jabezmcc/Prooferator/photos/Lightbulb.jpg

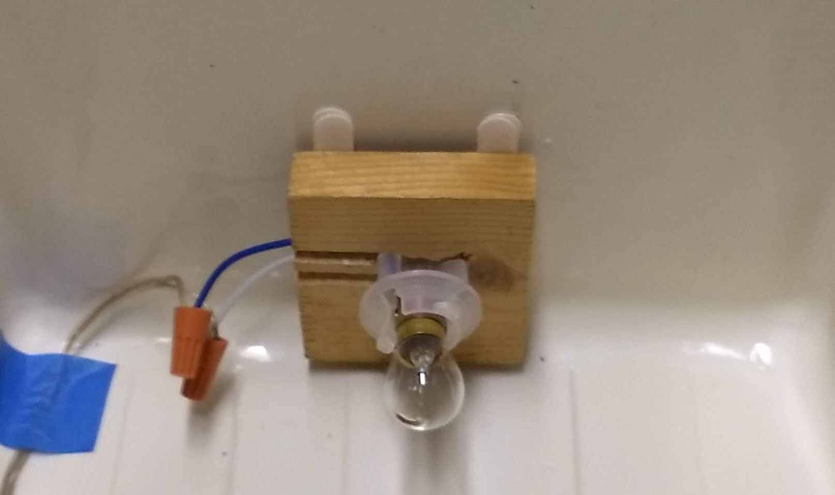
photos/Lightbulb.jpg
