jabezmcc/Prooferator/photos/Wall_wart.jpg

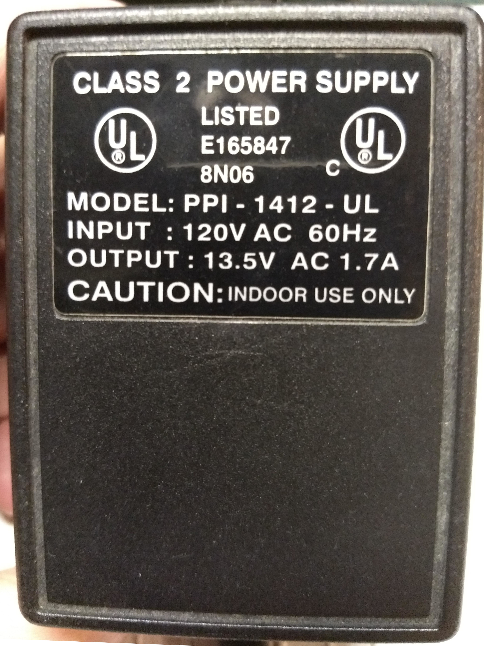
photos/Wall_wart.jpg
