jabezmcc/Prooferator/prooferator.py

# Prooferator - Arduino-controlled "proofing" box for bread dough
# (c) 2022, 2024 - Jabez McClelland jabezmcc@gmail.com
# 
# Revision history
#
# 6/22/2024 - 0.2.2: Added welcome window
#
# 6/18/2024 - 0.2.1: Fixed frozen stop button and added refresh temp button
#
# 6/9/2024 - 0.2.0:  Added threading and "updating arduino" message
#
# 3/12/2022 - 0.1.2: Trapped error when Arduino is unplugged.  Fixed initial readout window size. 
#                    Tweaked timing, changed data save query behavior.
#
# 1/22/20222 - 0.1.1: trapped possible bad inputs.  Added temp units to temp. display and y-axis
#
# 1/15/2022 - 0.1.0: First version
#
import sys
import os
import xlsxwriter
import datetime as dt
import time
import numpy as np
import serial
import pathlib
import re
import platform
import subprocess
import threading

from PyQt5.QtCore import QObject,  pyqtSignal
from PyQt5.QtWidgets import QApplication, QDesktopWidget, QFileDialog, QMessageBox
from PyQt5.uic import loadUiType

from matplotlib.backends.backend_qt5agg import FigureCanvasQTAgg as FigureCanvas
import matplotlib.pyplot as plt

Ui_MainWindow, QMainWindow = loadUiType('prooferator.ui') 
Ui_WelcomeWindow, QWelcomeWindow = loadUiType('welcomewindow.ui')
Ui_AboutWindow, QAboutWindow = loadUiType('aboutProoferator.ui')
Ui_UpdatingArduino, QUpdatingArduino = loadUiType('updating_arduino.ui')
vers = '0.2.1'

class Welcome(QWelcomeWindow, Ui_WelcomeWindow):
    def __init__(self):
        super(Welcome,self).__init__()
        self.setupUi(self)
        self.currentTemp = get_temp()
        self.setPoint = float(get_arduino_setpoint())
        self.gotNumber = self.currentTemp.replace('.','').isdigit()
        self.updateText()
        self.wradioButtonF.toggled.connect(lambda:self.unitchanged(self.wradioButtonF))        
        
    def updateText(self):
        # Do temperature label
        if self.gotNumber:
            temp = float(self.currentTemp)
            if self.wradioButtonF.isChecked():
                tempstring = '{:3.1f}'.format(temp*9./5. + 32)+'\xB0F'
            else:
                tempstring = '{:3.1f}'.format(temp)+'\xB0C'
            self.foundArduinoLabel.setText('Found Arduino...')            
        else:
            if self.wradioButtonF.isChecked():
                tempstring = self.currentTemp+'\xB0F'
            else:
                tempstring = self.currentTemp+'\xB0C'             
            self.foundArduinoLabel.setText('Arduino not found!')
        self.currentTempLabel.setText('Current temp: '+tempstring) 
        # Do setpoint label
        if self.wradioButtonF.isChecked():
            spstring = '{:3.1f}'.format(self.setPoint*9./5. + 32)+'\xB0F' 
        else:
            spstring = '{:3.1f}'.format(self.setPoint)+'\xB0C'
        self.currentSetpointLabel.setText('Current setpoint: '+spstring)

    def unitchanged(self,b):
        self.updateText()



class About(QAboutWindow, Ui_AboutWindow):
    def __init__(self):
        super(About,self).__init__()
        self.setupUi(self)
        self.versionLabel.setText("Version "+vers)
        self.licenseButt.clicked.connect(self.show_license)
        self.OKButt.clicked.connect(self.closeout)
        self.show()
        
    def show_license(self):
        p = platform.system()
        try:
            if p == 'Linux':
                subprocess.run(['xdg-open', 'LICENSE.txt'],check=True)
            elif p=='Windows':
                os.system('start LICENSE.txt')
            else:
                os.system('open LICENSE.txt')
        except:
             QMessageBox.warning(self,'Error','Unable to open license document')
                
    def closeout(self):
        self.close()

class UpdatingArduino(QUpdatingArduino, Ui_UpdatingArduino):
    def __init__(self):
        super(UpdatingArduino,self).__init__()
        self.setupUi(self)
        self.show()
        
class Helper(QObject):
    finished = pyqtSignal()

class Main(QMainWindow, Ui_MainWindow):
    plotexists = False
    takedata = True
    datasaved = False
    def __init__(self):
        super(Main,self).__init__()
        self.setupUi(self)
        self.actionExitButton.triggered.connect(self.exit)
        self.actionAbout.triggered.connect(self.openabout)
        self.startButton.clicked.connect(self.start_data)
        self.stopButton.clicked.connect(self.stop_data)
        self.updateButton.clicked.connect(self.update_setpoint)
        self.FradioButton.setText('\xB0F')
        self.FradioButton.toggled.connect(lambda:self.btnchanged(self.FradioButton))
        self.CradioButton.setText('\xB0C')
        cwd = str(pathlib.Path(__file__).parent.resolve())
        self.data_dest = cwd +'/proofingbox.xlsx'
        self.dataSaveLabel.setText('Data will be saved in '+self.data_dest)
        self.changeDataButton.clicked.connect(self.change_data_dest)
        self.refreshTemp.clicked.connect(self.single_reading)
        self.timeintervalBox.setText('0.1')
        self.setpointC = float(get_arduino_setpoint())
        self.setpoint = self.setpointC   
        if self.FradioButton.isChecked():
            self.currentTempLabel.setText('--.-\xB0F')
            self.setpointF = self.setpointC*9./5. + 32.
            self.setpointBox.setText('{:3.1f}'.format(self.setpointF))
            self.setpoint = self.setpointF
        else:
            self.currentTempLabel.setText('--.-\xB0C')
            self.setpointBox.setText('{:4.2f}'.format(self.setpointC))
        self.canvas = FigureCanvas(plt.Figure(figsize=(15, 6)))
        self.mainplot_layout.addWidget(self.canvas)
        self.ax = self.canvas.figure.subplots()
        self.ax.set_xlabel("Time")
        if self.FradioButton.isChecked():
            self.ax.set_ylabel("Temperature, \xB0F")
        else:
            self.ax.set_ylabel("Temperature, \xB0C")       
        self.ax.set_title("Proofing Box Temperature Log")
        self.ax.set_position([.15,.15,.75,.75])
        self.ax.tick_params(axis='both',direction='in')
        self.ax.set_ylim(self.setpoint*0.75,self.setpoint*1.25)
        self.ax.set_xlim(dt.datetime.now(),dt.datetime.now()+dt.timedelta(hours=2))
        self.rec_label.setText('')

    def btnchanged(self,b):
        if self.CradioButton.isChecked():
            self.setpointBox.setText('{:3.1f}'.format(self.setpointC))
        else:
            self.setpointBox.setText('{:3.1f}'.format(self.setpointF))
                
    def openabout(self):
        self.aboutwin = About()

    def single_reading(self):
        #print('in single reading')
        try:
            ser = serial.Serial('/dev/ttyACM0',9600, timeout=1)
            dummy = False
        except:
            QMessageBox.warning(self,'Prooferator','No Arduino detected, simulating data')
            dummy = True        
        if dummy:
            current_tempC = float(get_temp_dummy(self.setpointC))
        else:
            current_tempC = float(get_temp())
        if current_tempC==999.99:
            return
        current_temp = current_tempC
        unittext = '\xB0C'
        if self.FradioButton.isChecked():
            current_temp = current_tempC*9./5. + 32.
            unittext = '\xB0F'
        self.currentTempLabel.setText("{:3.1f}".format(current_temp)+unittext)
        #print('Temp is',current_temp)

    def start_data(self):
        self.takedata = True
        self.rec_label.setText('RECORDING')  
        try:
            ser = serial.Serial('/dev/ttyACM0',9600, timeout=1)
            dummy = False
        except:
            QMessageBox.warning(self,'Prooferator','No Arduino detected, simulating data')
            dummy = True
        self.wb = xlsxwriter.Workbook(self.data_dest)
        wbtimefmt = self.wb.add_format({'num_format': 'mmm d yyyy hh:mm:ss'})
        ws = self.wb.add_worksheet()
        ws.set_column(0,0,20)
        ws.set_column(1,1,15)
        ws.write(0,0,'Time')
        ws.write(0,1,'Temperature')
        times = []
        temps = []
        count = 0
        self.ax.cla()
        self.ax.set_xlabel("Time")
        if self.FradioButton.isChecked():
            self.ax.set_ylabel("Temperature, \xB0F")
        else:
            self.ax.set_ylabel("Temperature, \xB0C")  
        self.ax.set_title("Proofing Box Temperature Log")
        deltat = 0.1
        while self.takedata:
            try:
                interval = 60.*float(self.timeintervalBox.text())
            except:
                QMessageBox.warning(self,'Prooferator error','Invalid entry for time interval')
                break 
            count += 1
            elapsed_time = 0.0
            while elapsed_time < interval:
                time.sleep(deltat)
                QApplication.processEvents()
                if not self.takedata:
                    break
                elapsed_time += deltat
            if not self.takedata:
                break
            if dummy:
                current_tempC = float(get_temp_dummy(self.setpointC))
            else:
                current_tempC = float(get_temp())
            if current_tempC==999.99:
                break
            current_temp = current_tempC
            if self.FradioButton.isChecked():
                current_temp = current_tempC*9./5. + 32. 
            times.append(dt.datetime.now())            
            temps.append(current_temp)
            unittext = '\xB0C'
            if self.FradioButton.isChecked():
                 unittext = '\xB0F'
            self.currentTempLabel.setText("{:3.1f}".format(current_temp)+unittext)
            ws.write(count,0,times[-1],wbtimefmt)
            ws.write(count,1,temps[-1])
            print('plotting point',count)
            print('Current temp = ',current_temp)            
            self.plot_data(data=[times,temps])


    def plot_data(self,data=[[0],[0]]):
        if self.plotexists:
            self.lin.remove()
        self.lin, = self.ax.plot(data[0],data[1],color='blue')
        self.canvas.draw()
        self.canvas.flush_events()
        self.plotexists = True       
    
    def stop_data(self):
        self.takedata = False
        self.rec_label.setText('')
        qbox = QMessageBox.question(self,'Prooferator','Do you want to save data?',QMessageBox.Yes,QMessageBox.No)
        if self.plotexists:
            if qbox == QMessageBox.Yes:
                self.wb.close()
                self.datasaved = True
                QMessageBox.information(self,'Prooferator','Acquisition finished.\nData saved in'+self.data_dest)
        else:
            QMessageBox.information(self,'Prooferator','Please record some data first.')    

    def update_setpoint(self):
        try:
            self.setpoint = float(self.setpointBox.text())
        except:
            QMessageBox.warning(self,'Prooferator error','Invalid entry for setpoint')
            return
        self.setpointC = self.setpoint
        if self.FradioButton.isChecked():
            self.setpointC = (self.setpoint - 32.)*5./9.
        self.window = UpdatingArduino()
        
        qtRectangle = self.window.frameGeometry()
        centerPoint = QDesktopWidget().availableGeometry().center()
        qtRectangle.moveCenter(centerPoint)
        self.window.move(qtRectangle.topLeft())
        self.window.show()
        self.helper = Helper()
        self.helper.finished.connect(self.window.close)
        self.container = {'sp':self.setpointC}
        threading.Thread(target=update_arduino, args=(self.helper,self.container)).start()
        self.helper.finished.connect(self.reportoutcome)
    
    def reportoutcome(self):
        if self.container['error']:
            QMessageBox.warning(self,'Prooferator','Unable to program Arduino.\nCheck connections.')
        else:
            QMessageBox.information(self,'Prooferator','Arduino successfully updated.')
            
    def change_data_dest(self):
        fileName, _ = QFileDialog.getSaveFileName(self,"Select data destination file","./","Excel files (*.xlsx)")
        if fileName:
            strfN = str(fileName)
            if strfN[-5:] != '.xlsx':
                strfN = strfN + '.xlsx'
            self.data_dest = strfN
            self.dataSaveLabel.setText('Data will be saved in ' + strfN) 

    def exit(self):
        if not self.datasaved:
            qbox = QMessageBox.question(self,'Prooferator','Do you want to save data?',QMessageBox.Yes,QMessageBox.No)
            if qbox==QMessageBox.Yes:
                self.takedata=False
                self.rec_label.setText('')
                try: 
                    self.wb.close()
                    self.datasaved = True
                except:
                    pass
                sys.exit()
            else:
                self.takedata=False
                self.rec_label.setText('')
                sys.exit()
        else:
            sys.exit()

    def closeEvent(self,event):
        if not self.datasaved:
            qbox = QMessageBox.question(self,'Prooferator','Do you want to save data?',QMessageBox.Yes,QMessageBox.No)
            if qbox==QMessageBox.Yes:
                self.takedata=False
                self.rec_label.setText('')
                try:
                    self.wb.close()
                    self.datasaved = True
                except:
                    pass
                event.accept()
            else:
                self.takedata=False
                self.rec_label.setText('')
                event.accept()
        else:
            event.accept()

def get_arduino_setpoint():
    # returns last programmed arduino setpoint in C as text
    filename = './arduino_folder/proofingbox/proofingbox.ino'
    fin = open(filename,'r')
    lines = fin.readlines()
    fin.close()
    for line in lines:
        s = re.search(r'setPoint = (\d\d.\d\d)',line)
        if s:
            return s.group(1)
            
def get_temp():
    # returns current temp in C as text
    try:
        ser = serial.Serial('/dev/ttyACM0',9600, timeout=1)
    except:
        return '--.-'
    time.sleep(2)
    try:
        rawdata = ser.readline()
        temperature = rawdata.decode('UTF-8').strip('\n')
    except:
        print('Error reading temperature')
        temperature = 20.0 # Kludge in case of error 
    return temperature

def get_temp_dummy(setpoint):
    temperature = setpoint + 5.*(np.random.rand()-0.5)
    return "{:4.2f}".format(temperature)

def update_arduino(helper,container):
    setpointtext = "{:4.2f}".format(container['sp'])
    print('UpdatingArduino with setpoint = ',setpointtext)
    filename = './arduino_folder/proofingbox/proofingbox.ino'
    os.system('cp '+filename+' '+filename+'.bak')
    fin = open(filename,'r')
    lines = fin.readlines()
    fin.close()
    newlines = []
    p = re.compile(r'setPoint = \d\d\.\d\d')
    for line in lines:
        newlines.append(p.sub('setPoint = '+setpointtext,line))
    fout = open(filename,'w')
    fout.writelines(newlines)
    fout.close()
    u = os.system('arduino --upload '+filename)
    if u:
        container['error']=True
        os.system('cp '+filename+'.bak '+filename)
    else: 
        container['error']=False
    helper.finished.emit()

if __name__=="__main__":
    app = QApplication(sys.argv)
    welcome = Welcome()
    welcome.exec()
    main = Main()
    qtRectangle = main.frameGeometry()
    centerPoint = QDesktopWidget().availableGeometry().center()
    qtRectangle.moveCenter(centerPoint)
    main.move(qtRectangle.topLeft())
    main.show()
    sys.exit(app.exec())
