jabezmcc/Prooferator/bread_img_rc.py

# -*- coding: utf-8 -*-

# Resource object code
#
# Created by: The Resource Compiler for PyQt5 (Qt v5.15.2)
#
# WARNING! All changes made in this file will be lost!

from PyQt5 import QtCore

qt_resource_data = b"\
\x00\x01\x33\x66\
\x89\
\x50\x4e\x47\x0d\x0a\x1a\x0a\x00\x00\x00\x0d\x49\x48\x44\x52\x00\
\x00\x00\xc8\x00\x00\x00\x8c\x08\x06\x00\x00\x00\x39\x91\xe6\xe4\
\x00\x00\x2a\x42\x7a\x54\x58\x74\x52\x61\x77\x20\x70\x72\x6f\x66\
\x69\x6c\x65\x20\x74\x79\x70\x65\x20\x65\x78\x69\x66\x00\x00\x78\
\xda\xa5\x9c\x69\x92\x1d\x39\xce\x65\xff\x73\x15\xb5\x04\xce\x04\
\x97\xc3\xd1\xac\x77\xd0\xcb\xef\x73\x19\x2f\x94\x0a\x95\xea\x1b\
\xac\xa5\xcc\x54\xe4\x1b\xdc\x49\x10\xb8\x03\x09\x97\x3b\xff\xf7\
\xff\x5c\xf7\xaf\x7f\xfd\x2b\x78\x1f\xa3\xcb\xa5\x59\xed\xb5\x7a\
\x7e\xe5\x9e\x7b\x1c\xfc\x60\xfe\xeb\xd7\x7d\xff\x0d\x3e\xbf\xff\
\xbe\x5f\xeb\xfb\xbd\xf0\xf3\x75\x67\xeb\xf3\x46\xe4\xa5\xc4\x9f\
\xe9\xf3\x85\xf8\xeb\x62\xc1\xeb\xe7\xf6\xf3\x42\xc1\x7f\x5e\xef\
\x9f\x0b\xed\xef\x1b\x7c\x5f\x28\xfc\xba\xe3\xd7\x1f\x83\x9f\xca\
\x3f\xff\xbf\xc7\xe7\xf5\xf9\xf3\x75\x77\x3e\x77\x8e\xf6\xc7\x85\
\x3e\xaf\xa7\xf0\xb9\xf3\xe7\x8e\xe7\x73\xa1\x14\xbf\x5e\x0f\xf9\
\x73\xa1\x6b\xbf\x46\x14\xdf\x85\xe2\x6f\x17\xd2\x07\xd3\xe7\xf5\
\x3f\x46\x5a\xbb\xb5\x1f\x31\xf2\xeb\xeb\xc7\x58\xcc\x7e\x7f\x83\
\x29\xa4\x4f\x4c\xbe\xee\x69\xff\xfc\x9b\x5b\xbd\xfc\x6e\x75\x55\
\x4d\x8e\x19\xd6\xee\x58\xb3\x52\x89\x6c\x4a\xf5\xeb\x82\x9f\x0b\
\x7f\x5f\xf0\xcf\xff\xcf\x8d\xb5\xdd\x45\xc3\x8c\xf1\x24\x0d\xf8\
\xa4\x94\x18\xd1\x9b\x6f\xd2\xbf\x31\x0d\xfe\x0c\xfc\x37\xa4\x1a\
\xf5\x93\xff\xfa\xf9\xfd\x97\xf1\x45\x56\xa8\x0f\x8b\xbf\x07\xf9\
\x9e\xaf\x60\xb8\xbe\x7f\xbe\xe1\xeb\xd7\x94\x62\x64\xaa\x7f\x09\
\x7e\x6c\x3f\x5f\x9f\xf7\x3b\x46\x4a\x04\xe5\xc8\x27\xfa\x6f\x6c\
\x89\xb5\x4a\xdd\xff\xbe\x2a\xfe\x7c\x32\x2c\xff\x7c\x3d\x7e\x2d\
\x85\x77\xc1\x7f\xbd\xf1\x9d\x70\xe9\x33\xa2\x10\xfe\x78\xfd\x73\
\xa1\x10\x7f\xbe\x9e\x3f\x9f\x77\x3e\xf4\xf0\xfb\x88\x5e\x76\xbc\
\xa1\xf7\xe8\xc7\x6f\x41\xfe\x1e\x51\xec\x3f\x42\x51\x7e\x5d\x28\
\xfd\xfc\x42\xf9\x67\x0a\x3f\x5e\xaf\x9f\x2f\xf8\xf2\xf3\x42\xf5\
\x7c\x5f\xa8\xfe\x7c\xa3\x7d\x7f\xa1\xf5\xf8\xb7\x60\xfb\xfe\xf3\
\xf5\x60\xdf\xc1\x1e\x7f\x5c\xe8\x73\x87\xee\x7b\x7c\x5f\xfe\x5e\
\x84\x9a\xba\xde\xe8\xe1\xef\xaf\xbb\x1e\xff\xfe\x86\xd7\xbc\x7e\
\xae\xa6\xf2\x8a\x91\x0d\xff\xa3\x02\xc8\x80\x4f\x8c\x7e\xbe\x91\
\xca\x17\x30\x84\x36\xfe\x3e\xb5\x40\xd6\xb6\x7f\xaf\x3d\x56\x6d\
\xe4\xbf\x15\x25\x77\xfe\xf9\xfa\xf7\xaf\xf4\xf7\xd7\x9d\xcf\xbc\
\xf1\x5b\x8c\xec\xd7\xea\xfc\xfc\x42\x98\xdf\x99\xff\x9f\x2e\x64\
\xff\xe1\xce\xfd\x3f\xbc\x3e\xfe\xd3\x85\xd6\xdf\xa7\x46\x12\x65\
\xc5\x25\x7e\x8f\xf4\xb3\x9a\x29\x7d\xbd\xfe\x9d\xd9\xf3\x03\xce\
\x2e\xe5\xcf\x17\x3e\xc1\x9c\xf6\x8d\xda\x1f\x8c\x4e\xe3\xbd\x93\
\x7d\x8e\x22\x83\xf9\x59\xc5\xfa\xbd\x9a\x1f\xe4\x70\xbf\xa0\xc3\
\x27\xd3\x32\xb1\xf8\x23\x15\xca\x76\x24\xc1\xcc\xbf\x43\xcc\x7f\
\xf8\x9c\x8b\x9b\x17\xcb\xfb\xc0\xd7\x94\xfe\x9b\xff\x5f\xe3\x6b\
\xf2\xdf\x23\x1a\x1f\x0c\x77\xdf\x2f\xc4\xf4\x73\xc8\xbf\x7e\xd5\
\x9f\x5f\xf8\x7e\xff\xd8\xaf\x3f\xbf\x62\x54\x2c\x84\xdf\x5f\xf8\
\xf5\xeb\x3b\x41\xad\x46\xc0\x38\xa4\x58\x2b\xff\xa6\x94\xf9\xdd\
\x6a\xae\xfc\x59\x63\x32\x8d\x54\xbf\xdd\xf7\x0f\x7f\xfe\xfe\xc2\
\xe7\x7f\x07\xf9\xdf\x31\x3e\x7a\x6e\x12\x6a\xaa\x33\x32\x35\x5e\
\xa8\xbb\x96\x16\xf5\x46\xca\x40\xb9\xee\xb5\xeb\xe6\x63\x35\xde\
\x14\x78\xc5\xfc\xa7\xa2\x3e\x23\xcd\xbf\xca\x26\x7e\xbf\xe6\xbe\
\xf9\xeb\x03\x5e\xff\xd4\x55\xf9\x87\xbe\x89\x4b\xfe\x54\xae\xff\
\xfd\xf3\xe5\x93\x4b\x7a\xd7\xfd\xfe\x85\xb6\x3e\x5f\xf8\x2e\x99\
\xf0\x97\xc0\xff\x56\x4e\xfd\xfb\x06\xed\x8f\x0b\xf5\xcf\x85\x82\
\xff\x79\xe7\xfc\xa1\xeb\xb7\x2c\xbf\x5d\x68\x7e\x2e\x14\xf6\xf7\
\xd4\x3e\xf3\x9f\xcb\xff\x58\xfc\x58\xff\x58\xc1\xf9\xf3\xff\x6d\
\x7f\x15\x4a\x7d\x53\xfb\xed\x8e\xbf\xa6\x52\x7e\xfe\xff\x68\x5f\
\xd9\xf4\x9d\x43\x76\x42\xfb\x91\x73\xe7\x73\xa1\xdf\x40\xed\xa7\
\xa4\xf9\x23\xa7\xc2\xfa\x63\x84\xbf\x95\x8f\xfb\xae\x9f\xaf\x20\
\x3d\x0a\xfe\x81\x98\xbf\x05\xfc\x87\x42\xfb\xf5\xd3\x47\xb9\xb9\
\x5f\x81\x4b\x7f\x57\x6e\x20\x71\xf9\x2c\xfd\x4f\xfd\x54\x7f\xfd\
\xf9\x5e\x77\x7f\xbe\x11\xca\x1f\x5f\x48\xbf\x11\xe7\x6f\x23\xca\
\xdf\x91\x8c\x5f\xaf\xff\xba\xd0\xf9\x05\x61\x9f\x5f\xbf\xe9\xa1\
\x7b\xb7\xdd\x37\xe7\x20\x64\xae\x08\x9b\xfa\x99\xd4\xf7\x14\xc3\
\x0b\x36\x1f\x64\x61\x73\x7a\x5f\xab\xfc\xd6\x2a\x15\x7e\x6e\xef\
\x37\x14\xc7\xcf\xc3\x2f\x84\xc3\x46\x98\x4d\x7e\x2f\x98\x3e\xc2\
\x4f\x37\xe4\xb0\xc3\x08\xd7\x85\xf3\x7e\x58\x81\x42\x8c\x54\x5a\
\x6c\xfc\x19\xe3\x8a\xe9\xbd\x66\xa9\x41\x7c\xeb\x81\x9a\xea\x3e\
\x87\x1b\x1b\xa0\xb6\xa9\xfb\x98\xd6\x13\x59\x39\xc5\x7b\xdd\x67\
\x2c\xe1\xdd\xb7\xbf\xfb\x2d\x68\x78\xfb\x1d\xf8\x68\x0c\x5c\x2c\
\xbc\x25\xfe\x6f\x7e\xbb\xff\xc9\x87\xfe\xab\xdf\xf7\xae\x57\x3c\
\x4e\xc1\x9c\xe9\x05\x8c\xff\x3e\x0a\x60\x18\x5a\x39\xfd\x97\x8f\
\xb1\x22\xe1\xdb\x01\x94\x17\xe0\xef\xdf\x7f\xd0\xd1\xb7\x22\x12\
\x4d\x2a\xcc\xc6\x04\x07\x8a\xee\x5d\x62\x96\xf0\x4f\x6e\xa5\xb7\
\xd0\x89\xcf\x15\xff\x5d\xf7\xa1\xed\xaf\xef\xeb\x42\x99\x7b\x17\
\x06\x13\x12\x4b\xe0\x41\xd5\x12\x50\xb8\x2d\xc6\x16\x02\x81\x34\
\x16\x68\x04\x6f\x11\xd4\x9b\xac\x40\x28\x25\x6e\x06\x19\x33\x28\
\xc9\xda\x40\x2a\xdc\xda\xf1\x9d\x16\xde\x67\x63\x89\x5f\xaf\x63\
\x6c\x58\x89\x82\x2e\x69\xac\x0d\xb4\xc3\x62\xe5\x5c\xc8\x9f\x96\
\x8d\x1c\x1a\x25\x95\x5c\x4a\x01\x56\x8b\x95\x5e\x06\x28\x9b\x1d\
\x08\x5c\x41\x65\x39\xa4\xd1\x52\xcb\xad\xb4\xda\x5a\xb3\xd6\xdb\
\xb0\x64\xd9\x8a\x55\x43\xc9\x5a\x37\x94\x54\x4f\x18\xa8\xd2\x81\
\xee\x6e\xbd\xf7\x31\xb8\xe7\xe0\xca\xa3\xba\xc1\xe7\x07\xaf\xcc\
\x38\xd3\xcc\xb3\xcc\x3a\xdb\xb4\xd9\xe7\x58\xa4\xcf\xca\xab\xac\
\xba\xda\xb2\xd5\xd7\xd8\x90\xdc\x46\xad\x03\xe8\x6d\xdb\xee\x7b\
\x9c\x70\x48\xa5\x93\x4f\x71\xa7\x9e\x76\xec\xf4\x33\x2e\xb9\x76\
\xd3\xcd\xb7\x40\x1d\xed\xda\xed\x77\xfc\x5a\xb5\xcf\xaa\xfe\xdb\
\xef\xff\xc5\xaa\x85\xcf\xaa\xc5\xb7\x52\xfa\x5c\xfb\xb5\x6a\xbc\
\xda\xbe\x44\x57\x74\x2f\x5f\xb8\x88\xd6\x8c\x15\x8b\x39\xb0\xe2\
\x4d\x2b\x40\x42\x47\xad\x99\xb7\x90\x73\xd4\xca\x69\xcd\x90\x96\
\x54\x45\x89\x0c\xb2\x68\x6d\x76\xf0\x23\xd4\x98\x51\x23\x27\xc4\
\x72\xc3\xaf\xb5\xfb\x67\xe5\xfe\x57\xeb\x06\xf7\xff\x97\xeb\x16\
\xff\xa7\x2b\xe7\xb4\x74\xff\x9f\x2b\xf7\xd6\xcd\x9d\xf2\xdb\xba\
\xfd\x65\xd5\x9e\x87\x5d\xfe\xab\x1a\x55\x85\x8a\xa9\x4f\x54\xdf\
\xcd\x6b\x13\xcb\x8b\xee\x69\x3b\x3a\x46\x62\x69\xc7\x71\xcf\x8c\
\xa3\x9d\x3d\xe6\x61\x02\x43\xd1\x2e\xe3\x16\x04\xc0\x89\xbd\x73\
\xd5\xd5\x47\xbf\xd5\x56\xc9\x79\xe9\xab\xc3\x84\x5b\x69\xdf\x3e\
\x6a\xdd\xc1\x75\xde\xb1\x92\x7b\x3d\x96\xce\xe4\xc7\x06\xe9\xa4\
\x0c\x30\x84\xdb\x4b\x9b\x77\xd7\x3e\xed\xb4\xb4\x36\x71\x96\x59\
\x46\xbd\xb2\x9a\x2c\x67\x08\x27\xf5\xb0\x59\x0f\x5e\x81\xb2\x73\
\x9f\xf9\x0e\xd6\xbf\x2c\xaf\xd1\xf8\x0a\xe6\x52\x9b\x79\xb4\x3e\
\x80\xc2\x24\x63\x14\x18\xd0\x73\x36\x37\xc7\x36\x19\x68\xb8\xa9\
\xcd\x1a\xfb\x9d\x39\x10\xbd\xed\x52\xc3\x5d\xac\x22\xbf\x7e\xda\
\xdc\x30\x40\xb6\x5b\x47\xc8\x0d\xd3\x01\x1c\x30\x9a\xb4\x51\x61\
\x61\x6e\xf0\xb9\xef\xd4\x6f\x49\xf9\xae\x0a\xae\xa3\xc9\x33\x73\
\xe5\xaa\xbd\x93\xd9\xb5\xe9\x66\xe1\xf4\x05\x95\xb3\xda\x67\x9e\
\xcd\x5d\xb6\x62\x9b\x58\x28\x2e\x4b\x79\x73\xef\x3d\x70\x46\xe1\
\x30\xa8\xbb\x1e\xb8\x9c\xb3\x1a\x30\x11\xe6\xb2\xe6\x76\xeb\x9a\
\x17\x49\xdb\x62\x9a\x3b\x67\x96\x10\x71\x0f\x88\xf1\x13\x63\x3a\
\xa4\xdf\xd0\x4b\x76\x89\x6c\xec\x02\xf4\x13\xc5\x49\xb7\x87\xc5\
\x7f\xc9\x72\x2e\x68\xee\xb4\xb1\x89\xe1\xe8\x60\x3d\x2b\xcf\xfd\
\x0f\x83\x1f\x15\x58\x2b\xab\x13\x1c\x15\xcf\xf2\x84\x3a\xcd\x39\
\xfc\xb9\xc6\x6d\xf7\x42\xed\xb2\x0a\x66\xd3\xb3\x02\xf5\x76\x73\
\xcc\xb1\x14\x96\xbc\x93\xfd\x87\x2a\x30\x42\x7d\x7c\xd0\x8e\x45\
\xe9\xbb\xb5\x4b\x95\x81\x81\x64\xc4\xb1\x78\x06\xaa\x72\x2c\x88\
\x90\xb4\x65\x22\x84\x27\x0d\xea\x26\x94\xe6\x66\xe9\xe1\x32\xfe\
\xbe\x28\xb6\x33\x4b\x09\xb9\xb6\x90\x57\xa6\xe8\x46\x68\xac\x91\
\x2d\x1b\x33\x91\x25\x7c\xed\x34\x56\x55\x6c\xc9\xb2\x8f\x91\x54\
\x1c\x9b\xfb\x87\x75\x5d\x22\x5b\x92\x1f\xe7\x44\xa6\x4b\x9d\x93\
\x40\xe8\xd0\xac\xa2\xa9\x3d\xa7\xcd\xe2\x0d\x72\xe2\x26\xb2\xa4\
\xf9\xc9\xaa\xc5\x6a\x52\xe5\x73\x05\xf2\x6e\xcb\x02\xf4\x63\x1a\
\x51\xee\xbd\x80\x23\x7b\x5f\x3f\xf8\x58\x66\x95\x16\x17\x60\x0c\
\x89\x28\x03\x08\x75\x16\x2e\x3d\x7a\x9a\xb0\x74\x05\x07\xea\xe2\
\xbe\x15\xba\xf5\xbc\x85\xbf\x1f\x14\x98\xb3\xa1\xca\x0b\xc4\x81\
\x58\x1a\x70\x44\x70\x92\x46\x30\x67\x98\x9d\xd4\xa9\x73\xb6\xd5\
\x5b\x51\x72\x01\x14\x77\x52\x4a\xa9\x5e\xb8\xdb\x36\x50\x11\x08\
\x78\xea\xbd\x3a\xf8\x66\x51\xa0\x73\x31\x12\xc2\x57\xf3\x51\x58\
\x6b\x3f\x6b\x53\x69\x71\x82\xc0\x69\x2f\xa3\xe0\x8f\x9f\x75\xc3\
\x17\x6d\x12\xb6\xee\x77\x9c\x17\x63\x42\xfd\x45\x2d\xbc\xb3\x3e\
\xb8\x57\x64\x59\xc3\x80\xdc\x28\x90\x66\x3d\xb4\x74\xd7\x19\x65\
\xf2\x23\x59\xdb\x2c\x32\x10\x06\x14\x48\xa4\x99\xb2\xf9\x65\xf3\
\x6d\xbb\x34\xe5\xf3\x0c\x83\x60\xef\xc1\x8b\xd8\x84\x10\x37\xd9\
\x33\x7b\xc8\x2c\xb8\x9d\x6a\x85\x6b\x92\x71\xbb\xc6\x30\x63\xbb\
\x0a\x44\xbd\x14\x50\x09\xfb\xdc\x4d\x55\x8d\xbd\x12\x84\xd1\x18\
\x17\x6a\xc9\x31\xd0\x18\xc7\xb8\x7d\x7b\x80\x8d\x80\x96\x39\x53\
\x65\xb0\x91\x92\xa8\x11\xe7\xe1\xa9\xfe\x8c\xdb\x48\x94\xdd\x3e\
\xd3\x04\x36\x35\xc7\x5b\xa9\xb5\xa2\x7c\x00\x9f\xf3\x72\x65\x1c\
\xd6\x15\x33\x00\x02\x50\xb1\x24\x20\x80\x51\x92\xcd\xc5\xb2\xac\
\xc6\x5d\xfc\x64\xd1\xb3\xaa\xe1\x4e\x54\x98\xf0\xa0\x27\x46\x7f\
\x28\x29\x80\x8a\x48\xb4\x35\x3b\x0e\xb2\x31\xf3\x91\x44\xf7\xc3\
\xba\xf8\x66\x75\x8a\xe3\x9c\xc2\x82\x03\xd1\x61\x58\xce\xb3\x91\
\x34\x10\xcb\x66\xa4\x99\x19\x22\x84\xef\x3c\x38\x21\xe0\x24\x2b\
\x61\x8b\xab\xd4\x34\x3c\xb0\x67\xcf\x2a\x01\x6a\xba\x83\x3f\xe0\
\x37\xa9\xd0\x0e\x65\xc2\x1c\x16\xe2\xab\x04\x83\x7e\xb0\x6c\xcd\
\xf2\x57\xcd\xb3\x44\xed\x00\x22\x23\x67\x03\x21\x43\x3f\xf8\xaf\
\xdc\x3a\xf8\xc1\x50\x13\xb8\x5e\x9a\x40\x00\x04\xbd\x19\x0d\x4e\
\xa6\x28\xbf\x60\x33\x23\x51\xed\x52\x99\xa4\x98\x2d\xd0\x70\xd6\
\x43\x02\x5e\xb0\xf1\x78\x67\x01\x9c\x4a\x47\x4b\x33\x7b\xb9\xc4\
\x0b\xe8\x68\x01\xd0\x3d\x5a\xaa\x69\xbb\xf0\xa5\x0a\x5e\x82\x27\
\xdc\x09\xea\xc0\xbf\x0d\xd8\x6c\xf6\xa5\x50\x97\xa6\x78\x2c\xc0\
\x1f\xa4\xa2\xb2\xb0\x46\x57\x59\x52\xb3\x94\xe9\x1c\x07\xec\x6b\
\x10\x95\x36\xb6\x80\x50\xe0\x35\x83\x17\x49\xd5\x90\x2b\xe6\xd0\
\x48\x5d\xea\xc0\xbc\x10\x23\x08\x8f\x54\xec\xd4\x7c\x99\xc2\x2d\
\x90\x41\x30\xcf\x4a\xb3\x6c\xe3\x6a\x13\x00\x59\x4a\x3a\xcb\x5c\
\x8c\x4d\x85\x70\x89\x20\x64\x27\x70\xc8\xdf\xd9\x47\x6b\x24\x57\
\x6f\x2e\x91\xf0\xbe\x8e\x91\x59\x1f\xdc\xc9\xa9\xc0\xe9\x84\x18\
\x4e\x27\x9c\x40\x29\x33\x67\x59\x09\x4d\xd8\x90\x03\xae\xc8\x60\
\x22\xfd\x12\x08\x11\x30\x94\xc7\x09\xe9\x98\xab\xa4\xa1\x8a\x64\
\x03\x3b\x46\x20\x80\x24\x8a\xf6\x40\x79\x63\x1f\x90\x10\xe4\x67\
\x75\x48\x3c\x52\xc9\xeb\x3e\x96\x35\x66\x48\x3c\x2f\x60\x36\x00\
\x42\xdc\xb4\x5f\x2e\x04\x50\x99\x38\xd2\xc8\x04\xeb\x93\x60\x6e\
\x70\x47\xd8\x4a\x40\x28\xe3\x3e\x32\xf1\xee\xc8\x01\xd2\x06\x2d\
\x81\xf5\xd5\xf2\xc2\x2c\xc4\x19\x2e\x6c\x88\xf6\xb9\xdd\x96\x82\
\x40\x68\xa2\x22\xe2\xf6\xb6\x64\x0b\xa9\x73\x16\x20\x11\xfc\x49\
\x4a\x16\x20\x68\x57\xc1\xdc\x23\x02\x05\x6d\x5d\xe6\x65\x94\x02\
\xdf\xe9\x07\xb9\x93\x83\x23\x62\xad\xa2\x1d\xc8\x5c\x30\x86\x29\
\x6c\x3c\x05\xd4\x57\xa4\x13\xea\xa4\xaa\x48\x80\x86\x96\x68\x9e\
\x3b\xb3\x0e\x11\x2c\x61\x86\x47\xda\xfb\x20\xa4\x02\xf5\x49\x26\
\x38\x94\x4e\xcb\x45\x1b\xad\xc0\x93\x3e\x7d\x0a\x65\x3e\x7b\x24\
\xf1\x48\x2a\xf4\x8e\x70\x0c\xe4\x03\x4e\xb9\x59\x00\x1d\xfd\x58\
\x4c\x4a\xd2\xd9\x82\xed\x05\x2d\xf6\xba\x1d\xec\x23\x8a\xca\x8b\
\x24\x9d\x0c\x64\x5a\x42\x9f\x84\x48\x00\x49\x7e\x83\x03\x52\x25\
\x82\x4d\x9c\xc1\x7b\xdc\x53\xfb\x09\x9d\x34\xc0\xdd\x0b\xf6\x0f\
\x8c\x05\x9d\xba\x50\x36\x35\xb5\x98\x6a\x87\x86\x61\x73\x7e\x5d\
\xcc\xd1\x25\x88\xd0\x06\x42\x89\x25\xeb\x70\xef\xc2\xfe\xac\x8d\
\xac\x27\x2d\x99\xe4\x45\xab\x05\x10\xd9\x54\x55\xa0\xad\xa3\x3e\
\xcb\x5a\xda\xbd\xac\x5f\x8b\x5f\x23\x50\x5c\x27\x45\xa6\x99\xe1\
\x54\x40\x93\x83\x8e\x09\xd0\x26\x63\xb0\x72\x56\x67\x25\x58\x12\
\xe8\x2b\xc5\xa3\x83\x0b\xb0\xd8\x69\x67\x53\xb9\x45\x5c\x2a\x7a\
\xce\x13\x9b\x8b\xeb\x3b\xf0\x35\xf7\xf3\xd3\x0a\xcc\x1e\x01\xb1\
\xe8\x51\x71\xc8\x19\x2a\x0c\x64\x97\x70\x21\x5d\xc7\xa6\xac\xa9\
\xc7\x3a\x71\xd9\x20\x4b\x29\x88\xd3\x95\x0e\x81\x01\xa5\x81\x6b\
\x32\x32\xf3\x51\x12\x64\xd9\x01\xee\xa1\xdb\xd2\x1b\x20\x36\x3b\
\x71\xb9\xba\x4b\xa3\xfc\xaf\x36\x01\x01\x1e\x32\xd7\x89\x3e\xa8\
\x62\x82\x59\x23\x15\x86\x92\x8f\xc0\xf4\xae\x47\x82\x89\x79\xe2\
\xe6\x3d\x70\x4b\x99\x93\xb2\xc0\xa6\xc7\x5b\x52\x71\x91\x84\x0d\
\x4a\x9c\x4c\x32\xdf\x04\x8c\x90\x5a\xe4\x6e\x2c\x98\x54\x2c\xe9\
\x5e\x6b\x80\x00\x7e\x83\x70\xcc\xa8\x90\xfb\x56\xb4\xd8\xfb\x12\
\xd5\x12\x01\x29\x28\x1a\x96\xdf\x57\x23\x43\x23\xe5\x2b\x46\x3d\
\xd3\x79\xe2\xcb\xbb\x64\x8f\x80\x4a\x42\x06\xa6\x42\x82\x78\xb9\
\x27\xe6\x95\x00\x1c\x66\x2f\x5e\x45\x8c\x03\xc8\x5c\x1b\x0d\xc4\
\x22\xe7\xcd\x70\x50\x1e\x7e\x6f\x62\xe1\x12\x39\x8b\xac\xe6\xd3\
\x24\x69\x59\xa4\x12\xa2\x17\xbe\xe0\x4e\xe5\x6c\x55\x49\x43\xed\
\x42\x5a\x31\x3c\x55\x4d\xfa\xc4\x49\x44\x81\xa3\x46\x0d\x53\xef\
\xd0\x2c\xd0\xe0\xa0\xd5\x50\xa7\xf6\x0d\x50\x3b\xa8\x06\x3c\xfa\
\xa4\x28\x77\x85\xa7\xa1\x7a\xbe\x4b\xba\x49\xf0\x92\x6a\xb2\x37\
\xed\x20\xa2\xb8\x02\x58\x9a\x13\x91\x3b\xb6\xc8\xe9\x34\xdc\xcc\
\xc5\x5f\x3e\x99\x3c\x49\x0f\x90\x8d\x44\x15\x41\x0d\x7c\x02\xa6\
\x15\x1b\xd9\x39\xa0\x3e\xf1\x65\xfe\xa0\x06\x2a\x80\x68\xac\x41\
\x29\x92\x16\xa7\xb6\x32\x89\x09\x4c\xbb\x28\x65\x0a\x78\x2d\xf2\
\x3e\x5e\x16\x0d\x95\x70\xfd\x2d\x60\x49\x9e\xf3\x9e\x45\x48\xc7\
\xf6\x99\xf2\x13\x0b\x03\xa5\x17\x85\x7b\xb6\xa9\xac\xa1\xb8\xaa\
\xca\x5b\x70\x3f\xb4\x28\xa5\x90\xa1\x56\x12\x8c\x85\xab\xbb\x4c\
\xa4\xb1\x11\xb9\x0e\xe8\xdf\xbd\x1b\x9c\xc3\xd7\x93\xf2\x06\x40\
\x59\xb5\x82\x69\x5d\x74\xb8\x16\xde\x26\xc9\x2f\x38\x84\xee\xd0\
\xcf\x91\x3c\xa0\x8a\x40\x30\x89\x33\x4b\x52\xb7\x4c\x10\x5b\xd5\
\x93\xe7\x8b\xbe\x25\x05\x0b\x46\x28\x68\x5a\xd0\x42\x30\x4a\x62\
\xd7\x0a\x02\xf3\xa6\x43\xe4\x95\xa0\x4d\x0a\xf0\x5c\x46\x8d\xcf\
\x47\x49\x5a\x96\x7e\x18\x9f\x25\x6f\x90\x97\xd3\x1f\x24\x1c\x24\
\x6c\x72\x32\xa8\x40\x6d\x53\x83\xfc\x13\x09\xc1\xbc\x1a\x23\x4a\
\xe0\x37\x53\x47\x3c\x54\x04\x7c\xa1\x9a\x4c\xe2\xda\x9e\x66\x14\
\x06\x80\xfe\x64\x06\x18\x45\x19\x6b\x39\xa5\x72\x23\xde\x12\x5e\
\xc7\x9f\x1d\x30\x94\xf5\xac\xe6\x1a\xae\x80\x2c\x6a\x28\x12\xe0\
\xeb\x46\x08\x7f\x4d\x56\x0d\x95\x3f\x16\xb3\xab\x65\x44\x78\x8e\
\x32\x9c\xa7\x8a\x59\x7d\x03\x0b\xc1\x91\x13\xfd\x6e\x7c\x47\x54\
\x72\x59\x7e\x16\xac\x62\x3c\x70\x62\xab\x6a\x58\xd4\xd7\x80\xa2\
\x37\xde\x91\xe0\xe5\xb2\x50\x32\x93\xa5\x42\x63\x92\xb6\x44\x32\
\x20\x10\x62\x86\xfa\xc8\x79\xae\xbf\x72\x05\x25\xe3\x70\x58\x32\
\xf9\xca\x55\xee\x46\x1a\xc1\x57\xc0\x01\xf8\x83\xce\x6c\x72\x65\
\x12\xce\xc3\x16\x18\xe5\x59\x46\x7f\xcd\xe0\xcd\x25\x5a\xdb\x2c\
\x22\x3e\xac\xcb\x63\xed\x5a\x1c\x72\x88\x21\x99\x1c\x4c\xc2\xac\
\x19\xb3\x80\x77\xf0\x19\x64\x6c\xe2\x1b\x4b\x05\x73\x61\x12\x7e\
\xc5\xb7\x05\xa4\x1d\x2d\xb1\x39\x89\x9a\x28\x78\xec\xb7\xf5\xe2\
\x5d\xa4\xd6\x91\x84\x67\x6b\xc7\x03\xb5\x32\x01\x62\x34\x16\xd3\
\x97\xa3\x21\xbd\x90\x5e\xa0\x22\xcc\x40\xb9\xa0\x5f\x23\x6b\x84\
\xfc\x97\x83\x04\xa4\x37\x21\xdf\xbc\x74\xaa\x43\xf3\x8d\xdd\x35\
\x40\x72\x04\x08\x46\x52\x1c\xbe\x1e\xf8\xf4\x00\x42\xc4\x06\x92\
\xe9\x26\xa6\xdd\x1d\x31\x4f\x22\x80\x84\x20\xe4\x13\x09\x0d\x61\
\x8b\x30\xf1\xc4\x08\x66\xe7\x1f\x5f\x20\x19\xaa\xb7\x03\x6a\x80\
\x67\xe5\xfe\x1b\x55\x8f\x7c\x11\xcb\x49\x40\xc0\x71\x88\x55\x66\
\x86\x24\xb2\x7e\x41\xcb\xd0\x24\xdc\x8e\x94\xd8\x26\x46\x93\x51\
\x50\x38\x64\x4f\x89\x59\xec\x46\xa0\x3d\x28\x82\xf9\x21\x26\x70\
\x24\xa8\x56\x2c\x4a\x3d\x9d\x4c\xa9\x9d\xb9\xda\x16\x3c\xe1\xfe\
\xc3\x66\x9d\x2a\xd4\x36\x8e\x0b\x0d\x3c\x55\x06\x64\xe0\x4a\x27\
\x5b\x0d\x41\x27\x07\xcf\x08\x26\x69\x87\xc3\x03\x61\x59\xbd\x25\
\x3b\x88\xfb\x23\x43\x81\x80\x06\xac\x32\xe7\x26\x5f\x50\xed\x44\
\x73\xa5\x1b\xaa\x05\x2e\x9c\xe4\x8e\x0c\x3b\x57\x93\xa9\x62\xee\
\x0d\x9a\xc2\xad\x62\x62\xba\xe8\x57\xea\x14\x29\x2b\x30\x3a\x90\
\x2f\xf5\x73\xba\xce\x89\x6f\xc5\xc6\x74\xc7\x4a\xc5\x8d\xd3\x49\
\xda\xab\x41\x3d\x81\xfa\xb9\xbf\xf9\xdd\xd1\xd0\x5f\x05\xf8\x66\
\x56\x1d\x85\x83\xea\x91\x12\xd7\xda\xaf\x40\x99\x91\xd5\x0c\x98\
\xfa\x1a\xb0\x38\xc0\x86\x06\x6c\xf8\x4e\x2f\x73\x4c\x0a\x80\x73\
\x5d\x3e\xcd\xe3\xb6\xc8\x18\x34\x37\x63\x40\x32\x2f\xdf\x64\x4e\
\x2f\x8a\x8f\xef\x10\x99\xd4\x0a\xee\x04\xc8\x62\x90\x71\x39\xdc\
\x3e\xd2\x00\x95\x0a\x73\x13\x24\xc0\x7d\x43\xf9\x94\xc7\x18\x2a\
\x5d\x70\x87\x2f\xca\x78\x41\x11\x90\x19\xc5\x01\x3d\x61\xbf\xc9\
\x14\x8d\xab\x9e\x7c\x56\x04\xf0\xdd\x94\x83\x26\xfa\xf0\xbf\x18\
\x04\x1b\x73\x41\x77\x43\x56\x50\x2b\x2c\x15\x9e\x01\xbf\x45\x45\
\x80\x46\xe8\x4c\x0c\xce\xee\x93\x32\x66\x0a\x70\x0f\x49\x19\x04\
\x0b\x0b\xa6\x45\x50\x93\x01\xb7\x37\x0c\x34\xb0\x3a\xf2\x85\x5f\
\x54\x1a\x48\x84\x53\x44\x06\x09\x22\xbb\x50\x3e\x0a\x7d\x73\x4d\
\xc2\x5c\x40\x58\x00\x06\x68\xf0\x4f\x00\x10\x78\x87\x72\x04\x44\
\xb1\xf3\x28\x30\x3e\x4a\x2d\x9e\x4d\x3d\x62\x32\xc1\x0c\x44\x38\
\x9f\xe3\x0f\xaa\x8d\x94\x64\x32\x5e\xac\x8c\x82\x19\x88\x2e\xf2\
\x34\x0f\xa9\x49\xdc\xa1\xbd\x56\x06\xb0\x48\xaa\xa6\xa1\xd8\x36\
\x75\x0a\x62\x70\xfb\x90\x66\x2c\x35\xa0\x0c\x91\x3d\x58\x33\x02\
\xd9\x2f\x30\x79\x6a\x52\x22\xe6\x61\xda\x78\x90\xd8\x5a\xb2\x61\
\x8e\x15\xa6\xb0\x76\xcf\x39\x42\xd7\x5b\xf4\x8f\x0a\xe6\xd5\x35\
\x58\xfb\x8c\xf8\xe0\x85\x1b\x76\xd6\xed\x71\xb0\x32\x44\x31\x50\
\xa6\x0d\x11\x03\x13\xe0\x51\x22\xce\x36\x3a\xa4\x17\x66\x70\x4c\
\x31\xb8\xa4\xe2\xc1\xf7\x11\x43\x6c\x01\xec\xe2\x33\xc2\x0f\xce\
\x61\x11\x97\xb4\xac\x8e\xca\x91\xea\x23\x87\xa3\xcd\x06\x48\xc2\
\xda\x68\x18\xb4\x9d\x1c\x8c\xea\x45\x2c\xa6\x3d\xaf\x2f\x2f\xe1\
\x61\xab\x01\xc5\x36\x79\xee\x23\x13\xe4\xb3\x04\xbc\x10\x0b\x10\
\x94\x52\xde\xb8\xec\xf5\xb6\xcb\x93\x8c\xe8\x0e\x91\x60\x8f\x46\
\x81\x22\xf4\x1a\x38\x81\x64\x64\x82\x03\x41\x46\x1e\x19\x62\x89\
\xc1\x21\x32\x70\x7d\x65\x29\xbc\x06\x9e\x1a\x05\x01\x24\xea\x2b\
\x31\x6a\xf9\x37\xb5\xd4\x1d\x06\x6a\xa3\x78\x9a\x5a\x0e\xe0\x34\
\x01\xeb\x01\x5a\x2a\xe2\x86\xda\x91\x74\xa4\x04\x74\xba\xdc\x06\
\x59\x8d\x88\x03\x42\x61\x12\x00\x00\x8b\x80\x9b\x63\x80\x08\x2d\
\xdf\xdc\x00\x87\x58\x28\x44\x8f\x40\xac\x0f\x19\x9b\x75\xce\xb9\
\xda\x45\xc6\xa5\xe3\xbf\x4b\x9b\xe8\x23\xec\x33\x64\xa8\x2d\x4f\
\xc2\xce\x35\x8c\x4f\xa2\x14\x45\x3b\x80\x96\x39\xd9\x10\x54\xf4\
\x30\xd6\x79\x2b\x2e\xc0\x2e\x37\x40\x0d\xa6\x79\xf0\x69\xe1\x1d\
\xb4\x79\xe5\xba\x49\x38\x91\x73\x20\x07\x44\x0a\x09\x03\x18\xe4\
\x84\x74\x7f\x6a\xae\x2b\x3b\x03\xdc\x82\xf3\x62\xe8\x40\x7d\xe6\
\xe6\x41\x44\xed\x53\xe5\x9a\x01\xcf\x0e\xc9\x73\x9d\xac\xcd\x38\
\xf8\x8a\x5c\x97\x87\x40\xd7\x2d\x71\x60\x78\xe5\xe7\xce\x91\xdd\
\xd1\x06\x17\x13\x93\x08\x43\x41\x61\x6c\xd1\x4f\x1b\xde\xc2\x03\
\xc6\x8c\xb9\x67\xee\xa8\x5e\x2e\x80\xee\x5f\xd8\x03\x0a\x00\x34\
\xe6\x7d\xee\x22\xe2\x0c\xc1\x91\x9a\x88\x36\xcc\x01\xe1\x79\x1b\
\x45\x8d\x74\xcc\x72\x06\x00\x6e\xc0\xcb\xf9\x5d\xc8\x67\x8c\x36\
\xf4\x46\x79\x1c\xae\xc5\x82\x26\xd8\x94\xf0\x2c\x50\x89\x5c\x61\
\xdd\x5d\x5f\x6b\xa9\x74\x54\x72\x03\x0f\xbd\x05\x1a\xe0\x18\xa5\
\x0d\x8b\xe2\x6d\x53\xc6\xea\x43\xe2\x9d\x41\x40\x55\x14\x1f\x6a\
\x07\xbe\xc4\x9a\xca\xe3\x55\x4a\x13\xac\x45\xd6\x00\x2d\x30\xf5\
\x1c\x81\x1a\xc1\xa5\xb2\xd2\x73\x7a\xf4\xf5\x7d\x0d\x12\x10\x76\
\x06\x68\x59\x63\x5c\x69\x98\xc5\xb4\xc3\x88\x62\xa3\xac\x3a\xc5\
\x6b\xe4\x36\x8a\x61\xad\xe0\xb0\xc1\x08\x58\x1c\xee\xa8\x7c\x8a\
\xd8\xb1\x08\x7b\x63\xfc\x4e\x81\x94\x64\xcf\x11\xa4\x80\x42\x8f\
\x10\x2b\x58\x2c\x49\xfb\xb5\x4b\xc1\x72\xe0\x78\x48\x7e\x54\x6b\
\x96\xaa\x7d\xb9\x85\x34\x64\xb9\x31\x51\x97\xd9\x4c\x68\xd9\x44\
\xdb\x65\x3c\x70\x8d\x4d\x7b\x0d\x8d\x7c\x5f\x4b\x7b\x34\x41\xa7\
\x86\x90\xc6\x3b\xbb\xb3\xb7\x83\x42\x66\x8b\xe4\xa1\x92\x48\x20\
\x13\xc9\x6d\xb0\x11\xab\xb7\xa0\x5a\xf9\xba\x0b\x06\x1c\xc4\x31\
\x3f\x68\xe7\x6b\xad\x78\x0a\x50\x51\x65\x3c\x01\x93\x29\xe7\xc2\
\x88\xd1\xd9\xc0\x21\x81\x4b\xb0\xe9\xc2\xa4\x22\xef\x61\x27\x90\
\x95\x84\x67\xa0\x1e\xe2\x0d\x1a\x8e\xb8\x3e\x2e\x2e\x50\xb3\x78\
\x82\xa4\x23\x63\x70\x65\xf2\xd0\x19\xce\x5a\xcd\x69\x5f\xcf\x87\
\x53\xb5\xf9\xe7\xb9\x2b\x3c\x48\x59\xb1\x84\x13\x6b\x79\x10\x38\
\xf0\x44\x64\xd9\x28\x33\xa6\x30\x0a\x8e\x22\x68\x37\x83\xd2\xc7\
\x62\x78\xfc\x17\x04\x46\xa0\xb1\x10\x09\x62\x2c\x09\x4c\x04\xfd\
\x63\xe5\x62\x09\xd8\x25\xd6\xb0\x8a\x96\x76\x92\xb6\x7d\xe0\x39\
\x23\xd2\x40\xfa\x56\x65\xec\xb3\x54\x66\x95\x41\x7e\x8d\x27\x33\
\x3a\xa3\x1c\x70\x0e\xda\xd7\x62\xaa\x39\xe8\x18\x9c\x30\xe0\xa9\
\x35\x3b\xb0\x14\x92\x80\x58\xf1\x9f\x60\x04\x26\x21\x52\x52\x1b\
\x24\x44\x70\x75\xf2\x5e\x24\x97\xf2\x01\xd8\x40\xa6\xc8\x1c\xd5\
\x2d\x52\x75\x60\x3a\xa0\x11\x68\xb8\x2c\x00\x0a\xc9\x94\x6c\x9b\
\x47\x63\x2c\x95\x1e\x09\x4d\xfe\xe7\x59\x3c\x52\x9d\xa8\xea\x30\
\xaf\x21\x56\x0a\x52\xd8\x59\xe3\x1e\x1b\xc9\x31\xd7\xec\x0c\xa3\
\x95\xb7\x3b\x54\xa5\x47\xce\x01\xc0\x8a\x6a\x4e\x10\xaa\x33\x70\
\x0d\x01\x7d\x2e\x2b\xc0\x58\x81\x7b\xc8\x8d\xb2\xc0\x05\x3a\x82\
\xc0\x4a\xeb\x20\x22\x00\x0a\x1b\x67\xc7\xe7\x09\x10\x69\x90\x18\
\x09\xee\x8e\x97\xb0\x7a\x62\x21\xed\xbd\xcb\xa8\xe3\x51\x92\xb6\
\x29\x48\x6d\x0f\x60\x40\xe6\x1d\x3c\x42\xcb\x83\x81\x1a\xa8\x44\
\xfc\xf6\x54\x03\x94\xba\xe5\xb1\xb5\xd9\x83\x69\x91\x34\xbe\x52\
\xe1\x60\x33\x30\x83\x35\x41\x6e\xe1\x4b\xaf\x92\x62\x3c\xd7\xd2\
\x61\x11\x9d\x4e\x62\x82\xa8\xbb\x0a\xe1\x43\x14\x21\x43\x73\x5e\
\x3d\x20\xda\x1d\x43\x61\x09\x28\x31\x4e\xf8\x23\xca\x83\xcb\x1f\
\xf8\xb6\x93\x76\x5b\xd1\x0e\xa4\x2f\x04\xb8\x9c\xd7\xd9\x27\x31\
\xb9\x67\xf4\x51\x2e\x7a\x1b\xf5\x13\x4b\x20\x07\x19\xf3\xb9\x20\
\xad\xe1\x96\x50\x94\x1b\x6e\x9e\x04\xe7\xb0\xa2\xad\x93\xdf\x3d\
\x2f\x01\x4b\x03\xdf\xf2\x72\x1d\xde\x38\xed\x28\xbe\x0c\x1b\xbf\
\x5c\xb4\x0f\xbe\x45\x3f\x08\x3d\x92\xe1\x50\xad\xda\x22\x88\x58\
\x51\x38\xb5\x0b\x2a\x8d\xf1\x29\xfb\x6a\xae\x17\x40\xce\xd1\xbc\
\x43\x51\x10\x83\x6b\x1b\x9c\xdb\xe4\x9a\xa9\x7a\xb4\xbb\xa9\xa4\
\xc3\xcb\x6c\xf2\x15\x57\xd0\x04\x48\x05\x99\x82\xca\x69\xc0\x02\
\xfa\x16\x21\xf8\x40\x17\xfa\x03\xa3\x1d\x33\xd9\x3a\x10\x0a\x1d\
\xd3\xa4\xad\xa7\x25\xc6\xc3\x66\x48\x89\x19\xd8\x86\x0c\xbc\x72\
\x6f\x4a\xf6\x4e\x72\xd5\x93\xb4\xdb\x65\x48\x0d\x90\x0a\xae\xb9\
\xa2\xda\xe6\x1e\x0d\x61\x20\xc9\x53\x0c\xa3\x12\xe5\x6a\x5a\x07\
\x01\xad\xad\x27\xb1\x05\x5a\x84\x05\xe4\xcb\xc4\x9d\x70\xd4\x9c\
\x18\xfb\x91\x34\xd4\x4e\x1d\x8a\x0e\x73\x81\xcd\x02\xee\x9f\xa8\
\x6c\x5d\x7b\x54\xd4\x36\x08\xbf\x64\xad\x61\x13\x96\x2f\x20\x42\
\x59\x6a\x6d\x70\x61\x94\xb4\x45\x3a\xaf\x2e\x44\x5d\x51\x92\x15\
\x55\x02\x0b\x13\x4c\x47\xc0\x01\xe5\xbe\x74\xf4\x30\xa3\x94\x28\
\x6b\x85\xe6\x18\xf2\x40\x47\xe7\x19\x49\xc7\x33\x8a\x86\xce\x0a\
\x36\x33\xaf\xc8\xc5\xb2\xb1\x37\x79\xaa\xdb\x0d\x82\xc1\x35\x3a\
\xf2\x1a\x94\xc6\x19\x07\xea\x7a\xf4\x09\x80\x66\x66\x66\x0d\x8b\
\x87\x3d\x6e\x29\x64\x13\x09\xa1\xde\x25\xb7\xb7\x21\xa5\x4e\x50\
\xe8\x48\xe1\x95\x3d\xa2\x13\xad\x77\x8b\x63\xbd\x25\xd8\xa9\x6f\
\xfc\x03\x95\x0b\x16\x90\x20\x73\x82\x5e\x60\xd2\x4e\x92\x11\x99\
\x75\xd6\xb1\x5e\xd1\x06\xee\xdb\xa4\x86\x9f\xa5\xb9\x93\x8e\xe1\
\x80\xe6\xb6\xcc\x2d\xb9\xf0\x28\x49\x56\x70\x07\xd5\x10\xc8\x91\
\xb2\x80\xbc\xd7\x46\x63\x09\x0a\x79\xbf\x81\x76\x95\xb2\x8f\x2d\
\x93\xd2\x0c\x3c\x4f\xfc\x84\x20\xfa\x60\x37\x50\x5c\xc9\xa1\x5f\
\x40\x38\xa2\x91\x16\x24\x98\x3c\x26\x2f\x72\xab\x22\x0b\x07\x9c\
\xb6\xa4\xcc\xd2\x19\x06\x57\xc7\x71\xf2\x25\xe8\xbd\x6a\xdb\x8e\
\x45\x82\xc1\x28\xce\xeb\x91\x89\x0e\x2a\x3f\xd9\x6b\x07\x05\x3a\
\xb0\x5e\x01\xb7\x1b\xb5\x57\x89\xc6\xb8\x0a\x90\x04\x3b\x2b\x71\
\xb5\xc1\xdb\xa8\xbd\x4e\x06\xd5\x02\xfd\x55\xdf\xe1\x14\x98\xf6\
\x02\x6d\xdb\x31\x91\x12\x02\xe8\x59\x16\xcc\x5f\xde\x41\x06\x6c\
\x2f\x57\xbd\x29\x3f\x54\xfd\x12\xec\x46\x09\x6f\xc8\x81\xe2\x26\
\x37\xd1\xa3\x14\x4d\x0f\xe9\x1d\x70\x81\x41\x3e\xbb\xac\x9e\x24\
\x2a\x88\xb4\x7d\xe0\x87\x1a\x85\xbf\xe1\x5d\xa3\x74\xd4\x60\xc9\
\xe4\xc8\x9b\x97\x7f\xd2\x52\xe8\x83\x56\x49\x00\x96\x51\x72\xf4\
\x53\xd7\x15\x9d\xcd\x48\x4c\xd6\x17\x74\x90\x31\x52\x1b\xd7\xd6\
\x49\xd5\x22\xfd\x32\x2e\x63\x6b\x9b\x11\x97\x97\x6e\x17\x6c\x76\
\xca\xe2\x92\x21\xf2\x2e\xb0\xfd\xdb\x1e\x3b\x73\x57\xbc\xc8\x22\
\x23\x08\x28\xe8\x94\xb4\x11\x67\xc2\xb9\xa5\xe3\xc8\x89\x2e\x22\
\xbd\xe1\x49\xea\x84\x6f\x11\x47\x24\x06\x1a\x1d\x29\x81\xc4\x01\
\xaf\x40\x77\x93\xc3\x64\x35\x5d\xac\x1b\x2d\x8c\xde\xa4\x14\xa6\
\x88\x33\x15\x75\xf1\x42\xca\x14\x36\x77\xc3\xd6\x42\xf5\x01\x7f\
\x01\x30\xf2\x8f\xb8\x11\xfc\x00\x83\x3b\x70\xae\x83\x45\x96\x34\
\x8e\xeb\x50\x52\x93\x38\x4c\x61\x3d\xca\x5c\x96\x5d\x06\xcb\x83\
\x9a\xb0\x34\x5f\xb8\xda\x81\xca\x85\x89\x96\xa0\x33\x50\x96\x60\
\x66\x24\x27\xe4\x4d\x62\x52\x94\x45\xd9\xd3\x10\x11\x57\xce\x78\
\xea\x5c\x18\xa6\x03\xe9\xfb\xdb\x67\x7e\x60\x4d\x75\xa0\x71\xb5\
\x89\x8e\xf2\xc2\x73\x01\xb9\xa8\x55\xa9\xee\xf4\xf0\x89\x42\xa7\
\x4e\x10\xfa\x5e\x87\x99\x47\x87\x01\x8c\xa8\x78\xeb\xf9\x9c\xb7\
\x87\x15\x86\x5a\x74\xd1\xf7\x43\xe9\x43\xe6\xe0\x61\x0b\xae\xb2\
\x1f\x1d\x08\xeb\xb0\x5b\x9b\x06\x10\x85\x42\xa7\x6d\xd2\xad\x84\
\x04\xec\xb8\x1a\x2f\x37\xb9\x20\xcc\x3c\xe0\xa1\xf3\x28\xf4\x30\
\x11\xf7\x00\x86\x16\x9a\xfc\x99\xb0\x49\xf0\x1b\x55\xd0\x79\x83\
\x7a\x1e\xed\x1c\xe0\xc9\x2a\xc1\x1e\x31\x10\xd3\x71\x34\x55\x5c\
\x10\x84\x4e\x2c\x05\x3b\x94\x65\xbb\x75\x7e\x9d\xb8\x19\xa4\x3f\
\xc9\x60\x9d\x2d\x12\x10\xb0\x7b\xab\x79\x18\x4a\xc5\xc1\x74\xbc\
\x37\x25\xa2\x43\x3a\xac\xbc\xf4\x94\x32\xb1\x23\xf3\xc9\x76\x9f\
\x9b\xce\x78\x53\x92\x4f\xd2\x18\x30\x5f\xc0\x0f\x96\x18\x2d\x8a\
\x2b\xc7\x00\x16\x6d\x51\xc3\x92\x71\x79\xe4\xa7\xbb\x08\xad\x66\
\xa4\xfc\xd1\x4a\x52\x28\x84\x8b\xaa\x06\x7b\xf1\xa1\xe0\x60\xf1\
\xd8\x6b\xac\xe1\x73\x5e\x11\x3c\x8a\x08\x20\x3f\xc4\x0c\xcb\x23\
\xa9\x75\x6e\x3a\xc8\x02\xb7\x83\xaa\x9e\x84\x3f\xa4\xeb\x56\x57\
\x6e\xd0\x69\x16\x35\x89\x46\x85\x37\xbb\x9c\xf6\xcb\xdf\xc6\x8c\
\xce\xc4\x93\x46\xed\xb5\xec\x48\x4d\x00\x3c\x44\x0a\x95\xd7\xf1\
\xb4\x92\x95\x4b\x87\x74\x7b\x10\x49\x28\xe2\x68\xdb\x6e\xd9\x85\
\x3f\x75\xbc\xa3\xc5\xf3\xda\x6d\x8e\xc4\xa2\xa3\x7e\x9f\xb5\x51\
\xbf\x81\x91\xf1\xd0\x23\x8a\x99\x71\xba\x10\x0b\xaa\x47\x9d\x55\
\xca\x74\x26\x0b\x95\x52\xc4\xea\xcc\x3c\xef\xc8\x99\x9c\xc3\xdd\
\xe6\x17\x0e\x92\x51\x27\xec\x80\x1b\xeb\x42\xba\x68\x47\x7c\x22\
\x09\xac\x25\x37\x65\xcb\xdf\x61\x0d\xb0\x9d\xb8\x46\xd6\x06\x29\
\x90\x44\x60\xf3\xac\x24\x83\x8e\x13\x7a\xd6\x31\x0e\x09\x73\x20\
\x48\x64\x3b\x6a\x0b\x95\x87\x73\x22\x6c\xda\x9a\x04\xfc\x37\x79\
\xda\xa1\x98\xa9\x74\xbb\x91\xb8\xe2\xa8\x28\xee\xdc\x70\x0e\x40\
\x4c\xed\xda\x11\xc3\x3c\x8a\xad\xa8\x50\x25\x2f\x71\x1f\x86\xb2\
\x9d\x28\x32\x48\x07\x44\x40\x1e\xa3\x54\x74\x7e\x21\x4b\x80\x35\
\x00\x5e\x42\x96\x3e\xc6\xaf\xc9\x57\x0f\xa4\xbc\x28\x8a\xd0\x83\
\x36\xc1\xea\xc6\x14\x40\x30\x7e\x02\x96\x18\xdd\x28\xf1\xa5\xce\
\xf4\xe3\x10\xf5\xda\xdd\x9b\xe0\x64\x15\xc6\xa2\x02\x59\xd3\xaa\
\x3e\x0a\x49\x79\x24\xe6\x98\x3a\xa1\x42\xcf\x15\x78\x00\x0e\x91\
\xc3\x64\x8a\xa3\x17\x94\x20\x10\x55\x90\x21\xf9\x05\x5b\x62\x06\
\xa5\x71\xb3\x0e\x03\xa8\x36\x06\x89\x2d\x00\x25\x71\x66\x84\x76\
\x75\x71\x00\xb4\xe5\xcb\xf2\xd0\x0b\x75\x67\xda\xd5\xad\x22\x00\
\x44\x75\x1f\x97\x42\x77\x4b\x1b\x78\x7e\x45\x11\x5f\xdd\x14\x69\
\xde\x5a\x41\x1d\x7d\xf3\xd6\xdc\x06\x0a\x5f\x21\x31\xc8\xbc\x77\
\x84\x9d\x47\xd2\x39\x14\x01\xf0\x79\x17\x6a\x71\x32\xd9\xdb\x9d\
\x32\xb1\x13\x4d\xd6\x2a\x50\x58\xdc\x15\x9d\xa2\x43\x03\xc3\xe4\
\x60\x2a\x40\x5f\x66\xb5\xd4\xfe\x00\x6c\x24\x8c\x05\xe1\x41\x45\
\x73\xfb\x82\xf4\x29\xcc\x8f\x0c\x3b\xc5\xb5\x0b\xab\xe2\xc8\xdb\
\xa8\x2b\xca\x01\x27\x2a\x9b\xd2\x00\x55\xd4\xd9\x01\xa7\x5e\x51\
\xe2\x09\x3a\x0f\xd6\xb6\xc6\xf3\x14\x3b\x5a\x64\x3d\xb7\xb4\x93\
\x21\xd7\x2d\x81\x90\x47\x87\xff\x13\x84\xa7\x54\x8c\xfb\x1f\x6d\
\xbf\x13\xa7\xba\x40\x02\xaf\x3a\x3e\xb1\xcb\x83\xc1\x9b\x7b\x51\
\x41\xe4\xe7\x17\xa4\xc3\x54\x4b\xa7\x8a\x58\xad\xee\x82\xac\x1d\
\xd0\x16\x44\xf9\x26\x03\xbb\xa4\x02\xe4\xd7\x6a\xbc\x18\x70\xc4\
\xdf\x21\x8f\x34\x51\x98\x5b\x06\x9a\xe1\x60\x45\x17\xb2\x0c\x50\
\xd1\xf1\xf3\x82\xc2\x9f\xa9\x19\x72\x0c\xac\x34\x36\xb6\xa9\x57\
\x44\x87\xbe\x90\xbf\x36\x6c\xa4\x00\x75\x22\x29\xbe\x5c\x28\xa0\
\xf3\x76\x3c\x4a\xc8\x45\xa7\x4c\x28\xe0\x56\x82\x4c\x68\x53\x8f\
\x16\x9f\xcf\x8d\x1b\x8d\xa3\xb5\xc6\xd1\x11\xdd\x8b\xc8\xd3\xbe\
\xab\x76\x66\x67\x84\xa0\xb7\xce\xbf\x64\xf2\x12\xc6\x33\xab\xb1\
\xa6\x6f\x42\xce\x28\x98\x1c\x73\xd7\x85\xa0\x13\xed\xd5\x08\xfa\
\x8f\xfa\x3d\x29\x33\x3c\x14\x52\x4f\x46\x39\x21\x32\x28\xbe\xe5\
\x97\xe8\x60\xab\xcd\x52\xb6\x52\xfc\x84\x79\xca\x42\x75\xca\x6e\
\x7b\x67\x11\x30\x13\x58\x9c\xb7\x41\x74\xa9\x91\x32\x3d\xe4\x84\
\x4d\x97\x9c\x66\x49\xc6\x2a\xda\x3b\xbf\x5d\xcd\x20\xe8\x4d\x70\
\x70\x19\x4a\x94\x7f\xd0\xec\x8d\xe2\xc6\x4b\xb8\x83\x76\x85\x8e\
\xc5\x4f\x69\x6a\x37\x10\x83\xea\x1b\x54\x0c\x59\x98\xf8\x5d\x31\
\x12\xff\x0a\x2a\xf9\x02\xc9\xc2\x1a\xe1\x07\xd4\x7c\x74\xa0\x57\
\xfc\xa6\x38\x55\x8d\x4c\x68\x9a\x71\x8f\xa8\x21\x80\x56\xc5\xd4\
\xbf\xb0\x21\x05\x56\x0c\xc5\x00\x92\x5e\xf2\x59\x2d\x1c\x3a\x72\
\xa1\x9a\xf2\x60\x16\x55\x7e\xa4\x21\x14\x37\xd8\x54\x23\x45\x4b\
\xaa\x10\x76\x0a\x0e\x4f\x25\x7b\x0d\x54\xb5\xfa\x1a\x92\x90\xdb\
\xb8\xe5\x80\x0c\xc1\x7d\xe5\x1d\x24\x37\x8e\x90\x02\xf0\x36\x81\
\xaf\xba\xad\xd1\x4f\x6a\xa4\x49\x0e\xa3\x04\xee\x62\xde\xc9\x3e\
\x3c\xc3\x91\x0e\x23\xe9\x1a\xa3\x1e\x41\xf1\xc9\x45\x9b\xb7\x73\
\x69\xa7\x77\xa2\x04\x00\x2f\x1d\xba\x6b\x7f\x0d\xef\x70\x27\xa0\
\x85\x7a\xd0\x4e\x04\xa9\x22\x31\x48\xa1\x62\x1c\x2b\x36\x04\x9b\
\xc1\x08\x19\x33\x81\x40\xe9\x8f\xbe\x64\xf9\x8d\xa1\x6d\x95\xe1\
\xd0\xd9\x17\x26\x84\x61\x52\x71\x95\x85\xd3\xe9\x8b\x7b\x1b\x00\
\x22\x14\x9f\xc3\xe1\xf3\x89\xfb\xd5\xd0\xc0\x95\xac\x5d\x89\xf2\
\x0e\xd8\x14\x0f\x29\x73\x1d\xac\xc5\x48\xba\xcb\x67\x82\x62\x94\
\x01\x75\xcd\xb0\x7d\x70\x11\x80\x03\xc3\x58\x3c\x6f\xdc\x7d\x56\
\x14\x83\x98\x65\x97\x7d\xf1\x00\xd0\x02\x12\x2c\xa9\xbd\xe2\x90\
\x05\x7c\x88\xeb\x6c\xd2\x01\xbb\x41\x98\xa7\x4e\x23\x71\x07\x21\
\x3b\x1d\x30\xeb\x7c\x4b\xe7\x9c\x79\x13\xd2\xac\xce\x59\xb9\x5c\
\xe8\x3b\x28\x18\xac\x03\x2b\xe8\x51\xb2\x3a\x40\x7d\xde\xc0\x22\
\x5e\xea\x62\xa7\xf1\x12\xe4\x39\x77\x3b\xee\x35\xe3\x5c\x46\x8c\
\xe5\x5d\x6d\x2d\x75\xd3\xbe\xb3\xfc\xd7\x17\x86\x10\x0e\x6f\x59\
\x29\x49\xa4\x0e\x84\x61\xb7\x6e\x8a\x53\xee\x52\x36\x1b\xaf\xa4\
\x8d\xe7\xbd\x9d\xc1\x01\x41\x6a\x66\xf5\x0a\xd9\x53\x26\x51\xcf\
\x71\x50\xf1\x94\xaa\x8c\x1b\xc4\x4c\x22\x13\x6f\xbe\x72\xaf\x8e\
\xff\x37\x6a\x12\x75\xe9\x51\x64\xa8\x4e\x05\x96\x8a\x46\x68\x45\
\x6c\xe1\x56\xd6\x6a\x8b\x98\xb2\x47\xf1\xa0\x88\x6b\x51\xdf\x19\
\x10\x86\x25\x44\x6c\x2f\x1c\xfa\x9c\x3a\xb0\xad\x89\xca\x83\x77\
\x03\xe2\x83\x95\x06\x84\xb5\x71\x96\x9d\xb6\xd4\x2b\xf7\xc8\x12\
\x39\x90\x17\x03\x3a\xca\xea\x41\xa4\xc0\x14\xd4\x5c\x91\x02\x97\
\x65\xab\xa7\x1e\x54\x49\x53\xeb\xea\xeb\x69\x1d\x0d\xb8\x4b\x78\
\x13\x9c\x95\x6b\xa8\x28\x28\x9d\x12\xa2\x0e\x10\x5c\x2a\xe8\xfc\
\xf6\xe0\xd0\xdc\x51\xdb\x78\x68\x5b\xaa\x0b\x14\x45\x66\xa9\x53\
\x23\x56\xed\x27\x56\x35\x83\xf4\x2a\x21\x7f\xb2\x36\x34\x75\x14\
\xb8\x4a\x50\x83\x5b\xe8\xda\x13\x10\xb8\x10\x98\x8d\x96\x4d\x6a\
\x41\xd3\x39\x04\x82\x17\x6b\xbe\x74\xdc\x83\x41\x7c\x22\x87\x40\
\x9a\xb2\x68\xe1\xec\xc8\xaf\xec\xf8\xc0\x28\x6a\x5e\xd8\x05\xdf\
\x88\x0c\x7f\x26\x30\x07\x19\xdd\xc2\xea\xb2\x20\x4b\x6a\x35\xab\
\xf3\xe0\x1d\xad\x1c\x1f\x9e\x6a\x6a\x45\x67\x32\x63\x68\x2f\xf2\
\x5c\x57\xbf\x9a\xb9\xa3\xce\xe1\x94\x7a\xc8\x72\x22\xcc\x0d\x71\
\x91\x35\x04\x2a\x5b\x0d\x21\x7c\x52\x07\x9a\xea\x4a\xd4\xc9\xa7\
\x24\xf2\x08\xdc\x42\xe7\x3b\x59\x87\x24\xdd\xa9\x3d\xc5\x74\xea\
\x04\x29\x7b\xed\xdf\x25\xfc\x04\x21\x21\xa8\x38\x45\x02\x72\xba\
\x0e\x10\x46\xc7\x07\x55\xc1\xf4\x65\xf0\x5e\xce\xfd\xb6\xbb\x17\
\xa8\xfe\x7a\x50\xf4\xf8\x62\xd1\xb6\x1a\x96\x07\xcd\x6a\xc1\xaf\
\x8c\xc3\x22\xe7\x65\x97\x29\xde\xad\x43\x46\x0c\x3e\x28\x80\xab\
\x02\x45\xd3\x3b\x51\x9c\x5b\xc7\x23\x64\xb5\xf4\x1a\xa6\x2a\x4c\
\xa7\x6a\x47\xa4\x60\xc3\x51\x9b\x9d\xac\x91\x2b\xd5\xce\x28\x0a\
\x0b\x87\x02\x7c\x40\x0a\x4d\x7d\x67\xe0\x4b\x92\x07\x35\x56\xa3\
\xa8\x39\x12\x13\xda\x8a\x1a\x9b\xd4\x35\xe3\x18\xcf\x7e\x02\x5d\
\xed\xfa\x60\x6e\x12\xdd\x92\xe8\x63\x49\xde\x15\xa2\x4d\xa6\x00\
\xc0\x81\x6b\x80\xe7\x92\x47\xea\x93\x30\x92\x84\x58\x26\xb4\x31\
\x51\x83\x23\x9c\x81\x1e\xc8\x04\xea\x15\x43\x1b\x25\x6b\xa1\x9f\
\x86\x4d\xbc\x0d\x1a\xa4\xa2\x08\x7c\x16\xc6\x66\xc0\xe1\xab\xb9\
\x8e\xc2\xdc\x3a\x88\x19\xf2\xe1\x70\xe9\x39\xf8\x14\xc7\x87\x70\
\x62\x60\x22\x61\xd3\xa6\x41\xd5\x99\x5c\xc6\x30\x49\x1b\x52\x64\
\x57\x7b\x78\x4c\x2f\x51\x7c\x38\xc6\x74\x64\xbb\x31\x48\x5c\x0b\
\x40\x8d\xa4\xec\xc2\x30\xfb\xea\xa8\xb7\xae\xcd\x78\x1f\x50\xd2\
\x59\x0f\x06\x06\xdc\xcb\x3b\x34\x24\x81\x08\x66\xd7\x86\xb1\xad\
\xa0\xce\xa5\xda\x20\x8d\xec\xb5\xd3\x5a\x5f\x0b\x12\x19\x06\x90\
\x2e\xf2\xd9\x1d\x56\x9d\x14\x3b\x18\xc5\xc6\xbd\xf5\x28\xcb\xdc\
\x97\xf4\xe4\xa2\xa1\xe9\x5c\xb6\x4e\x35\x70\xc0\xe4\x6a\xae\x18\
\x7a\x58\xa8\x6d\xe0\x8c\x74\x2a\xc0\x5d\xa5\x00\xa8\x49\x73\x67\
\x88\x1c\xd3\x55\xfb\x01\xd9\xd1\x59\x4b\x60\xb5\xe8\xfc\xa3\x4e\
\xb4\xac\x49\x54\xea\xa4\x8c\x77\x8f\x1e\xe8\x43\x5e\xa3\x10\x80\
\x77\x16\x1b\xcf\x00\xc9\xaa\xb5\x6c\xba\xf1\xf8\x15\x2f\xbc\x8f\
\xa2\x2a\xe1\x03\x3c\x01\x58\xda\x94\xa3\xe6\x61\x78\x00\xf7\x42\
\x2e\x41\x0f\xae\x32\xc7\xb0\x45\xf0\x10\x69\xd3\x53\x04\xaa\x52\
\x1d\x38\xcb\x41\x52\x35\x4b\xe4\xee\x9f\x39\xaa\x03\xaf\x93\x99\
\x65\x36\x03\xcf\x8e\xf6\x00\xa6\x04\x8b\x3a\xd7\xd1\x15\xaf\xe5\
\xcf\xab\xcb\x01\xa8\xa0\xde\xa8\xbe\x01\xd0\xbb\xae\xe3\xbc\xdb\
\x85\x42\x70\xba\x9a\x2f\xd6\x5c\xa4\x38\xb9\xa4\xc7\xf9\x2c\xab\
\xef\x93\xec\x07\x84\xfd\x6b\x68\xc3\x9f\x33\x63\x38\x5f\x78\x70\
\x23\x25\x22\x85\xaa\x66\xaf\x20\xf8\xbc\xc0\x12\x94\x3d\x59\x77\
\x23\xf7\xf5\x18\x15\x2b\xaf\x73\xe7\x45\x75\xe2\x20\x0e\xe2\x44\
\x9b\x8a\xbd\x8c\xa3\xc3\xd0\x94\x80\xfe\xa5\xcd\x72\x60\x13\x45\
\x23\x9d\x0d\xdc\x14\xd2\x6a\xc1\x97\x70\x49\xba\x6a\xb8\x67\x0e\
\x80\xe4\x96\xda\x45\x64\x70\x77\xd4\x35\xb9\x89\x1a\xbb\xd2\x34\
\xdc\x57\xf6\x15\x1b\x23\xc3\x30\x80\x7f\x77\x8b\x14\x5a\xd4\x5e\
\x9e\xfa\x24\xb5\x99\x81\x73\x85\x00\x0e\x55\x0c\x6c\x29\x7f\x21\
\xb1\xa9\x4d\x40\xaf\x07\x4e\xbd\x4a\x13\x5b\x80\x6d\x28\x53\xf9\
\x89\xfe\x43\x88\x39\x04\x5b\xec\x88\x39\xc0\x93\xe2\x40\x6a\xe0\
\xfa\x33\x77\xce\x64\x07\x9f\x66\x3a\x6f\xcf\xcd\x52\x90\x1c\xef\
\x48\x2f\x64\xb7\x41\xb9\x55\xdd\x72\x7a\x6a\xf2\x22\xf1\xa7\x67\
\x6a\x5c\x93\xa1\xb1\x8a\x75\x1b\x8b\xdc\xf0\xd7\x98\x68\x1d\xda\
\x60\x98\x74\xf4\x5a\xa6\x8e\xa3\x3d\x29\x8e\x1a\xd2\xd6\x54\x2f\
\xda\xd7\x88\x51\x3b\xc2\x53\x9b\xa8\xd0\xbf\xfa\xb3\x89\x9d\x0e\
\xfb\x80\x89\x81\x1b\x01\x0a\x9b\x7a\x53\xa9\x4d\x4a\x1f\xf4\x93\
\x3e\x41\x84\xe1\x2b\x10\x35\x7a\xd2\x04\x24\x9a\x65\x63\xc9\x99\
\x05\x2e\xa9\xa9\x59\x46\xe7\xfd\xb8\x5b\x09\x02\xe9\x4d\xca\x0c\
\x86\x04\x26\x15\x88\xcd\xb2\x57\x0d\x35\xcf\xaf\x6e\x94\x04\xb4\
\xa8\x83\x43\x27\xec\xd0\x33\xe4\x37\x01\xd0\x26\xed\xad\xde\x1a\
\x02\x96\xc9\x32\xfc\x9f\x20\x16\x6a\x51\x23\x23\xc6\xe2\x56\x1d\
\x3b\xbc\x32\x84\x88\xe4\x7a\xd5\xde\x71\x54\x14\x2f\x75\x13\x8e\
\x9a\x29\xf8\x94\x83\x47\xcf\x3b\x3e\xac\x8d\xbe\xe0\x49\x8d\x8a\
\xe6\xec\xb8\xa2\x4e\xf9\x0d\x35\x87\x21\x99\x32\xa0\xb2\x97\xba\
\x52\xe1\x6a\x4c\x66\x95\x62\x42\xc8\x61\xd3\xb5\xbb\x56\x97\x46\
\x7d\x24\x22\xb0\x8b\x5e\xbb\x9a\xea\xfe\x20\x21\x83\xfc\x97\x37\
\x66\x2a\x23\xfb\x9a\xa7\xd4\x6e\xcb\x04\x58\xc7\xfc\x8e\xf1\x20\
\x4e\x1d\x08\x4f\x9d\xa0\x27\x6a\x54\x0f\xd8\x0c\xa6\x16\x55\xac\
\x64\xe1\x44\xc5\x61\xd0\xf1\xcc\xf0\x47\xd3\xf9\x89\x64\x0d\x82\
\x49\xd2\x0a\xed\x4d\x44\xe0\x99\x2d\x2a\x55\xd7\xb2\xba\x79\xaa\
\x71\x0d\xfe\x01\xd0\x9c\x8c\x14\x29\xd3\x5a\x54\x73\x3f\xee\x14\
\x01\x44\x92\x7b\xb5\x75\x72\x5d\xb5\xed\x18\x81\x07\xb1\xb7\x80\
\x85\x42\xc6\xe7\x02\x55\x37\xa1\xc2\x4f\x46\x78\x00\xd5\xd4\xb8\
\x43\x8d\x13\x94\x0e\xee\x6e\x34\x21\xd6\x6b\xa1\x28\xa1\xbe\x84\
\x40\xd7\xae\xab\x1e\xe0\xcb\xda\xe8\x47\xae\x48\x87\xe0\x42\x75\
\x34\x98\xca\xe4\x5b\x4b\x92\xbb\x50\xaa\xa5\x39\x74\x6c\xd1\x36\
\xe0\x1a\xa8\x7d\x3d\xd1\x17\x2a\xd8\xf1\xde\xa4\x30\x12\xbe\x67\
\xe9\x21\x98\xae\x53\x11\xd2\x6f\xe0\x45\x36\x2e\x5d\x26\x5c\xdc\
\xd8\x41\xdb\x0d\x37\x74\x47\x75\x48\x1c\x0c\x6d\x8b\x69\xdb\x0c\
\x21\x04\xaa\x8c\x4c\xfd\x02\xf9\x4b\x5b\x78\x70\x75\x53\xd3\x10\
\x26\xf7\x9d\x03\xe3\x2a\xb0\x16\xed\x90\xe4\xe8\x84\xa3\x66\x2a\
\x5b\x2e\x5e\x90\x52\x8a\x04\x60\x86\x1c\x7d\x00\xa1\x59\x16\xd6\
\xa2\x5f\x70\x92\x58\x50\x30\x88\x3d\xa9\x63\xa1\x98\x67\x31\x02\
\xf5\x9c\x41\x18\x52\x79\xbd\xac\xa3\xb0\x1d\xdc\x31\x78\x11\xd3\
\xa1\x7f\xa9\xe8\x03\xfb\x2f\x79\xa6\xb2\xb5\xa7\x1a\xa3\xce\x19\
\xb9\xd7\xd1\x2e\x58\xd5\x59\x7c\xdb\x57\xeb\xce\xcd\xef\x21\x0b\
\x4c\x2d\x44\xd5\x65\x84\x1a\xb0\xaa\x63\xec\x77\xa0\x1f\x65\xf9\
\x50\xcb\x80\xe9\xc2\xcc\x60\xeb\x96\x2c\x5a\x1d\x51\x3b\xbd\x93\
\x0b\xc9\xec\x98\x1e\x2a\xc8\x3a\x32\x14\x3a\x09\x73\xdd\x1c\x88\
\xa2\xb9\xe2\x21\xda\x87\x05\x6b\xaa\xe2\xeb\x8b\x56\x96\x2c\x98\
\xa2\x71\x78\x41\xfd\x4e\x2d\x1f\x3d\xfa\xa1\x23\x11\x8a\x4b\x12\
\xd6\x93\x30\x2c\x3e\xc9\xdb\x9d\xb6\xe1\xbe\x8e\xe1\xd0\x96\x3a\
\x51\x18\x58\x3e\xb2\x33\xa9\xc5\x93\xb5\xa2\x12\x76\x99\x15\x1b\
\xbb\xb5\xa1\xa2\x5d\xbf\x99\x76\xae\x8a\x10\x82\x7a\x0c\x9d\x61\
\xaa\xab\x9e\x8c\x58\x8c\x08\x7f\x71\x04\x3a\x44\x5c\x9b\x6f\x10\
\xb4\x0e\x8e\x3a\xb2\x06\x31\xa0\x5d\xa5\xa2\x9e\x66\xb2\x19\x69\
\x18\xf0\xac\xda\xbf\x7a\x6d\xff\xbd\x95\x77\x76\xeb\x96\x44\x09\
\x5e\x14\x3a\x42\xbb\x6a\xbc\x6d\x92\xc1\x7d\xa8\x3c\xd4\xee\x8f\
\x11\xb0\x23\xdb\x7e\x60\x85\x1c\x75\x8e\xa2\x63\xdd\x6b\x1d\xc8\
\x33\x35\xdc\xc1\x13\x73\x68\x6f\x84\x89\x67\xb5\xb5\x9d\x25\xf9\
\x0b\x0b\x74\xb8\xbd\x73\x09\x2a\x4b\x07\x0b\x89\x17\xbd\x9e\xd0\
\x00\x0a\x62\x53\x3b\x00\x75\xa0\xcc\x5a\xe3\xab\x23\xb2\x22\xc4\
\x9d\xce\x95\xa9\x7e\x9d\xf5\x54\x38\xe0\xa8\x03\x34\x30\x13\x19\
\xb7\xfd\x76\x5d\xa6\x0e\xca\x61\x07\xb5\x59\x9a\x3a\x47\x90\xb9\
\x90\x9b\xe7\x82\xc0\x02\x1a\x44\xcd\x61\xc7\x5d\x26\x5d\xd5\x82\
\xa6\x83\x07\x16\x2a\x4e\xfe\x24\x50\x2f\xcc\xa6\x6e\x05\x56\x6d\
\xe8\x84\x10\x42\xba\x2f\x36\xda\xb2\xf4\x45\x0f\xdd\x10\x07\xb5\
\x92\x2e\x35\xe8\x92\x5c\x00\x1c\x99\x56\xd4\x2a\x45\xee\x4e\x59\
\xe1\x9a\xb5\x26\x98\x8b\xa3\xa3\x84\x6a\x8c\x44\x17\x3e\xda\x0d\
\x26\x4b\x47\x40\x99\x40\x2a\xb0\xd3\x2c\xe8\x42\x2f\x73\x5c\xd5\
\x0f\xb5\xb5\x7d\x9c\xf4\x30\x6f\x38\xc0\xc9\xd6\xdc\x89\xf2\x09\
\x71\x1e\x64\x03\x98\xd5\x10\x99\x51\x88\x20\xb5\x76\x88\x58\x78\
\xed\x90\x87\x8a\x47\x11\x53\x6b\x53\x3b\x24\xd2\xe9\x02\xb4\xab\
\x87\xa3\xf9\x7f\xf2\x50\xcf\xf5\xa6\xd7\xef\xbc\xb4\xd7\x08\x87\
\xa0\x25\xf5\x17\x1e\x2c\x52\xf5\x3d\xc5\x01\x12\x1e\x99\x3c\xdc\
\x0e\x92\xc5\xad\xde\x30\x5e\x10\xd5\x45\xf7\xdc\x25\x3e\x12\xa5\
\x54\xa1\x04\x41\x18\x68\xae\xbc\xda\x15\x31\x61\x69\x83\xda\xeb\
\xb5\xad\xde\x42\xd0\x73\x00\x78\xd2\xac\xdc\xe8\x0b\x2f\xd2\xec\
\xbe\x3d\x93\xa1\xc7\x9c\x56\x55\xc3\xf7\xd1\xb3\x23\x46\x15\x8f\
\xd7\x67\xb7\xe0\x5b\xd3\xbe\xaf\x57\xf7\xa3\x28\x1b\xb1\x31\x65\
\x26\xb4\xeb\x9e\x74\x08\x2f\xca\x7e\x8f\xd0\x20\x61\x83\xda\x3f\
\x82\xa9\x59\x2a\x74\xa8\x32\x54\x89\x3b\xd8\x18\xa8\x5e\xda\x83\
\x92\xe8\x50\x1b\xd5\xc1\x8b\x80\xe0\x08\x8f\xac\x26\xab\x35\x75\
\x32\xe5\x00\xd8\xb7\x59\x03\x76\x52\xee\x19\xcd\x0c\x4e\xa1\x87\
\x78\x65\xc7\x8b\x4b\xc5\x8e\xf4\xab\xbf\x33\x61\x68\x2f\x83\xe5\
\x32\x3c\x10\x1a\xf2\xe8\x19\x48\xef\x97\xba\xbe\xf2\x6d\xae\x62\
\xd2\x0a\xd2\x9b\xb5\xf0\x54\xcd\xd5\xf3\x3c\x90\xbd\x34\x14\xda\
\x83\xd2\x21\xe4\x6f\xf3\x48\xe9\x0e\xcf\x75\x1d\x9f\xaa\x61\x0b\
\x16\xd2\x03\x23\x59\xcf\x8b\x32\x40\x54\xed\x22\x7f\x2a\xb2\xb0\
\x37\xf5\x82\xcf\x77\x6e\xbf\x74\x56\x6f\x7a\x78\x4d\xb2\x46\x0f\
\xbb\xbd\x36\x6b\xae\x9f\x25\x83\x11\xef\xf2\xcc\xf2\x26\xda\x50\
\x1a\xcc\x56\x6d\x43\x46\x59\xa4\xec\xd5\x4c\x12\x7a\x95\xd9\xda\
\x52\x2b\x19\x0c\xbe\x2d\x6b\x93\x5f\x65\x7f\xeb\xd4\xb3\x19\xa7\
\x6f\xbd\xb5\x25\x26\x51\x2e\x43\x1d\x51\xa5\xed\xe1\xb6\xac\xb4\
\xe9\x61\x1c\x26\xc0\x92\xa8\x99\x0f\xd1\x25\x42\xd2\x43\x66\x1d\
\x80\xef\xb8\x8b\xa6\x06\x7d\x3d\x3b\x87\x70\x65\x05\xa0\x37\xb2\
\xfc\xa8\x47\xc3\xa6\x76\x72\xa1\xa3\xae\x27\x48\xc0\x00\x2e\xf2\
\x96\xcc\x07\x94\x8d\x2e\x23\x0f\xa4\x2e\x73\x96\x9f\xf7\x8f\x5a\
\x2c\xa2\xf6\xb7\xc9\x25\x3d\x62\x80\xf1\xd9\x15\x2d\x43\x34\xf1\
\x28\x01\x2f\x72\x27\x66\x94\x74\x1c\x84\xd9\xe2\x8a\x7a\xb2\x74\
\x90\x56\xb9\xbf\x87\x7b\x75\x7a\xc9\xea\xe7\x30\xbc\x1e\xd1\xd3\
\xac\xbd\xe4\x96\xec\x9e\x3a\xb8\x70\xb4\xdd\x42\x71\x7e\x51\x99\
\x2c\x2c\x2e\x43\x87\xa5\xc1\xc7\xcb\x2a\xbd\xe7\x73\xf3\x10\xfc\
\xab\x83\x30\x0e\xa5\x3b\x5a\xab\xe0\x1b\x89\x8c\xb4\x95\x0c\x77\
\x05\xb3\x70\x2b\xda\x4b\x75\x35\xab\x2a\xf5\x74\x9c\xdd\x01\x10\
\x50\x38\xf7\x90\xc4\x49\xad\xf0\x4b\x80\x8c\x38\x15\xf2\x02\x05\
\xb8\xa6\xa2\x67\xff\x76\xd7\x33\x01\x51\x87\x35\xe0\xbc\xba\x11\
\x11\x11\x7a\xa2\x4f\x0e\x35\x14\xd6\x5b\x67\x83\x68\x4b\x66\x3b\
\xb4\x4f\xf1\xf2\x8b\x9b\xdf\x85\x16\xd4\x16\xf2\x0a\x09\x54\x0b\
\x42\x4f\x3d\xfb\xc1\x1f\x3a\x7f\x9c\xe0\x2a\xd5\x8f\x9a\x51\xdf\
\x1b\xe1\x81\x5a\x0b\xa9\x01\x0d\x78\x80\xf4\xc2\x7a\x47\x9d\x2d\
\x18\xf2\xa4\xbe\x09\x6c\xc7\x7d\x0f\x67\xbd\xbe\xff\x85\x64\x9f\
\x05\x9c\xd1\xf5\x19\xab\x53\x9a\x13\x52\x60\x52\xbb\x13\x45\x7d\
\xf8\x11\x2e\x7b\x3d\xf2\x65\x68\xf3\x69\xd4\xab\x56\x76\xd6\x89\
\x81\x4e\x94\x2e\x9a\x10\xff\xee\x75\x32\xe9\x89\xea\x6b\xbf\xc5\
\x8b\x20\x8d\xd4\xa2\x39\x96\xb6\xa0\x48\x5d\xf9\x3f\xed\xb1\x15\
\x11\x8b\x7a\x82\x99\xa4\xda\x20\x64\xfe\xa4\x30\xcf\xeb\x9e\x42\
\xcc\x3f\x36\xc4\x35\x62\x64\xf1\x08\x4e\x1b\x0e\x68\xbf\xe6\xc1\
\x89\x2b\xfb\x27\xf7\x98\x41\x37\x92\x6e\x93\x8c\x51\xa7\x76\x08\
\x8a\x9e\x8b\x9e\x11\xcb\x09\x88\x6a\xe4\xe1\xc1\xef\x41\xfc\xda\
\xaf\x02\x57\x02\x8a\x4d\xbb\x1d\xb8\xc0\x8d\xaa\xd4\x56\xb7\x85\
\xaa\x3d\x31\x4f\x9a\xe8\xc1\x07\x1d\x9d\x82\x5c\xcb\x03\x0e\x55\
\x1b\x76\xd7\x48\xc8\x6b\xda\xae\x09\xfa\xab\x67\xa2\xd4\x02\xe9\
\xe4\x90\x5f\x41\x8f\x54\xe0\x6a\xd4\x49\xe5\xab\x9e\x2a\x53\x03\
\x89\x66\xcf\xdc\x81\xda\x48\xf4\x41\xbe\xa6\x47\x95\x41\x2c\x68\
\xf0\xab\x09\x5d\xca\x5a\xd2\x9f\x99\x1f\x75\x69\xdc\x91\x1e\xfb\
\x93\xba\x64\x27\xd7\x51\x8b\x40\x08\x54\x0a\x80\xe2\x63\xd7\x59\
\x90\x8e\x52\x58\x0c\x7c\xb7\xe1\x0b\xf4\x8c\x25\x02\x43\x9d\x51\
\x17\xcc\x87\xb2\x32\x17\xea\xc6\x70\xb7\xfe\x4a\x08\x32\x42\xed\
\xf3\x4d\xdd\x34\x3a\xe1\xd1\xf3\x7e\x62\x4c\x7c\xf5\x86\x4b\xa1\
\x7a\x6e\xc0\x2a\xe8\xd9\x52\xb5\x11\x60\x4c\x56\xd7\x03\x44\xa4\
\xf4\x75\x10\xd5\x7a\xd6\x00\x20\x03\xa7\x28\xa6\x80\x4c\xb6\xa2\
\xb0\x85\xf1\xfe\x16\x25\x20\x2a\xab\x35\xb2\x23\x66\xb3\xce\x6b\
\x96\xe9\x24\x62\xe7\x31\x98\x35\x82\xe2\x00\xbf\x4e\x9d\xae\xea\
\x72\xc4\x38\x92\xd9\x27\xe7\xa8\x47\xe9\x74\x59\x0f\x72\xef\xf7\
\x54\x6c\x90\x93\x5a\xed\xd9\x54\x9d\x28\xa9\x1b\xf1\xa8\xff\xeb\
\xf2\x59\x54\x94\x31\x4f\xc7\xea\x96\x17\x3b\x45\xe9\xa0\xe5\x5f\
\x12\x68\x4f\x97\xb2\xb6\xac\xda\x52\x23\x48\x95\x5d\xd1\xa3\x20\
\x50\x32\xd9\x80\x79\xe7\x45\x9c\x9f\x8e\xf4\x12\x37\x0e\x10\xe4\
\x52\xbb\xcf\x11\x68\x83\x7e\xd2\x4d\x7a\xc2\x06\xb9\x0c\x6f\x41\
\x85\x9b\x32\xce\x12\xbe\xd4\x23\x04\x24\x91\xac\x76\xa2\xa5\x7d\
\x51\x04\x19\xc5\x20\x34\x51\xc7\xf8\xba\x3a\x57\x41\x68\x93\x93\
\x29\xa9\xd1\x77\x8e\xb2\x99\xd4\x6a\xda\xb3\x5c\x23\x66\x9d\x0a\
\x45\x89\x75\xa4\xe6\xdd\xa8\x11\x44\x46\xd3\xdf\xd9\x14\xbd\x4a\
\x0d\xd5\xab\xe3\x0c\xe2\xcb\x80\xb5\x3d\x53\xb5\xeb\x81\x14\x5a\
\xd0\xbb\x9e\x46\x20\x5d\x42\xd2\x13\x49\x0c\x05\xd5\xa7\xbf\x14\
\x40\xcf\xfa\x6a\xea\x68\x1a\x3c\x7f\x45\xad\xc0\x1c\x82\x27\xf4\
\x11\xd2\x1c\x51\xfa\x1e\x4f\x41\x3b\x24\x12\x1c\xc9\x40\x65\x60\
\xc5\x4c\x8e\x68\x6c\x46\xef\x75\xd8\x45\x4c\xf1\x46\x6a\x03\x38\
\x1b\x3d\x6e\x5d\x4a\x6c\xaa\xab\x79\xe2\x45\xbc\xfe\x2e\x2f\x53\
\xb3\xb7\x9a\x14\xb3\xda\xdc\x8b\x8e\xf8\x86\x00\x40\x07\x6a\x47\
\x47\x3b\x60\xb6\x0e\xaf\x06\xa0\x99\x45\xc7\xa8\x33\x6c\xd1\xd2\
\x36\x04\xfe\xeb\x49\xbf\xad\x66\x8a\x2a\xf3\xa7\x8e\x16\x80\xd4\
\xb0\x36\xe4\x1b\xea\x44\x2d\x07\x28\x5a\x3c\xea\x6b\xdd\xf0\xef\
\x81\x0a\xfd\x35\x08\x98\xa4\xfc\x1a\xd6\xfd\x7b\x0e\x0c\xe9\x9c\
\x97\x0b\x6a\x2d\x3b\x57\x7b\x0b\x55\x0f\xed\x25\x11\x53\xd7\x73\
\x5b\x28\x1b\x0f\xc6\x4e\x75\xb6\x36\x3d\x97\x41\xc0\xd4\xa7\x08\
\x54\xe8\xc9\xaa\xa8\x67\xb7\x8a\x1e\x0d\xeb\x20\xc2\x7a\x7f\x95\
\x0a\x76\x9f\xa9\x17\x96\xb9\x32\x38\xf5\x0d\xaa\x7f\x5a\xd0\x63\
\xd7\xc7\xc1\x82\x4d\xcf\xca\x40\x0c\x4b\xfa\xdb\xb4\xdb\x8c\x34\
\xb9\xd4\x28\x96\x60\xe2\x50\x93\xb9\xad\x73\x21\x95\x96\xb4\x8c\
\x76\x3e\xc8\x5a\x19\x68\xf2\x36\xd8\xd0\xf9\x5d\x45\xab\xb5\x49\
\x1c\xc9\x06\x00\xa8\xeb\xe4\x0d\x94\xdc\xea\xf5\xd7\x99\x5e\x28\
\xba\xbb\x53\xc3\x8c\xda\x11\x70\xe7\x40\x97\x9e\x41\x00\x1e\x66\
\xd0\xc9\xaa\x7a\x57\xd5\x23\xc8\x95\xe1\x72\x96\x97\xd2\x3b\x7a\
\x50\x16\xb4\x52\x93\xdd\x56\xa2\x93\xb4\xda\xd7\x27\xb3\xd1\x85\
\xea\x04\x86\x60\x96\x9e\xc7\x27\x95\x0e\x73\x54\x7a\xe9\x48\x59\
\x84\xa4\x9d\x5b\x26\xab\xbf\x66\x08\x68\x4d\x47\x3d\x56\xa4\x30\
\xb8\xa1\xeb\x55\x35\xd7\x8e\xe0\xaa\x9e\x94\x5b\x0d\x20\x62\xea\
\x3a\xa0\x94\xcf\x56\x7f\x4c\xd7\x2e\xd0\x35\x1d\x19\x93\x34\x22\
\xc8\xdf\x46\xc3\x25\x33\x25\x3f\x90\xa7\x15\x0a\xd2\xe9\x3a\x9a\
\x02\xa1\x6a\x7a\xc0\x34\xe0\x13\x92\x06\x83\x39\xc1\xe9\x9c\xa1\
\x93\xa2\xee\x9f\xcf\x51\xcf\x89\xfe\x9e\x00\x1d\x69\xaf\xef\x28\
\x34\x4f\x95\x7e\x6d\x08\x4f\xa7\xc7\xa4\x9f\xe0\xfd\x9a\x0e\xb2\
\xa4\xbc\xfe\xaf\x28\xb7\xaf\x5e\xb7\xa4\x2d\x94\xdb\x18\xd3\xfb\
\xbe\x69\xdb\x14\x20\x43\x1a\xaa\xf9\x5d\x5d\xa9\xd8\xb6\x5d\xdd\
\x55\x57\xa0\x1a\xf5\x19\xb1\xd7\xba\x14\x3d\x21\xbc\xde\xe8\xd1\
\x01\x59\xcf\xa9\xa8\xf9\x4e\x07\x96\x2d\x00\xc2\xa0\x27\x9f\xfd\
\x3a\x06\xd2\x5f\x36\x35\xd5\xcc\xab\x11\x61\xc6\x65\xcb\x25\x4a\
\xd4\x6d\xa1\x7e\x33\x5d\xb4\xf2\xc1\x71\x50\xf7\x7a\xb4\x12\x27\
\x5e\x90\x05\x38\xb9\x96\x95\x73\x04\x2e\xa8\x6d\x38\x4a\x8f\x69\
\x1b\x76\x02\xb5\xd2\x77\x54\xaa\x1e\x26\x7f\x3d\xc5\x03\xf8\xa6\
\x6a\xc1\x8b\xee\xfe\x1f\xe8\xa4\x74\xeb\xa4\xff\x05\x0c\x00\x00\
\x0a\x1e\x69\x43\x43\x50\x49\x43\x43\x20\x70\x72\x6f\x66\x69\x6c\
\x65\x00\x00\x78\x9c\xb5\x56\x79\x3c\x94\x6b\x1b\x7e\xde\xf7\x9d\
\x7d\xb1\xcd\x90\xdd\xd8\xb7\x46\x96\x30\xc8\xbe\x93\xc8\x4e\x9b\
\x31\x33\x18\xcb\x60\xcc\xa0\xd2\x26\xa9\x70\x22\x49\xb6\x12\x39\
\x15\x3a\x74\x5a\x90\xd3\x22\x2d\xda\x8e\xd2\xa6\xa2\xce\xc8\x11\
\xaa\xd3\xd1\x22\x95\xca\xf7\x0e\x7f\xe8\xfb\x7d\xe7\xcf\xf3\x5d\
\xbf\xdf\xf3\xbc\xd7\x7b\xfd\xee\xfb\x7e\xee\xe7\x7e\xff\x78\x2f\
\x00\xc8\x63\x00\x05\x8c\xae\x14\x81\x48\x18\xec\xed\xc6\x88\x8c\
\x8a\x66\xe0\x1f\x03\x04\xa8\x01\x45\xa0\x07\xb4\xd8\x9c\x8c\x34\
\xf0\xbf\x80\xe6\xe9\xc7\x87\x73\x6f\xf7\x98\xd2\xdd\xf8\x93\xe3\
\xb3\xd6\x77\x61\x2d\xd9\x6e\x5f\xfe\xbc\xb1\xd5\x8e\xfa\x0f\xb9\
\x3f\x42\x8e\xcb\xcb\xe0\xa0\xe5\x3c\x50\xbe\x36\x16\x3d\x1c\xe5\
\x5d\x28\xa7\xc7\x86\x06\xbb\xa3\xfc\x3e\x00\x04\x0a\x37\x85\xcb\
\x05\x80\x28\x41\xf5\x1d\xf1\xb3\x31\xa4\x04\x69\x4c\xfc\x0f\x31\
\xc9\xe2\x14\x3e\xaa\xe7\x48\xf5\x14\x1e\x3b\x03\xe5\x25\x28\xd7\
\x8b\x4d\x4a\x13\xa1\xfc\x94\x54\x17\xce\xe5\x5e\x9b\xe5\x3f\xe4\
\x8a\x78\x1c\xb4\x1e\x69\x10\xd5\x29\x99\x62\x1e\x7a\x16\x49\x3a\
\x97\xed\x59\x22\x69\x2e\x59\x7a\x7f\x3a\x27\x4d\x28\xe5\x79\x28\
\xb7\xe5\x24\xb0\xd1\x18\xf2\x59\x94\x2f\x9c\xeb\x7f\x16\x5a\x19\
\xd2\x01\xfa\x7a\xba\xdb\x58\xd8\xd9\xd8\x30\x2d\x99\x16\x8c\xd8\
\x64\x36\x27\x89\x91\xc1\x61\x27\x4b\xab\xfe\xdb\x90\x7e\xab\x39\
\xa6\x77\x10\x00\x59\xb4\xb7\xb6\xdb\x1c\xb1\x30\x73\x4e\xc3\x48\
\x37\x2c\x20\x01\x59\x40\x07\x2a\x40\x13\xe8\x02\x23\xc0\x04\x96\
\xc0\x16\x38\x00\x17\xe0\x09\xfc\x40\x20\x08\x05\x51\x60\x35\xe0\
\x80\x04\x90\x02\x84\x20\x0b\xe4\x80\x2d\x20\x1f\x14\x82\x12\xb0\
\x17\x54\x81\x5a\xd0\x00\x1a\x41\x0b\x38\x01\xda\xc1\x59\x70\x11\
\x5c\x05\x37\xc1\x1d\xf0\x00\x0c\x00\x09\x18\x01\xaf\xc0\x04\xf8\
\x08\xa6\x21\x08\xc2\x43\x54\x88\x06\xa9\x40\x5a\x90\x3e\x64\x0a\
\x59\x42\x2c\xc8\x09\xf2\x84\x96\x42\xc1\x50\x14\x14\x03\xc5\x43\
\x02\x48\x0c\xe5\x40\x5b\xa1\x42\xa8\x14\xaa\x82\xea\xa0\x46\xe8\
\x57\xe8\x0c\x74\x11\xba\x0e\xf5\x41\x8f\xa1\x21\x68\x1c\x7a\x07\
\x7d\x81\x11\x98\x02\xd3\x61\x0d\xd8\x00\x5e\x04\xb3\x60\x57\xd8\
\x1f\x0e\x85\x57\xc1\xf1\x70\x3a\xbc\x0e\xce\x83\x77\xc1\x15\x70\
\x3d\x7c\x0c\x6e\x83\x2f\xc2\x37\xe1\x07\xb0\x04\x7e\x05\x4f\x22\
\x00\x21\x23\x4a\x88\x36\xc2\x44\x58\x88\x3b\x12\x88\x44\x23\x71\
\x88\x10\xd9\x88\x14\x20\xe5\x48\x3d\xd2\x82\x74\x22\x3d\xc8\x3d\
\x44\x82\xbc\x46\x3e\x63\x70\x18\x1a\x86\x81\x61\x62\x1c\x30\x3e\
\x98\x30\x0c\x07\x93\x8e\xd9\x88\x29\xc2\x54\x61\x8e\x62\xda\x30\
\x97\x31\xf7\x30\x43\x98\x09\xcc\x77\x2c\x15\xab\x8e\x35\xc5\xda\
\x63\x7d\xb1\x91\xd8\x78\x6c\x16\x36\x1f\x5b\x8e\x3d\x8c\x3d\x8d\
\xbd\x82\x7d\x80\x1d\xc1\x7e\xc4\xe1\x70\x4a\x38\x43\x9c\x2d\xce\
\x07\x17\x85\x4b\xc4\xad\xc7\x15\xe1\xf6\xe3\x5a\x71\x5d\xb8\x3e\
\xdc\x30\x6e\x12\x8f\xc7\xab\xe0\x4d\xf1\x8e\xf8\x40\x3c\x1b\x2f\
\xc2\xe7\xe3\x2b\xf1\xc7\xf0\x17\xf0\x77\xf1\x23\xf8\x4f\x04\x32\
\x41\x8b\x60\x49\xf0\x22\x44\x13\x04\x84\x5c\x42\x39\xa1\x89\x70\
\x9e\x70\x97\x30\x4a\x98\x26\xca\x11\xf5\x89\xf6\xc4\x40\x22\x97\
\xb8\x96\x58\x4c\x6c\x20\x76\x12\x6f\x13\x47\x88\xd3\x24\x79\x92\
\x21\xc9\x91\x14\x4a\x4a\x24\x6d\x21\x55\x90\x5a\x48\x57\x48\x83\
\xa4\xf7\x64\x32\x59\x87\x6c\x47\x5e\x4e\xe6\x93\x37\x93\x2b\xc8\
\xc7\xc9\xd7\xc8\x43\xe4\xcf\x14\x05\x8a\x09\xc5\x9d\xb2\x92\x22\
\xa6\xec\xa2\x1c\xa1\x74\x51\x1e\x53\xde\x53\xa9\x54\x03\xaa\x0b\
\x35\x9a\x2a\xa2\xee\xa2\x36\x52\x2f\x51\x9f\x51\x3f\xc9\xd0\x64\
\xcc\x64\x7c\x65\xb8\x32\x9b\x64\xaa\x65\xda\x64\xee\xca\xbc\x91\
\x25\xca\xea\xcb\xba\xca\xae\x96\x5d\x27\x5b\x2e\x7b\x52\xf6\xb6\
\xec\x6b\x39\xa2\x9c\x81\x9c\xbb\x1c\x5b\x6e\xa3\x5c\xb5\xdc\x19\
\xb9\x7e\xb9\x49\x79\x9a\xbc\x85\x7c\xa0\x7c\x8a\x7c\x91\x7c\x93\
\xfc\x75\xf9\x31\x05\xbc\x82\x81\x82\xa7\x02\x57\x21\x4f\xe1\x90\
\xc2\x25\x85\x61\x1a\x42\xd3\xa5\xb9\xd3\x38\xb4\xad\xb4\x06\xda\
\x15\xda\x08\x1d\x47\x37\xa4\xfb\xd2\x13\xe9\x85\xf4\x5f\xe8\xbd\
\xf4\x09\x45\x05\xc5\xc5\x8a\xe1\x8a\xd9\x8a\xd5\x8a\xe7\x14\x25\
\x4a\x88\x92\x81\x92\xaf\x52\xb2\x52\xb1\xd2\x09\xa5\x87\x4a\x5f\
\x16\x68\x2c\x70\x5d\xc0\x5b\xb0\x73\x41\xcb\x82\xbb\x0b\xa6\x94\
\xd5\x94\x5d\x94\x79\xca\x05\xca\xad\xca\x0f\x94\xbf\xa8\x30\x54\
\x3c\x55\x92\x54\x76\xab\xb4\xab\x3c\x55\xc5\xa8\x9a\xa8\x2e\x57\
\xcd\x52\x3d\xa0\x7a\x45\xf5\xb5\x1a\x5d\xcd\x41\x8d\xa3\x56\xa0\
\x76\x42\xed\x89\x3a\xac\x6e\xa2\x1e\xac\xbe\x5e\xfd\x90\xfa\x2d\
\xf5\x49\x0d\x4d\x0d\x6f\x8d\x34\x8d\x4a\x8d\x4b\x1a\xaf\x35\x95\
\x34\x5d\x34\x13\x35\xcb\x34\xcf\x6b\x8e\x6b\xd1\xb4\x9c\xb4\xf8\
\x5a\x65\x5a\x17\xb4\x5e\x32\x14\x19\xae\x8c\x64\x46\x05\xe3\x32\
\x63\x42\x5b\x5d\xdb\x47\x5b\xac\x5d\xa7\xdd\xab\x3d\xad\x63\xa8\
\x13\xa6\x93\xab\xd3\xaa\xf3\x54\x97\xa4\xcb\xd2\x8d\xd3\x2d\xd3\
\xed\xd6\x9d\xd0\xd3\xd2\x0b\xd0\xcb\xd1\x6b\xd6\x7b\xa2\x4f\xd4\
\x67\xe9\x27\xe8\xef\xd3\xef\xd1\x9f\x32\x30\x34\x88\x30\xd8\x6e\
\xd0\x6e\x30\x66\xa8\x6c\xe8\x6b\xb8\xce\xb0\xd9\x70\xd0\x88\x6a\
\xe4\x6c\x94\x6e\x54\x6f\x74\xdf\x18\x67\xcc\x32\x4e\x32\xde\x6f\
\x7c\xc7\x04\x36\xb1\x36\x49\x30\xa9\x36\xb9\x6d\x0a\x9b\xda\x98\
\xf2\x4d\xf7\x9b\xf6\x2d\xc4\x2e\xb4\x5b\x28\x58\x58\xbf\xb0\x9f\
\x49\x61\xba\x32\x33\x99\xcd\xcc\x21\x33\x25\xb3\xa5\x66\xb9\x66\
\xed\x66\x6f\x16\xe9\x2d\x8a\x5e\xb4\x7b\x51\xcf\xa2\xef\xe6\xd6\
\xe6\xc9\xe6\x0d\xe6\x03\x16\x0a\x16\x7e\x16\xb9\x16\x9d\x16\xef\
\x2c\x4d\x2c\x39\x96\xd5\x96\xf7\xad\xa8\x56\x5e\x56\x9b\xac\x3a\
\xac\xde\x2e\x36\x5d\xcc\x5b\x7c\x60\xf1\x23\x6b\x9a\x75\x80\xf5\
\x76\xeb\x6e\xeb\x6f\x36\xb6\x36\x42\x9b\x16\x9b\x71\x5b\x3d\xdb\
\x18\xdb\x1a\xdb\x7e\x16\x9d\x15\xc4\x2a\x62\x5d\xb3\xc3\xda\xb9\
\xd9\x6d\xb2\x3b\x6b\xf7\xd9\xde\xc6\x5e\x64\x7f\xc2\xfe\x6f\x07\
\xa6\x43\x92\x43\x93\xc3\xd8\x12\xc3\x25\xbc\x25\x0d\x4b\x86\x1d\
\x75\x1c\xd9\x8e\x75\x8e\x12\x27\x86\x53\x8c\xd3\x41\x27\x89\xb3\
\xb6\x33\xdb\xb9\xde\xf9\xb9\x8b\xae\x0b\xd7\xe5\xb0\xcb\xa8\xab\
\xb1\x6b\xa2\xeb\x31\xd7\x37\x6e\xe6\x6e\x42\xb7\xd3\x6e\x53\xee\
\xf6\xee\x1b\xdc\xbb\x3c\x10\x0f\x6f\x8f\x02\x8f\x5e\x4f\x05\xcf\
\x30\xcf\x2a\xcf\x67\x5e\x3a\x5e\xf1\x5e\xcd\x5e\x13\xde\xd6\xde\
\xeb\xbd\xbb\x7c\xb0\x3e\xfe\x3e\xbb\x7d\xfa\x7d\x35\x7c\x39\xbe\
\x8d\xbe\x13\x7e\xb6\x7e\x1b\xfc\x2e\xfb\x53\xfc\x43\xfc\xab\xfc\
\x9f\x2f\x35\x59\x2a\x5c\xda\x19\x00\x07\xf8\x05\xec\x09\x18\x5c\
\xa6\xbf\x4c\xb0\xac\x3d\x10\x04\xfa\x06\xee\x09\x7c\x1a\x64\x18\
\x94\x1e\xf4\xdb\x72\xdc\xf2\xa0\xe5\xd5\xcb\x5f\x04\x5b\x04\xe7\
\x04\xf7\x84\xd0\x42\xd6\x84\x34\x85\x7c\x0c\x75\x0b\x2d\x0e\x1d\
\x08\x33\x0a\x13\x87\x75\x87\xcb\x86\xaf\x0c\x6f\x0c\x9f\x8a\xf0\
\x88\x28\x8d\x90\x44\x2e\x8a\xdc\x10\x79\x33\x4a\x35\x8a\x1f\xd5\
\x11\x8d\x8f\x0e\x8f\x3e\x1c\x3d\xb9\xc2\x73\xc5\xde\x15\x23\x2b\
\xad\x57\xe6\xaf\x7c\xb8\xca\x70\x55\xf6\xaa\xeb\xab\x55\x57\x27\
\xaf\x3e\xb7\x46\x76\x0d\x7b\xcd\xc9\x18\x6c\x4c\x44\x4c\x53\xcc\
\x57\x76\x20\xbb\x9e\x3d\x19\xeb\x1b\x5b\x13\x3b\xc1\x71\xe7\xec\
\xe3\xbc\xe2\xba\x70\xcb\xb8\xe3\x3c\x47\x5e\x29\x6f\x34\xce\x31\
\xae\x34\x6e\x2c\xde\x31\x7e\x4f\xfc\x78\x82\x73\x42\x79\xc2\x6b\
\xbe\x3b\xbf\x8a\xff\x36\xd1\x27\xb1\x36\x71\x2a\x29\x30\xe9\x48\
\xd2\x4c\x72\x44\x72\x6b\x0a\x21\x25\x26\xe5\x8c\x40\x41\x90\x24\
\xb8\x9c\xaa\x99\x9a\x9d\xda\x97\x66\x9a\x96\x9f\x26\x49\xb7\x4f\
\xdf\x9b\x3e\x21\xf4\x17\x1e\xce\x80\x32\x56\x65\x74\x88\xe8\xe8\
\x0f\xe6\x96\xd8\x48\xbc\x4d\x3c\x94\xe9\x94\x59\x9d\xf9\x29\x2b\
\x3c\xeb\x64\xb6\x7c\xb6\x20\xfb\xd6\x5a\x93\xb5\x3b\xd7\x8e\xae\
\xf3\x5a\xf7\xf3\x7a\xcc\x7a\xce\xfa\xee\x1c\xed\x9c\x2d\x39\x43\
\x1b\x5c\x37\xd4\x6d\x84\x36\xc6\x6e\xec\xde\xa4\xbb\x29\x6f\xd3\
\xc8\x66\xef\xcd\x47\xb7\x90\xb6\x24\x6d\xf9\x3d\xd7\x3c\xb7\x34\
\xf7\xc3\xd6\x88\xad\x9d\x79\x1a\x79\x9b\xf3\x86\xb7\x79\x6f\x6b\
\xce\x97\xc9\x17\xe6\xf7\x6f\x77\xd8\x5e\xbb\x03\xb3\x83\xbf\xa3\
\x77\xa7\xd5\xce\xca\x9d\xdf\x0b\xb8\x05\x37\x0a\xcd\x0b\xcb\x0b\
\xbf\x16\x71\x8a\x6e\xfc\x64\xf1\x53\xc5\x4f\x33\xbb\xe2\x76\xf5\
\x16\xdb\x14\x1f\x28\xc1\x95\x08\x4a\x1e\xee\x76\xde\x7d\xb4\x54\
\xbe\x74\x5d\xe9\xf0\x9e\x80\x3d\x6d\x65\x8c\xb2\x82\xb2\x0f\x7b\
\xd7\xec\xbd\x5e\xbe\xb8\xbc\x76\x1f\x69\x9f\x78\x9f\xa4\x62\x69\
\x45\x47\xa5\x5e\x65\x49\xe5\xd7\xaa\x84\xaa\x07\xd5\x6e\xd5\xad\
\x35\xea\x35\x3b\x6b\xa6\xf6\x73\xf7\xdf\x3d\xe0\x72\xa0\xa5\x56\
\xa3\xb6\xb0\xf6\xcb\x41\xfe\xc1\x47\x75\xde\x75\x6d\xf5\x06\xf5\
\xe5\x87\x70\x87\x32\x0f\xbd\x68\x08\x6f\xe8\xf9\x99\xf5\x73\xe3\
\x61\xd5\xc3\x85\x87\xbf\x1d\x11\x1c\x91\x1c\x0d\x3e\x7a\xb9\xd1\
\xb6\xb1\xb1\x49\xbd\xa9\xb8\x19\x6e\x16\x37\x8f\x1f\x5b\x79\xec\
\xce\x2f\x1e\xbf\x74\xb4\x30\x5b\xea\x5a\x95\x5a\x0b\x8f\x83\xe3\
\xe2\xe3\x2f\x7f\x8d\xf9\xf5\xe1\x09\xff\x13\xdd\x27\x59\x27\x5b\
\x4e\xe9\x9f\xaa\x39\x4d\x3b\x5d\xd0\x06\xb5\xad\x6d\x9b\x68\x4f\
\x68\x97\x74\x44\x75\xf4\x9d\xf1\x3b\xd3\xdd\xe9\xd0\x79\xfa\x37\
\xb3\xdf\x8e\x9c\xd5\x3e\x5b\x7d\x4e\xf1\x5c\xf1\x79\xd2\xf9\xbc\
\xf3\x33\x17\xd6\x5d\x98\xec\x4a\xeb\x7a\x7d\x31\xfe\xe2\x70\xf7\
\x9a\xee\x81\x4b\x91\x97\xee\x5f\x5e\x7e\xb9\xf7\x8a\xff\x95\x6b\
\x57\xbd\xae\x5e\xea\x71\xed\xb9\x70\xcd\xf1\xda\xd9\xeb\xf6\xd7\
\xcf\xdc\x60\xdd\x68\xbf\x69\x73\xb3\xed\x96\xf5\xad\xd3\xbf\x5b\
\xff\x7e\xba\xd7\xa6\xb7\xed\xb6\xed\xed\x8e\x3b\x76\x77\x3a\xfb\
\x96\xf4\x9d\xbf\xeb\x7c\xf7\xe2\x3d\x8f\x7b\x57\xef\xfb\xde\xbf\
\xf9\x60\xd9\x83\xbe\x87\x61\x0f\x1f\xf5\xaf\xec\x97\x3c\xe2\x3e\
\x1a\x7b\x9c\xfc\xf8\xed\x93\xcc\x27\xd3\x03\x9b\x07\xb1\x83\x05\
\x4f\xe5\x9e\x96\x3f\x53\x7f\x56\xff\x87\xf1\x1f\xad\x12\x1b\xc9\
\xb9\x21\x8f\xa1\x5b\xcf\x43\x9e\x0f\x0c\x73\x86\x5f\xfd\x99\xf1\
\xe7\xd7\x91\xbc\x17\xd4\x17\xe5\xa3\x5a\xa3\x8d\x63\x96\x63\x67\
\xc7\xbd\xc6\xef\xbc\x5c\xf1\x72\xe4\x55\xda\xab\xe9\xd7\xf9\x7f\
\xc9\xff\x55\xf3\xc6\xe8\xcd\xa9\xbf\x5d\xfe\xbe\x35\x11\x39\x31\
\xf2\x56\xf8\x76\xe6\x5d\xd1\x7b\x95\xf7\x47\x3e\x2c\xfe\xd0\x3d\
\x19\x34\xf9\xec\x63\xca\xc7\xe9\xa9\x82\x4f\x2a\x9f\x8e\x7e\x66\
\x7d\xee\xf9\x12\xf1\x65\x74\x3a\xeb\x2b\xfe\x6b\xc5\x37\xe3\x6f\
\x9d\xdf\xfd\xbf\x0f\xce\xa4\xcc\xcc\xfc\xe0\x4d\xcc\x50\x5b\xc2\
\x98\xf7\x25\x1e\xbc\x38\xb6\x38\x59\xc4\x90\x1a\x16\xf7\xd4\xe4\
\x54\xb1\x90\x11\x92\xc6\xe6\xf0\x18\x4c\x86\xd4\xc4\xfc\xdf\x7c\
\x4a\x6c\x25\x00\xed\xdb\x00\x50\x7e\x32\xaf\xa1\x08\x9a\x7b\xcc\
\xf9\xb6\x59\x40\xe0\x9f\x01\xcf\xe7\x21\x4a\xe8\xb2\x42\xa5\x86\
\x79\x2d\xb5\x1e\x00\xd6\x24\xaa\x97\x64\xf0\xe3\x67\x35\xf7\xe0\
\x50\xc6\x0f\x73\x60\x06\xf3\xe2\x78\x42\x9e\x00\xbd\x6a\x38\x9f\
\x97\xc5\x17\xc4\xa3\xf7\x17\x70\xf9\x22\x7e\xaa\x80\xc1\x17\x30\
\xfe\x6b\x4c\xff\xca\xe5\x7f\xc0\x7c\x9f\xf3\x9e\x59\xc4\xcb\x16\
\xcd\xf6\x99\x9a\xb6\x56\xc8\x8f\x4f\x10\x31\x7c\x05\x22\x9e\x50\
\xc0\x96\x76\xc4\x4e\x9e\xfd\x3a\x42\x69\x8f\x19\xa9\x42\x11\x5f\
\x9c\xb2\x90\x61\x69\x6e\x6e\x07\x40\x46\x9c\x95\xe5\x6c\x29\x88\
\x82\x7a\x67\xec\x1f\x33\x33\xef\x0d\x00\xc0\x97\x01\xf0\xad\x78\
\x66\x66\xba\x6e\x66\xe6\x1b\x3a\x0b\x64\x00\x80\x2e\xf1\x7f\x00\
\x0a\x3f\xd9\xf6\x8c\xda\x63\x8d\x00\x00\x0d\x1a\x69\x54\x58\x74\
\x58\x4d\x4c\x3a\x63\x6f\x6d\x2e\x61\x64\x6f\x62\x65\x2e\x78\x6d\
\x70\x00\x00\x00\x00\x00\x3c\x3f\x78\x70\x61\x63\x6b\x65\x74\x20\
\x62\x65\x67\x69\x6e\x3d\x22\xef\xbb\xbf\x22\x20\x69\x64\x3d\x22\
\x57\x35\x4d\x30\x4d\x70\x43\x65\x68\x69\x48\x7a\x72\x65\x53\x7a\
\x4e\x54\x63\x7a\x6b\x63\x39\x64\x22\x3f\x3e\x0a\x3c\x78\x3a\x78\
\x6d\x70\x6d\x65\x74\x61\x20\x78\x6d\x6c\x6e\x73\x3a\x78\x3d\x22\
\x61\x64\x6f\x62\x65\x3a\x6e\x73\x3a\x6d\x65\x74\x61\x2f\x22\x20\
\x78\x3a\x78\x6d\x70\x74\x6b\x3d\x22\x58\x4d\x50\x20\x43\x6f\x72\
\x65\x20\x34\x2e\x34\x2e\x30\x2d\x45\x78\x69\x76\x32\x22\x3e\x0a\
\x20\x3c\x72\x64\x66\x3a\x52\x44\x46\x20\x78\x6d\x6c\x6e\x73\x3a\
\x72\x64\x66\x3d\x22\x68\x74\x74\x70\x3a\x2f\x2f\x77\x77\x77\x2e\
\x77\x33\x2e\x6f\x72\x67\x2f\x31\x39\x39\x39\x2f\x30\x32\x2f\x32\
\x32\x2d\x72\x64\x66\x2d\x73\x79\x6e\x74\x61\x78\x2d\x6e\x73\x23\
\x22\x3e\x0a\x20\x20\x3c\x72\x64\x66\x3a\x44\x65\x73\x63\x72\x69\
\x70\x74\x69\x6f\x6e\x20\x72\x64\x66\x3a\x61\x62\x6f\x75\x74\x3d\
\x22\x22\x0a\x20\x20\x20\x20\x78\x6d\x6c\x6e\x73\x3a\x78\x6d\x70\
\x4d\x4d\x3d\x22\x68\x74\x74\x70\x3a\x2f\x2f\x6e\x73\x2e\x61\x64\
\x6f\x62\x65\x2e\x63\x6f\x6d\x2f\x78\x61\x70\x2f\x31\x2e\x30\x2f\
\x6d\x6d\x2f\x22\x0a\x20\x20\x20\x20\x78\x6d\x6c\x6e\x73\x3a\x73\
\x74\x45\x76\x74\x3d\x22\x68\x74\x74\x70\x3a\x2f\x2f\x6e\x73\x2e\
\x61\x64\x6f\x62\x65\x2e\x63\x6f\x6d\x2f\x78\x61\x70\x2f\x31\x2e\
\x30\x2f\x73\x54\x79\x70\x65\x2f\x52\x65\x73\x6f\x75\x72\x63\x65\
\x45\x76\x65\x6e\x74\x23\x22\x0a\x20\x20\x20\x20\x78\x6d\x6c\x6e\
\x73\x3a\x64\x63\x3d\x22\x68\x74\x74\x70\x3a\x2f\x2f\x70\x75\x72\
\x6c\x2e\x6f\x72\x67\x2f\x64\x63\x2f\x65\x6c\x65\x6d\x65\x6e\x74\
\x73\x2f\x31\x2e\x31\x2f\x22\x0a\x20\x20\x20\x20\x78\x6d\x6c\x6e\
\x73\x3a\x47\x49\x4d\x50\x3d\x22\x68\x74\x74\x70\x3a\x2f\x2f\x77\
\x77\x77\x2e\x67\x69\x6d\x70\x2e\x6f\x72\x67\x2f\x78\x6d\x70\x2f\
\x22\x0a\x20\x20\x20\x20\x78\x6d\x6c\x6e\x73\x3a\x74\x69\x66\x66\
\x3d\x22\x68\x74\x74\x70\x3a\x2f\x2f\x6e\x73\x2e\x61\x64\x6f\x62\
\x65\x2e\x63\x6f\x6d\x2f\x74\x69\x66\x66\x2f\x31\x2e\x30\x2f\x22\
\x0a\x20\x20\x20\x20\x78\x6d\x6c\x6e\x73\x3a\x78\x6d\x70\x3d\x22\
\x68\x74\x74\x70\x3a\x2f\x2f\x6e\x73\x2e\x61\x64\x6f\x62\x65\x2e\
\x63\x6f\x6d\x2f\x78\x61\x70\x2f\x31\x2e\x30\x2f\x22\x0a\x20\x20\
\x20\x78\x6d\x70\x4d\x4d\x3a\x44\x6f\x63\x75\x6d\x65\x6e\x74\x49\
\x44\x3d\x22\x67\x69\x6d\x70\x3a\x64\x6f\x63\x69\x64\x3a\x67\x69\
\x6d\x70\x3a\x37\x31\x61\x61\x65\x35\x64\x37\x2d\x63\x38\x30\x37\
\x2d\x34\x37\x62\x36\x2d\x62\x62\x34\x32\x2d\x64\x34\x31\x66\x61\
\x61\x65\x39\x33\x37\x39\x39\x22\x0a\x20\x20\x20\x78\x6d\x70\x4d\
\x4d\x3a\x49\x6e\x73\x74\x61\x6e\x63\x65\x49\x44\x3d\x22\x78\x6d\
\x70\x2e\x69\x69\x64\x3a\x63\x35\x34\x66\x61\x39\x36\x33\x2d\x63\
\x36\x31\x34\x2d\x34\x39\x63\x30\x2d\x62\x65\x31\x34\x2d\x61\x32\
\x35\x36\x65\x39\x37\x33\x66\x33\x62\x63\x22\x0a\x20\x20\x20\x78\
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
\x20\x65\x6e\x64\x3d\x22\x77\x22\x3f\x3e\x0b\x9c\xf0\xbd\x00\x00\
\x00\x06\x62\x4b\x47\x44\x00\xff\x00\xff\x00\xff\xa0\xbd\xa7\x93\
\x00\x00\x00\x09\x70\x48\x59\x73\x00\x00\x2e\x23\x00\x00\x2e\x23\
\x01\x78\xa5\x3f\x76\x00\x00\x00\x07\x74\x49\x4d\x45\x07\xe6\x01\
\x10\x0f\x10\x16\xd4\xfa\xcc\x2d\x00\x00\x20\x00\x49\x44\x41\x54\
\x78\xda\x64\xbd\x47\xb0\x25\x59\x7a\xdf\xf7\x3b\x26\xcd\xb5\xef\
\x3e\xff\xca\x74\x99\xf6\x3d\x06\x33\x03\x0c\x24\x01\x20\x42\x62\
\x40\xa1\x90\x18\x0a\x52\x2b\x6d\xb5\xd5\x56\x0b\x29\x48\x88\x24\
\x46\x4b\x6a\xa7\x08\x6d\x28\x05\x65\x82\x84\x28\x13\x12\x29\x38\
\x21\x48\x4c\x90\x04\x30\xf0\x33\x18\xdf\xdd\xd3\x53\x6d\xca\xd7\
\xf3\xd7\x67\xe6\x71\x5a\x9c\x93\x79\xef\x6b\x54\xc4\x8b\xae\x7e\
\x75\x4d\xe6\x39\xe7\x73\xff\xff\xff\xfb\x52\x3c\x39\xab\x42\x53\
\x55\x3c\x7b\xfc\x88\xc5\x6a\x81\xf7\x1e\xef\x3d\x45\x51\x62\xad\
\x25\xcb\x32\xb4\xca\x08\x21\xe0\xbc\x47\x08\x81\x14\x82\x10\x02\
\x52\x4a\xbc\x0f\x78\x21\x90\x52\x02\x60\x8c\xc1\x9a\x06\x9d\x65\
\x08\x21\xd3\x6b\x3c\xae\x69\x08\xc1\xa3\x94\x42\x08\x81\x75\x8e\
\xc6\x9a\xee\x7d\x21\x04\x24\x82\x40\x40\x48\x89\xb7\x16\xa9\x33\
\x40\x60\x6d\x83\x52\xaa\x7b\x9d\x77\x1e\x25\x25\x3e\x78\x9c\x73\
\x64\x79\x01\x04\x82\xf7\xe0\x03\xde\x3b\xa4\x8c\xdf\xe3\xbd\xa3\
\x36\x35\x45\x56\xe2\x9c\x43\x69\x05\x21\x60\xac\x45\x48\x89\xb3\
\x8e\x5e\x59\x12\x82\x47\x08\x90\x52\x13\x42\x88\xdf\xe3\xe3\xe7\
\x6b\xad\x71\xce\x90\x65\x39\xd6\x5a\x94\xd2\x00\x38\xe7\x00\xb0\
\xd6\x76\xd7\x26\x84\x40\x29\xd5\xdd\xd7\xf6\x75\x3b\xe7\x40\x08\
\x08\x01\xa9\x24\x20\xf1\x21\xa0\xb5\xa2\xa9\x2b\xac\xb1\x14\x45\
\x81\xf7\x8e\x3c\x2f\x70\xce\x51\xd7\x35\x79\x9e\x23\x84\xc0\x59\
\x4b\x48\x9f\x69\xad\x45\x6b\x8d\xf7\xbe\x5b\x63\xa5\x14\xc6\x18\
\xf2\x3c\xc7\x7b\x87\x73\x1e\x1f\x1c\xb6\xa9\x91\x2a\x47\x67\xe9\
\x75\x42\x76\xfb\xd0\x34\x0d\x5a\x6f\xee\xa7\xbd\x87\x10\x42\xf7\
\x6f\x42\x88\x74\x16\x34\xde\x1a\x94\x52\x28\xa5\xf0\xde\x13\x42\
\xe8\xf6\x1d\x88\x6b\x1e\x02\xa6\x69\xc8\x8b\x1c\x6f\x2d\xd6\x3a\
\x20\x60\x8d\x41\xeb\xac\x5b\x5f\x21\x03\x79\x5e\x40\x88\x6b\xe6\
\x83\x47\xc9\xf8\xb9\x75\x5d\xa3\xb5\x26\x2b\x0a\xb2\x2c\xeb\xbe\
\x27\x84\x80\x4f\xef\x6f\x9a\x86\x7e\x7f\x18\xcf\x4b\x3a\x9b\x99\
\x8e\x9f\x13\xd7\x5f\x12\x42\xc0\x3a\x87\x10\x20\x84\x24\x00\x52\
\x69\x9c\x0f\x80\x40\x29\x89\xd6\xf1\xfc\x34\x4d\x8d\xb3\x16\x6b\
\x6b\x9c\x71\x18\x53\x21\x05\x80\x88\x8b\xe3\xac\x43\x4a\x49\x96\
\x65\x28\x29\xd1\x5a\xa3\x94\xea\x2e\x4e\x0a\x81\x92\xb2\x33\x8e\
\x10\x02\x28\x79\xe3\xe2\x85\x10\x20\x24\xde\xf9\x74\x40\x3d\xa2\
\xbb\x90\xb8\xd8\xed\x67\x65\x69\x31\xda\xdf\x09\x15\x6f\xc0\x1b\
\x8b\x31\x0d\x02\x90\xe9\x3a\xda\x0d\x14\x42\xc4\x83\xd3\x34\x20\
\x04\xf1\x9b\xc1\x59\x87\xb7\x0e\x6b\x0d\xeb\x6a\xb1\xf9\x4c\x21\
\xc9\xb3\x12\xef\x3d\x59\x96\x51\x37\x0d\x55\xd3\xa0\x94\xa6\xc8\
\x72\x94\x92\xf1\xde\x9d\xc7\x18\xd7\x6d\xb2\x94\x92\xa6\x69\xba\
\x7b\x70\xde\x13\x02\x48\xa9\xba\x6b\x91\x52\x22\x84\x40\x08\xd1\
\xad\x55\x7b\x70\xda\xeb\x74\xce\x75\x4e\x07\x40\x49\x99\xde\x17\
\xdd\x81\x14\x24\x67\x61\x11\x4a\x02\x01\x21\x64\xf7\xbe\xb2\x2c\
\xbb\x83\x6b\xac\xa1\x31\x0d\xce\x39\xf2\x3c\x8f\xeb\x28\x25\xab\
\xd5\x0a\x6b\x2d\x21\x04\xb4\xd6\x18\x63\xf0\x3e\x1a\xa4\x40\x50\
\xf6\xfb\x94\x45\x0e\x21\xde\x57\x6b\x60\xdb\x6b\xdf\x7e\x47\xbb\
\x97\xed\x67\xc7\xeb\x48\xdf\x6f\x0c\x32\x19\xa5\x0f\xa1\xfb\x8c\
\xed\xcf\xf1\xde\xe3\xac\x21\xcf\x33\x9a\xaa\xc2\x18\x83\x31\x35\
\x42\x40\x59\x96\x48\xa5\x50\x5a\xa3\x74\x5c\x3b\x63\x0c\x42\xc4\
\x03\x6e\xac\xc5\xba\xe8\x6c\x8a\xa2\x88\x06\x5c\xd7\x58\xe7\xf0\
\x08\x3c\x92\x10\x24\x52\x48\x94\x94\x94\x45\x41\x7b\x00\xda\xeb\
\x5b\xae\x96\x38\x17\xa2\xe3\x4e\xd7\xa6\xa4\x04\x21\xb0\xce\xa2\
\x95\x22\x78\x8f\x96\x12\x2d\x05\x20\xd1\x79\x0f\x21\x73\x94\x2a\
\x90\x2a\x43\x0a\x9d\xce\xb2\x8e\xaf\x91\x52\x51\x14\x05\x4d\x53\
\x63\xbd\x23\x78\x81\x97\xe9\x80\xbb\x90\x9c\x5e\x20\x04\x10\xd1\
\x31\x62\xda\x03\x83\xbf\xb1\xa8\xd6\x5a\x44\xf2\x72\xad\x27\x32\
\xd6\x90\x49\x89\xf7\x0e\x84\xc4\x5a\x8b\x35\x35\x5a\xe7\x94\x59\
\x1e\x5f\x23\x42\xb7\xc1\x36\x18\xf2\xa2\x24\xda\x38\x08\xa1\x00\
\x4f\x72\xc6\xe8\x4c\x23\x11\x08\x29\x91\xb9\x4e\x0b\xe4\x11\x40\
\x5e\x94\x68\x9d\x75\x07\x94\x14\xf1\x1c\x10\x04\x14\x79\x8e\xb3\
\x2e\x46\x11\x63\xc8\xb3\xbc\x8b\x14\x45\x51\x74\x91\x43\x08\x41\
\x51\x14\x9d\xc1\x40\x60\xbd\x5e\x91\x65\x39\xc6\x34\x84\x10\x37\
\xdc\xa6\x08\xa3\x94\xa2\x69\xe2\xe1\xdd\xbe\x77\xe7\x1c\x3a\xd3\
\xac\x57\x6b\xfa\x83\x41\x3c\x8c\xde\xa1\xb6\xd6\x0a\xa5\x29\xcb\
\x3e\x32\xf8\xb4\x8a\xf1\xf0\xb5\x9f\x11\x0f\xbd\xa5\x28\xca\xe8\
\x11\xad\xc1\x3a\x89\x35\x86\xa2\x28\xe8\xf7\xfb\x9d\x01\x5a\x1b\
\xbd\x74\x7b\xc0\x95\x8a\x3f\xde\x39\xb4\x56\x04\x02\xc1\x6f\xa2\
\x44\x1b\x1d\x5a\xc3\x6e\xa3\x11\xd0\x45\xa8\x10\x7c\x8c\x72\x4d\
\x83\x20\x20\x80\x60\x0c\x21\x04\xaa\xaa\xea\xa2\x66\x6b\x64\xd6\
\x9a\xf8\x9a\xe0\xf1\xbe\x35\x30\x8f\x73\xf1\xde\x85\x90\x28\xa9\
\xd2\xfe\x04\x42\xba\xef\x4c\x69\xa4\x52\xdd\x79\x93\xc8\x6e\x5f\
\xa3\x73\x12\x20\xe3\xf7\x1b\x13\x33\x80\x10\x1c\xc2\x05\xb4\x52\
\xe0\x2d\x4a\x67\x28\x01\x3e\xdd\x5b\x1b\xc9\x93\xbb\xc4\x87\x80\
\x77\x01\xeb\x0c\x42\x2a\x7a\xfd\x21\xde\x83\x48\x81\xa1\xa9\xd7\
\xd4\xc9\x39\x3b\x67\x90\x36\x2d\x96\x2e\x72\x1a\x6b\x62\x98\xca\
\x55\xf4\x10\xc6\xe1\x9c\xdd\x6c\x38\x01\x84\x40\x69\x8d\x96\x8a\
\x4c\x69\xc2\x96\x05\xb7\x61\x5e\xaa\xf8\xfe\xf6\x70\x69\xa5\x71\
\x21\x20\x95\x46\x49\x81\xd6\x8a\x7e\xbf\x4f\x96\x69\x82\x14\xd8\
\xe0\x01\x91\xd2\xa2\xe8\x61\xa4\xca\xe2\x4d\x27\xef\xd6\x79\xe0\
\x94\xbe\x58\x17\xd3\x0d\x21\x20\x78\x8b\x77\x3e\x46\x9a\x36\x95\
\x69\x8d\x34\x1d\xb9\x2c\xcb\x62\xfa\x95\x5e\xd7\x7a\xfb\x76\x11\
\xdb\xeb\x6f\xaf\xb9\x8d\x92\x00\x52\xa9\x78\x6d\x52\x90\x65\x19\
\x52\x2a\x7a\xbd\x5e\xf7\x19\xdb\x11\xa5\xaa\xd7\x5d\x94\xc9\xf3\
\x3c\x45\x3f\x41\xbf\xdf\x4f\x69\x9c\x40\xa5\xcf\x52\x4a\x81\x52\
\x18\xdb\xe0\xbd\xc5\xb4\x29\xa7\x14\x78\xc2\x26\x02\x0b\x81\x94\
\x9b\x6b\xca\x8b\x12\xef\x0d\x22\x3a\xc6\x6e\x4d\xda\x28\x19\x5f\
\xeb\xbb\x43\xef\xbd\x8f\x69\x06\x60\x8d\xc5\x13\x40\x0a\xac\x89\
\x11\x32\xbe\x47\x76\xf7\xb2\x9d\x35\xb4\x51\xd8\xfb\x40\xa6\x24\
\x21\xa5\x55\xed\x5a\xb5\xf7\xd8\xfe\x40\x20\xcf\x73\x8c\x31\x28\
\x15\x23\xa5\x56\x3a\xa5\xb5\x4d\x4c\x85\x43\x6b\x80\x19\x79\x96\
\x45\xc7\x12\x3c\xc6\xd9\x98\x26\x0b\x89\x94\x2a\x65\x0f\x19\x75\
\x55\xd1\xd4\x75\x17\xd1\xdb\xcc\x41\x0a\x41\x48\x7b\xed\x42\xbc\
\x47\x80\xca\x98\x2e\xe5\x33\xce\x52\x9b\x66\x63\xf0\x2e\x20\xa5\
\x88\x46\xaa\x74\x32\xa4\x4d\xda\x5a\x37\x0d\x52\x68\x1a\x6b\xa9\
\xab\x0a\x9d\x29\x89\xf1\x01\x7c\x5c\xfc\xcd\x0f\xd8\x10\xad\xbd\
\xf5\x34\x45\x9e\x63\x83\xc7\x85\x80\x92\x0a\x99\x2e\x16\xb1\x31\
\x90\x10\x42\xb7\xd0\xed\xc1\xb3\xce\x22\xd3\xef\x3c\x10\x84\xc4\
\xa7\xfa\xa0\x3b\x14\x6d\x1a\x27\x25\xa0\x71\xce\xd1\x18\xd7\x79\
\xb5\x36\x5d\x89\x5e\x1e\x7c\x10\xf1\xbf\x69\xe3\x49\xe9\x4e\x08\
\x01\x1b\x3c\x22\x79\xc5\xf6\x4f\xfb\x39\xdb\x9e\xb9\xf5\x78\x4a\
\x29\xf2\x3c\xef\xae\xb7\xad\x3b\x36\xf9\x75\x83\x40\x90\x67\x05\
\x20\xba\x54\xd1\xa5\xef\x8e\x91\x35\x2e\x7a\x7f\x30\x42\xca\x78\
\xa0\xe3\x81\x90\x28\x95\x41\x4a\x35\x21\xbe\xd6\x7b\x4f\x10\xf1\
\x90\x64\x79\x86\x33\x16\x54\x32\x02\x21\x31\xc6\x92\xf5\x32\x82\
\x8f\x07\x47\xa4\x3c\xbf\x2c\x4b\x84\x56\xd8\xb5\x25\xcb\x0a\x1a\
\x53\xa7\xba\x50\xdd\x48\x9d\x36\xf5\x8f\x20\x78\x41\xa6\x35\x9e\
\x58\xfb\xb4\xeb\xd9\x18\x83\x4e\x11\x7c\x7b\x3d\x84\x94\x18\x1b\
\xa3\x6b\x6b\x94\xe2\xf3\xf5\x94\xf7\xe8\x14\x35\xda\x35\x55\x4a\
\xc5\x1c\x3e\x9d\x0f\x21\x24\x5a\x4b\x04\x22\xd5\x85\x44\x67\x99\
\x22\x4a\xbc\x76\x49\x9e\xc7\x74\x4a\xb0\xd9\x97\x36\x92\x12\x04\
\x45\x59\xa6\xef\x84\xc6\x18\x10\xd1\x69\x19\x67\x11\x42\x47\xc3\
\x4d\x91\x16\x21\x28\x8b\x3c\x39\xcf\x40\xa6\x14\x5e\x4a\x44\x80\
\x20\x02\x88\x80\x10\x2a\xd6\xc8\xc8\x64\xb0\x81\xaa\xaa\x71\xce\
\x22\x04\xf8\xe0\xb1\x4d\x15\x3f\xb3\xb5\x3e\x93\x72\x58\x11\x88\
\x56\xa6\x24\x3a\x8b\xa1\xda\x3a\x4b\xa6\xb3\x64\xb5\x31\x3a\x78\
\x62\xee\xdc\x7a\xd9\xd6\x7b\xb5\xb9\x70\x7b\x93\x52\x4a\xa4\x92\
\x5d\xc1\x17\x3d\x9a\x43\x29\x8d\x90\x62\x13\xc6\x09\x5d\xb4\x6a\
\x0d\x32\xcb\xb2\xad\x1c\x57\x22\x84\x4f\xff\x26\x29\x8a\x58\xb8\
\x36\xa9\x2e\xc9\xb2\x2c\x7a\x5d\x64\x17\x31\x5c\xf0\x37\x72\xd4\
\x36\xc2\xb5\x05\x6e\x5b\x3b\x6c\x1f\x2a\xa9\x04\x22\x6c\x52\x86\
\x98\x23\x8b\xee\x60\xb5\x1e\xb5\xaa\xd6\x94\xbd\x3e\x02\xf0\x01\
\x8c\x33\xa9\xae\x68\xf3\xe1\x98\xde\x09\x04\x3e\x7d\x7e\x9e\xe7\
\xd1\xa8\xa4\x8c\x05\x62\xfa\xaf\x4f\x45\xa4\x52\x1a\x63\x2d\x1e\
\x50\x5a\x77\x8e\x47\x28\x89\x14\x82\x3c\x1d\xec\x18\x85\x32\x82\
\x0f\x48\xa9\xa8\x9b\x86\x4c\x8b\x14\x85\x37\xfb\x11\x52\x9d\x50\
\x94\x05\x75\x13\x8b\xde\xd6\x01\x02\x64\x45\x01\x02\x1a\xd3\x10\
\x00\x2d\x15\xc8\x08\x22\x6c\x17\xc6\xc6\x18\x08\x9e\xba\x6a\xba\
\xa8\x29\x53\x74\xdb\xd4\x87\x16\x9f\x9c\x98\x94\x12\x95\xc5\xc3\
\xea\xbd\xc3\x3b\x83\xb3\x96\xbc\xc8\xd3\x01\x85\x80\x8f\x75\x68\
\x9e\xc7\x7b\x25\x2d\x24\xd0\x34\x55\xbc\x37\xa5\x62\x11\x9f\xfe\
\x68\x25\x68\x4c\x3c\xc4\x68\x8d\xf7\x01\x9d\xee\x3b\x04\x8f\x4a\
\x7b\x1a\xb6\x92\xaa\x98\x52\x25\x47\xab\x35\x4a\x69\xac\xf7\xb8\
\xf5\x9a\x2c\x2f\x70\xd6\x51\x85\x65\x77\x2e\x21\x1a\x47\x5d\xad\
\xa3\x81\xb7\x69\x8a\x14\x90\x67\x59\xcc\x0d\xd3\x8b\x05\x71\x31\
\xb5\xd2\xd8\x54\x3f\x48\x21\xbb\x82\x4c\x7f\x2e\x95\x6a\x17\x67\
\xbb\x58\x6c\x17\x54\x29\x85\x69\x0c\xd6\xd4\xc9\xdb\x8a\x84\x50\
\xd9\x14\xde\xf5\x56\x91\x67\xb1\x29\x5a\x44\x6f\xef\xd3\x67\x66\
\x1d\x3a\xd5\xbe\x76\xdb\xab\xc5\xdf\xfb\xce\x13\xe9\x2c\x63\xb5\
\x9c\x93\xeb\x18\x1d\x8c\x31\x5d\x3a\xd1\x7a\x3c\x3e\x57\x2f\x39\
\x1b\x0f\x70\x5d\x57\x31\xad\xc8\xf2\x88\x8a\x28\x49\x48\x08\x99\
\xca\x34\x19\x05\xd6\x98\x88\xa2\x15\xf1\xf3\xbd\x4b\xe8\x99\x56\
\x48\x2f\x09\xce\xc5\x7a\x43\x2a\x02\x31\x12\xc8\x14\x47\x84\x14\
\x58\x6b\x90\x2a\x3a\x06\x2d\xa3\xe1\xca\x54\x33\xc9\x4c\x27\x44\
\xc8\x93\xa1\x62\xf1\x27\x52\x34\x0d\x1e\x95\x67\x88\x54\x88\xf7\
\xca\xde\x8d\xd4\x70\xdb\x01\x14\x45\x44\x89\xe2\xda\x89\x54\xbc\
\x9b\x8d\x13\xb1\x96\xb2\x28\xb1\x3e\x82\x34\x4a\x48\x82\x00\x97\
\x90\xc2\xb6\xb6\x8a\xb5\x9b\xe9\x0c\xac\xdd\xef\xe8\x58\x22\x02\
\x94\xa9\x8c\x3c\xcb\x11\x4a\xd2\x34\x15\x3a\x39\xa3\xa6\xa9\x3b\
\x54\xb4\xdd\xb3\x18\xa9\xe2\x7d\x39\xe7\xe2\x77\x14\x05\xc2\xc7\
\x08\x2a\x14\xd4\x75\x83\x73\x3e\xa5\x95\x11\xcd\xd2\x5a\x25\x14\
\x2b\xa5\xcd\x88\x14\x41\x25\xc6\x44\x03\x6e\x8d\x3b\x24\x67\xbf\
\x5c\xce\x51\x3a\xa3\xd4\x3a\x46\x32\x04\xab\x6a\x0d\xde\xe3\x83\
\x8f\x00\x89\x10\x54\xab\x15\x52\xc9\x88\xfa\x09\x09\x02\xb4\x92\
\x32\xe5\xc4\x12\x63\x1d\x75\xb0\xe4\x79\xd6\xe5\xf2\x45\x19\x61\
\x51\x25\x64\x2c\xa0\xa4\xc4\xba\x94\x87\xa6\x4d\xe9\x0a\xe2\x2d\
\x08\xd2\x5a\x4b\x9e\x6f\xc2\xb7\x94\x92\x3c\xcf\x51\x7a\x93\x2f\
\x47\x0f\x94\xb5\xc8\x67\x2c\xc4\x84\x40\x2a\x81\x0c\x1b\xb4\x4c\
\x29\x8d\xd6\xa2\x33\xb8\x0e\x26\x4c\x86\xd2\xfe\x5d\x48\x41\xf0\
\x21\xa6\x06\x42\x12\x02\x14\xc5\x00\xbc\x47\x4a\xd1\x79\xf0\x36\
\x1f\xdd\x7e\x3f\x40\x5d\xd7\x0c\x86\xc3\x58\x86\x06\x13\x73\x55\
\x29\x53\xa4\x17\x28\x2d\xb1\x95\xc5\x37\x26\x85\x68\x81\x5b\xaf\
\xa8\x12\x14\xbb\x0d\xbb\x06\x11\xb0\xde\x51\xd7\x15\xfd\xe1\x08\
\x89\x22\x00\x21\xd5\x17\x52\x4a\xac\x10\xd1\x80\x94\x8a\xc6\x17\
\x02\x2a\xa5\x0b\x32\xad\x63\x8b\x8a\xf8\xb4\x89\x42\x2b\xa4\x73\
\x31\x55\x4d\x7b\xd4\xd6\x51\xc6\x34\x29\xb7\x96\xe8\x4c\x11\xfc\
\x26\x92\xc4\xf4\xc3\xe3\x9c\xe9\x6a\x93\xb8\x5f\x9a\xc6\x1a\x82\
\x0f\x1d\x72\xd9\x1e\xae\x16\xf5\x69\x3d\x71\x9e\x47\x08\x7a\xbb\
\xa8\x27\xa5\x98\x79\x5e\x10\x9c\xef\x80\x95\x6d\x07\xd6\xeb\x0d\
\x52\x5d\x04\x4a\x45\x87\x1c\xc1\x8b\xac\x03\x76\xba\x88\x25\x04\
\x99\xce\x53\x94\x89\xe9\xbb\x68\x81\x1d\xeb\x52\xbd\x25\xf0\xde\
\xa2\xb3\x7c\x6b\x0f\x7d\x17\x19\xeb\xba\x4e\xb5\x6f\xcc\x02\xca\
\xb2\x8f\x4a\x99\x82\x94\x92\x4c\x67\x94\xbd\x3e\x55\x55\xe1\x6c\
\x83\xd4\x59\x3a\xeb\x25\xce\x9a\x04\x25\xc7\x08\xa7\x43\x2a\x52\
\xe2\x09\xf5\x11\x3a\x83\x78\xf1\x21\x7a\x1c\x08\x08\xa5\x70\x3e\
\xa0\xa5\x48\x9b\xb8\x81\x02\x6f\x86\x5a\xd7\x5d\x74\xfb\xa7\x83\
\x0f\xb7\x50\x93\xed\x1a\x25\xe6\x81\x31\x94\x07\xdd\x1e\xec\xa2\
\x2b\x50\x3f\x5f\x3c\xb6\x87\x7c\x1b\x5e\x8e\x79\x75\x4c\xf3\x8c\
\x69\x62\x24\x11\x1a\xa9\x42\xe7\x65\xba\x7c\x3a\xa5\x07\xc6\x58\
\x10\x90\xa5\xd4\xa3\x2c\x23\x1c\xdc\x1e\xca\x18\xb9\x52\x81\x2e\
\xc0\xa4\xc5\x53\x5b\x88\x9c\xca\x72\x84\x77\x1b\x28\xd1\x58\x84\
\xb1\x38\x6b\xd0\x4a\x33\x1c\x8d\x23\xe4\x9d\x00\x83\x0d\xb2\x67\
\x37\x20\x80\x54\xf8\x10\xd3\x2c\x5a\x74\xa9\x5d\x37\x42\x8c\x26\
\x3e\x74\xf9\x32\x01\x24\x02\x43\xe8\xa2\x6c\x6b\x68\xa4\x7c\x3f\
\x24\x9c\xbf\xdd\xdf\xc6\xd4\x1d\xba\xd5\x3a\x94\x36\xe2\x6b\xad\
\xf1\xd6\x6d\xa2\xa8\x77\x20\xe2\x01\xf7\x42\x26\x4f\x1d\x53\xea\
\xba\x5a\x77\xff\xbf\xbd\xdf\xf1\x70\x13\x8b\x6c\x29\xc0\x43\x90\
\x44\x8f\x9f\x9c\x61\x3c\xff\x72\x93\xf6\xfa\x10\xd3\x6c\x15\x8b\
\xfb\x6e\x6f\xd2\xfd\xeb\x4c\xa7\xf7\x6c\x10\x37\x29\x13\x4d\xb0\
\x55\x23\x46\x88\x38\xee\x4d\xae\x63\xfd\x9a\x69\x1d\x23\x11\x1e\
\xa4\xc4\x3a\x47\x08\x50\xd5\x0d\x2e\x40\x08\xf1\xbe\xeb\xf5\xa2\
\x43\xcf\x82\xf7\x58\x67\xbb\xf3\xe9\x9c\x8b\x09\xbb\x4f\xe4\x4b\
\x5d\xd7\x5d\xd1\x1a\x90\x34\xd6\xa2\xb4\x8a\x9b\x9b\x2c\x32\x01\
\xaf\x5b\xf0\x27\x88\x74\x00\xdb\x9f\x6d\x0f\xdd\x1a\x81\x10\x82\
\xe5\x62\x4e\xbd\x5e\x75\x88\x47\x9b\x7a\x85\x10\x17\x32\x62\xfb\
\xa2\x3b\xd0\x37\x8d\xa0\x35\x10\xdf\xd5\x0e\xed\xf7\x6d\x47\x24\
\xef\x3d\xc1\xb9\xe8\xcd\x9c\x63\xb9\x58\x74\x38\xba\x0d\x1b\x6c\
\x3c\xc2\xb1\x92\x22\x91\x70\xed\xe7\x48\xd9\x22\x35\x20\x94\x86\
\x84\x36\x09\x21\x91\x42\x91\x97\x25\x2a\xcb\x22\x9c\xa8\x34\x59\
\x9e\xa3\xb3\x0c\xe7\x23\x71\x15\x09\x3e\x4f\xd3\x34\x34\x4d\x13\
\x49\xaf\xaa\x62\xbd\x58\x74\x06\xd1\x16\xb6\xdb\xe8\x53\x5b\xb8\
\x7b\x1b\x8d\xcd\x6e\x19\x90\xb5\xb6\x43\x10\x49\x70\x75\xfc\x0c\
\x17\x23\x8d\xf7\x31\x25\x4a\xf0\xb6\x10\x92\xc6\xd8\x2d\xe7\x91\
\xa2\x80\xb7\x89\xf4\xdc\x44\x51\x63\x0c\x21\xc4\x3a\xb4\x36\x0d\
\x75\xd3\xb0\xae\x2a\x9c\x4b\x5e\xdd\xfb\xf4\x9a\x40\x5e\x14\xf4\
\xfb\x83\xce\xe1\xb5\xd7\xb8\xe1\x52\x2c\xce\x59\xac\xb1\x37\x80\
\x95\x0d\xbf\x12\x00\x4f\xcc\x3d\x52\x04\xb4\x06\x6b\x1b\x6c\x42\
\x9d\xe2\xde\xd3\x9d\x83\x96\xa7\x0a\xc4\x28\x5e\x1b\x83\x4f\xf0\
\x72\x74\x84\x9b\x5a\xa8\x4d\x9f\x49\xeb\xb8\xae\xab\xc4\xbb\x6c\
\xd0\xca\x5e\x39\x44\x8a\x2c\xa6\xdb\x79\xc9\xde\xd1\x6d\xfa\x83\
\x1d\xb4\xce\xa3\xf1\x26\xa7\x12\x17\xcc\xa1\xb5\x92\x04\x14\x79\
\x51\x32\x18\x8e\x53\x15\x1f\xd0\x4a\x52\x14\x45\x3c\x30\xce\x23\
\x64\x4c\x11\x08\x3e\xf2\x0f\x69\xf3\x08\x02\x47\x44\x59\xda\xf4\
\x82\x00\x81\xc8\x33\xb4\x86\x00\x30\x1c\x8e\xa8\x9b\x06\xb1\xb5\
\xa8\xf8\x14\x96\x85\x44\x29\x71\x23\xea\xb4\x9e\xa3\x65\x4d\xb7\
\x8d\x6f\x1b\x2d\xdb\xe4\xb5\x09\x4f\x4f\x87\xd4\x3a\x47\xbf\xec\
\x41\xba\xf6\x2c\xcb\xe3\x26\x79\x8f\x6d\x6a\x72\x95\x21\x84\xa2\
\x69\xd6\x9b\x9c\xdc\x39\xa4\xd6\xe0\x22\x77\xd2\x12\xa3\xf8\xc4\
\xc6\x4a\xd5\xdd\xd7\x86\x8c\x14\x64\x99\xee\x0e\x73\x74\x00\x03\
\xaa\xf5\x9a\xeb\xeb\x6b\xf6\x76\xf7\x22\xdb\x1b\x7c\xb7\x99\x5a\
\x29\x48\xde\xd1\xe3\x63\x94\x42\x44\xe2\xd0\x18\xf2\x14\x41\x5b\
\x52\xd5\x3a\x8b\x24\x02\x1e\x08\x81\x17\x21\xa6\x51\x22\x79\x5a\
\x19\x6b\x17\xe3\x5a\xb2\x33\x74\xa9\x1a\x21\xe0\xac\x07\xa5\xf0\
\xde\xde\x20\x5f\x95\x52\x78\xe7\x80\x58\xaf\x04\x1f\xd3\x3c\xbf\
\x85\x4a\x5a\x6b\xc8\x32\x8d\x73\x9e\x20\x24\x42\xc0\x7a\xbd\xee\
\xa2\x97\x4f\x29\x6c\xe3\x2c\xbd\x72\x90\x0c\xda\x11\xbc\xa3\x69\
\x3c\x99\xce\x36\x68\xe5\x8d\x9a\x6f\xc3\xdc\xdb\x54\xcf\x08\x11\
\x3a\xb5\x82\x52\x12\x6b\x93\x3a\x41\xca\x54\x1b\xc7\xf3\x57\x14\
\xc5\x8d\xe8\xb5\x5e\xcd\x29\x8a\x1e\x4e\x08\x5c\xbb\x6e\x09\x76\
\x0e\xde\xe3\x8c\x01\x29\x29\xfa\x63\x94\xca\x28\xfa\xa3\x64\xdc\
\x91\x54\x8c\x0e\x58\xc7\xc8\xaf\x75\xbc\x76\x6b\xd1\x1e\x70\x2d\
\x43\x1c\x88\x29\x55\x08\xb1\x0e\x10\x92\x10\xd2\xe6\x84\xcd\xc1\
\x6c\x37\xb9\x69\x0c\x99\xce\x22\xa1\x83\xef\x6e\xd6\xa7\x83\xda\
\x2e\x70\x88\x16\x43\x10\x11\xb2\x6b\x83\x90\x10\x82\xe0\x21\xd3\
\x59\x82\x0a\xb9\x11\x75\x5a\xaf\xd3\xd4\x15\x59\x56\x74\x92\x82\
\x6d\x26\xbf\xcd\xaf\xdb\x54\x6c\x53\x8f\x6c\xd2\x24\x3a\x80\x35\
\xde\x5f\xd3\x18\x7a\x79\xc1\x6a\xb5\xa2\x28\x7b\x37\x78\x90\x78\
\x4d\x21\x46\x89\x94\x86\x84\x10\xf0\xc6\xe0\x42\x40\xb3\x49\x4d\
\x3a\x69\x45\x4a\x7f\x22\x92\x97\xa7\xeb\x8e\xf7\x2a\x64\x4c\x7f\
\x32\x9d\x11\xec\x46\x9a\x12\x1d\xc9\x86\x54\xf4\xde\xa3\x32\xdd\
\x19\x5f\x7b\x3d\x52\x46\x75\x41\x91\xa4\x27\xad\x63\xd8\xc0\xdf\
\x1b\x23\x5a\x57\x15\xde\xdb\xc4\xd7\x14\x28\xad\xa9\xea\x9a\x4c\
\x69\xfa\xfd\x3e\xc6\x98\x04\x1a\x68\x22\xc0\x97\x3c\x39\x51\xee\
\x22\x84\xc0\xb8\xf8\xfd\x3e\x45\x8d\x10\x12\x50\xe1\x43\x92\xe2\
\x88\x54\x13\x6e\xa5\x56\x89\xcc\x55\x4a\x6f\xc8\x3f\x1f\x92\xc3\
\x49\x04\x6e\x4a\xef\x92\x76\x03\x6f\x1d\x55\x5d\x51\xf6\x7a\x89\
\xb0\x2d\x93\x22\xc2\x76\xfb\xee\x12\xe8\xd1\xae\xb3\x92\x12\x99\
\x17\x5d\x06\x13\xf7\x2d\x49\x4c\xb2\x9c\x90\x90\xaa\xb2\xd7\xbb\
\x01\xef\xfb\xe0\x21\xa4\xa8\x32\xbf\xa6\x1c\x4d\xa2\xd3\xf0\x72\
\x2b\x3d\x73\xf8\x10\x29\x08\xa9\x34\x8d\x6d\x20\x04\x74\xc4\x9f\
\xe9\x10\x8b\x08\x47\x16\xc4\xe4\x2b\x2e\x50\x91\xe7\x09\x39\x48\
\x1a\xa8\xe4\xe1\xb5\xd2\x9b\xc3\x18\x20\xcb\x36\x85\xb5\x14\x12\
\x51\x6c\x50\x2a\x1f\x7c\x34\x0a\xb5\x81\x21\x85\x10\x11\x1d\x73\
\x31\x7f\x35\xa6\x41\xeb\x88\x1a\x05\x5a\x16\x50\x50\x94\xfd\xee\
\x60\xb5\x69\x89\x40\x50\x9b\x7a\xab\x8e\xd9\x68\xa3\x32\x1d\x21\
\xdf\x58\xb8\xa9\x1b\xa9\x5a\x8b\xec\x58\x63\x22\x2c\x28\x25\x5a\
\x95\x58\x13\xb5\x62\xc6\x58\x74\x2e\x10\x5b\x68\x0b\x3e\xd6\x10\
\xb9\xda\x14\xe1\x82\x0d\x5b\x1b\x82\xc7\xda\x90\xf2\x6d\xd7\xb1\
\xed\x91\x50\x1c\xe0\x9c\xbd\xe1\x58\x3e\x6f\xe0\xed\x7d\x09\x11\
\x81\x84\xa6\x69\x3a\x2f\xdf\xa2\x6f\xce\x58\x54\xa6\x6f\xe8\xc3\
\x42\x2a\xea\x01\x4c\xd3\xa4\x68\x52\x44\x94\x30\xe9\xe4\x94\x48\
\xe8\x5a\x8a\x76\x45\xde\x4b\xeb\x14\xb9\x93\x20\xc3\x0d\x63\x74\
\xce\x13\x82\xd9\xd4\x29\x69\x9f\x22\x42\x24\x69\xea\x58\xb8\x67\
\x59\x4e\xd3\x24\x0e\x46\xb6\x8e\x49\x75\x7a\xb7\x10\x1c\xc6\xc5\
\x68\x6a\x5d\x24\x72\x91\x11\x1d\x2b\x8a\x74\xbe\x52\x94\x6b\xb5\
\x63\xd8\xc8\x7b\x08\x11\xa5\x43\xce\xbb\x2d\x36\x3f\x65\x0c\x5b\
\xfb\xdd\x2a\x05\xea\xba\x66\x39\xbf\xa6\xe8\xf5\xe9\x67\xd9\x0d\
\xe7\x6a\xad\xc3\x3a\x43\x70\xd1\x79\xd5\xd5\x92\xd0\xa2\x6e\x3a\
\xc7\x13\x70\x89\x14\x6c\x81\x11\xef\x0c\xc1\x59\x7c\x70\xe8\x96\
\x45\x0c\xc9\xba\x75\x96\xe3\x02\xd8\xba\xa1\xd7\xeb\xc7\x2f\x13\
\x89\xb3\x49\x12\x93\x2c\x5d\x74\x4b\x22\x22\x22\x86\x5e\x35\x0d\
\x2a\x79\x18\x6b\x4d\xe4\x3e\x3a\x23\x12\x37\x52\xab\x90\xf0\x69\
\x89\xc0\xf8\x98\xef\x2a\xa5\x13\xef\x98\x3c\xbe\x80\xb0\x75\x90\
\xda\x28\xe1\x53\x31\xd5\x16\xfc\xad\x07\x6e\xd3\xa4\x40\x88\xfc\
\x43\xf2\xe4\xce\x1a\x02\x21\xa5\x58\x89\x81\x95\x92\x4c\xab\x94\
\x82\x80\xce\x73\x9c\x31\x94\xfd\xa2\xcb\xf5\x5b\x58\xb8\xa9\x2b\
\x54\x12\xd9\x75\x35\x03\x01\x53\xad\x63\x2d\x92\x65\xdd\x7d\xb5\
\x5c\x50\xe4\x6d\x5a\x87\xa1\xbb\x48\xa7\xd4\x86\x2b\xf2\x89\x6c\
\x93\x22\x31\xc6\x75\x95\x3c\x76\x76\x83\xb8\xab\xd7\x6b\xa4\x56\
\xe8\x04\x77\x67\x59\xd6\xd5\x4d\x51\x08\x18\xbf\xbb\x2c\x62\xd4\
\xe8\x80\x8c\xd6\x59\x29\x09\x3e\xdc\x80\xb3\xb7\x05\x99\x1d\xa1\
\x6b\x2d\x45\x91\x77\xba\xa6\xe0\x36\xc6\xe1\x9c\x45\xc9\xac\x03\
\x12\xb6\x89\xdd\xe0\x3d\x55\xb5\x8c\xf7\x27\x75\x27\x65\x11\x04\
\x6c\xd3\xa4\x88\xa6\x92\xec\x27\x19\xab\x90\x64\x59\xb1\xa9\x51\
\x5b\x1e\x4c\x46\xbe\x2d\x24\x5e\x6d\xa3\x8b\xab\x63\x44\xb6\x51\
\x17\xa7\x94\xc2\xa6\x28\xa1\x94\x62\xb4\xb3\x8f\x4e\x40\x48\x80\
\x68\x70\xde\x23\x42\x40\x0b\x05\x49\xa4\x1a\x82\xa3\xa9\x96\x91\
\xc3\x03\x9c\x0f\x51\x9c\x68\x0d\xa6\x89\x8e\x88\xe4\x00\x81\x0d\
\x8a\x25\x53\x8e\xa7\xba\xe2\x5a\xdd\x38\x10\xdb\x79\x6b\xab\xf1\
\x10\x52\x80\x4b\x34\x7f\xf0\xa8\x84\xe2\x44\x4e\x23\xa1\x4f\x42\
\xa4\x43\x28\xb6\xde\xdb\x26\x3d\x02\x95\xd4\x97\x9d\xb7\x96\xd1\
\x3c\x4c\x4b\x5e\xe9\x2c\xe9\x62\x5c\xf7\x9a\x96\xd4\xd1\x3a\xeb\
\xa0\xe4\xb6\x28\x8c\x91\xc4\x47\x1c\x3b\x7d\xa1\x52\x92\xf5\xba\
\x42\x29\xdd\xc1\xc6\x2a\x31\xba\x2d\xb3\x2d\x13\x1e\x2f\x3e\x67\
\x90\x51\x4d\x5b\x74\x87\xc1\x5a\x13\xeb\x12\x22\xcf\xa2\xf3\x62\
\xcb\xdb\x3a\x56\xab\x65\xc7\xb6\xb7\xf5\x48\x8c\x7e\x4d\x32\xf0\
\x2c\x15\xf2\xb6\xab\x79\xb2\x3c\x03\x02\x45\x91\xa7\x03\xcf\x06\
\xbd\x0b\x90\x69\x45\xa0\x45\x7b\x20\x38\x87\xf5\x1e\x9d\xe5\x1d\
\xa1\xb9\x5a\xaf\x99\x14\x3b\x98\xa6\xe9\x20\xcd\x96\xbc\x6d\xd5\
\xb5\x65\x51\x24\x35\x6b\x5b\x77\x24\x54\xe9\x73\x35\x1f\xe9\xf5\
\x52\xa9\xce\x19\xb6\x00\x46\x9e\x65\x91\xcd\x6e\x75\x73\xd6\x75\
\x10\x7a\x24\x7c\x3d\xce\xba\x98\x56\x13\xf0\xc1\xa1\xd0\x9d\x01\
\xc6\x48\x10\xef\xb7\x4d\x8d\xbd\xf7\x5d\x3d\x16\x2f\x27\x42\xea\
\xce\xda\x08\x7d\x0b\x99\xea\x28\x8b\x77\x16\x6b\x0d\x45\x6f\x84\
\xce\xb6\x22\xba\x10\x34\xc6\xe0\x9d\x23\xcf\x32\x44\x88\x57\xd0\
\x46\x45\x21\xc0\x5a\x87\x33\x0d\x79\xde\x8b\xf5\x9a\xa9\x23\x97\
\xe3\x2c\xa6\xae\x08\xde\xc5\x52\xc1\x45\x36\x3d\x78\x8f\x46\x08\
\xbc\xf3\x9d\xb7\x35\xc6\xde\x28\xac\xdb\x9b\x2a\xcb\x5e\x97\x67\
\xfb\x10\x25\x03\x3e\x78\x7c\xca\x63\x5b\xb9\x47\x2c\xe4\x5c\x67\
\x81\xad\xac\xbc\x65\x3b\x5b\xa4\x42\x29\x45\xe8\xf4\x43\xa9\x78\
\x6e\xc5\x65\x3e\x4a\x19\x32\x9d\xa5\x0b\x0d\x29\xc2\xa8\x0e\x19\
\x6a\x0f\x6d\x64\xdf\x75\xe7\x59\x63\x11\xaf\x92\x67\x53\x20\xa2\
\x80\xaf\xf5\xac\x52\xc8\x2e\x1a\x76\x52\x7c\xe7\xba\xd4\xad\x23\
\xbf\xbc\x43\x27\x09\x44\x27\xe0\x0b\xd1\x50\x9f\x7d\xf2\x88\xef\
\xfd\xf9\xb7\x98\x1c\x1c\xf3\xc5\xaf\xfe\x1c\xd7\x57\x57\x28\x09\
\x8b\xe5\x8a\xb2\x28\xb0\xce\x71\x70\x74\x4c\xaf\xe8\x51\xec\x8c\
\x09\x21\x7a\xdc\xa8\x15\xaa\x93\x30\xd4\x51\x55\x15\xc1\x34\x0c\
\x86\x43\x8c\x07\x9c\x45\x2a\x4d\xb5\x5e\xd2\xeb\xf5\xb0\x8d\xa5\
\x5a\x2d\x38\xfd\xf8\x03\xd6\x5e\xf3\xec\xf1\x27\xdc\xbd\xf7\x80\
\xd5\xe5\x4b\xde\xfb\xf9\x5f\x42\x8d\xf7\x59\x4d\xcf\x29\x47\xbb\
\x0c\xfa\x03\x6c\xbd\x66\x35\xbb\xa4\x3f\x39\xea\x74\x52\xf1\xba\
\x03\x45\xaf\x84\x20\x22\x83\x2d\x65\xe4\x12\x5c\x42\xfd\x00\x53\
\xaf\xc9\x8a\x7e\xf2\xe6\x22\x72\x49\x84\x4e\xdf\x14\x92\x96\xca\
\x59\xd1\x09\x18\xdb\xcf\xb1\xc6\x74\x2d\x09\x2d\x22\x27\x80\xa6\
\x8e\x91\x47\x0a\x49\x68\xf7\x36\x44\xef\xde\xd6\x88\x2e\x49\xe1\
\xa3\x71\x82\x14\xd1\x49\xb6\xd7\xa1\xda\xc8\x9c\xb8\x0a\x84\xa4\
\xec\x0d\x22\x98\xe4\x2c\x21\x9d\xa5\xf6\xcc\xca\x4e\xc9\x60\x53\
\x04\x22\x45\xda\x88\xd6\x79\xef\xa8\xd6\x8b\xd8\xea\xe0\x62\x34\
\xc2\xfb\x58\x1a\x69\x85\x35\xe9\xec\xfa\x58\x3b\x89\xf3\x85\x0b\
\xd6\x06\x5e\xbd\x7c\xc6\xd9\xd9\x59\x3a\x28\xea\x86\x06\xaa\x85\
\x55\x5b\xa8\xd5\x79\x8f\x96\x11\x41\x69\x25\xcb\x1d\x81\x97\xa4\
\xd0\x51\x09\xec\x3a\xa6\x3d\x42\x85\x1e\xa5\x15\xce\x26\x21\x5d\
\x42\x31\xa4\x50\x11\x07\x4f\x28\x4c\x0b\x70\xc9\x94\xa2\x98\xa6\
\xb9\x81\x58\xb5\x91\xa7\xae\xd6\x38\x67\xa3\x12\x76\x4b\x67\x25\
\x3b\x29\x04\x84\x10\x0f\x62\xdb\x53\xd1\x45\x45\x17\xaf\x45\x20\
\x30\xd6\xdc\x50\xf3\x3a\x9b\x7a\x40\xbc\xeb\xd2\x2c\xef\x3d\xde\
\xd4\xfc\xe0\x2f\xfe\x98\x7f\xf2\xbf\xfc\xcf\xb1\x5e\x92\x82\x9d\
\x9d\x01\x87\x47\x47\xcc\x97\x0b\xa6\x57\x53\x16\xf3\x39\xc3\x41\
\x1f\x67\x41\x29\xc1\xc9\xdd\xd7\xd8\x3b\x3e\xe6\xfe\xeb\xef\xf2\
\x33\x5f\xfb\x3a\x93\xbd\x83\x08\x74\x5a\x43\xd3\xd4\x7c\xef\xcf\
\xff\x88\x0f\xbe\xf3\x67\x7c\xf5\x97\xfe\x3a\xa5\x92\x1c\xdf\xbe\
\x8d\xb3\x96\x47\x1f\xfe\x98\xdf\xfc\xdf\x7f\x9d\x5e\x91\x71\x35\
\x5b\x52\x79\x0f\x49\x45\x90\x49\x85\x17\xf0\x85\x2f\x7f\x95\x9d\
\xbe\xe6\xf0\xce\x3d\xde\xfa\xc2\xcf\x71\xf6\xc9\x0f\xb9\xf5\xf0\
\x4d\xf6\xee\xbc\x81\xd4\x19\x12\x41\x55\xad\x92\x0e\x8b\x1b\x5c\
\x92\x88\x25\xc0\x06\x34\x50\x22\x15\xae\x0e\x53\xd7\x29\x1d\x92\
\xdd\xbe\x49\x91\xd0\xb4\x36\x75\xd6\x3a\x66\x19\xde\xe1\x9c\x61\
\xbd\x5e\x92\xe7\x65\x17\x15\x63\x1f\x48\xdb\x03\x94\x75\x69\xbc\
\x4a\x9c\x44\xeb\xe4\xac\x8d\xfd\x43\x59\x96\x23\x3b\x35\x6f\x4a\
\x9d\x91\x89\x3f\x12\xc9\x20\x1c\xc6\x36\x69\x3f\x52\xca\xa8\x34\
\x59\x5e\x6c\x71\x4a\xb1\xe6\x52\x9d\xf3\xb3\x5d\x66\xd1\xa6\xe1\
\x11\xf8\x59\x47\x69\x7d\x02\xa6\x5a\xb9\x53\x08\x1e\xef\x5c\xba\
\xf6\x80\x38\x5f\xf8\x60\x9d\xe7\xe5\x8b\x67\xbc\x7a\xf5\x2a\xea\
\x5f\xda\x7c\x5b\x45\x96\xbd\xd3\xe4\x58\x47\x51\x44\x64\xa2\xbd\
\xc0\xd6\xfb\x46\x04\xc3\x76\x4d\x3d\xad\x47\x68\x59\xa1\xd6\x33\
\xb7\x4c\x7b\x44\xbb\xdc\x8d\x74\x28\x10\xbd\x74\x22\x54\x3b\x34\
\xc8\x3a\x43\x96\x9a\xb6\x5a\x09\x80\x48\xb9\x6f\xcb\xec\x46\x82\
\xd0\x74\x91\x24\x2a\x6b\x2b\x08\x74\x0c\x7a\x6b\xf0\xad\x91\x6c\
\xb4\x61\xfe\x86\x80\xb1\xf5\x48\xc6\x18\x4c\x13\x09\x36\x29\xe0\
\xe5\x67\x3f\xe1\x37\xff\xe9\x3f\xe2\x47\x1f\x7d\xc6\x7f\xf0\xef\
\xff\x32\xb7\x4f\xf6\xb8\x7d\xeb\x88\xf3\xd3\x53\x76\xf7\xf7\x59\
\x57\x0d\x38\xcb\xf1\xad\x13\xe6\xb3\x39\xd6\x0b\x08\x8e\x8b\xf3\
\x4b\xfa\x83\x21\xae\x59\xb1\xb3\x7b\x04\xe5\x98\x17\x2f\x4e\xf9\
\xe1\xf7\xfe\x92\x6a\xb5\x84\xe0\x78\xeb\x8d\xfb\xf4\x7a\x7d\x7e\
\xf2\xe1\x4f\x81\xc0\x83\x37\xdf\x60\xb1\x58\xa2\x75\xce\xb7\xff\
\xe4\x8f\xf9\xda\xd7\xbe\xc4\xee\xd1\x31\xcf\x9f\x3e\x43\x12\x58\
\xaf\x56\xdc\x3d\x1c\xf2\xf0\x9d\x77\xb0\x2e\xb0\xac\x1d\xa7\x67\
\x57\xe4\x59\xc1\xc2\xf7\xb9\xf3\xe0\x0d\xc6\xe3\x31\xeb\xe9\x05\
\x0f\xde\xfd\x32\xad\x6a\xbb\x6b\xbe\x72\x81\x60\x23\xf7\xb0\x5a\
\xce\x41\x0a\x8a\xbc\x07\x78\x4c\x5d\x45\x27\x98\xd0\xc5\xe8\xe1\
\x41\xa4\xf5\x89\xcd\x58\xae\xdb\x7f\x2d\x25\xce\x6f\x34\x78\xad\
\xd4\x3d\xd6\x14\x6a\x4b\x42\xdf\xd6\x3c\xaa\x6b\x43\x58\x57\x6b\
\xbc\x6f\x35\x78\x82\x7e\x7f\x18\xa3\x8e\x54\x09\x69\x73\xd1\xc0\
\x74\x16\x9d\x5e\xf0\x20\x44\xd4\x7e\x79\xdf\xb1\xe4\x42\xc8\x04\
\x16\x45\x27\x2d\xa5\xa0\x69\x4c\x97\xb5\xb4\xd7\x0d\x6d\x14\x59\
\x6e\x1c\xea\x56\xc3\x55\x9b\xf2\x59\xd3\xc4\x48\x77\xbe\x70\xc1\
\xba\xc0\x8b\x67\x4f\x39\x3b\x3f\x8b\xc2\xb1\x94\xd2\x20\xe8\xbc\
\xad\xf7\x49\xea\xde\xea\xf5\x21\x76\x7f\x05\x9f\xd4\x9a\xa1\xd3\
\x4c\x6d\x48\xbb\x0d\x7c\xd8\x1e\xfa\xed\xe6\x21\xe7\x6c\x52\x85\
\xc6\x74\xad\xae\xeb\x2e\x0c\xb7\xf2\xeb\x18\x39\xa2\xea\xb2\xaa\
\xd6\x64\x4a\x6f\xea\x9f\x96\xed\xf6\x21\x49\xb2\x6d\x87\xfd\x4b\
\x04\x21\x71\x0a\xb1\xb3\x51\x6c\xe4\x2d\xa9\xfe\x68\xe5\x19\x59\
\x9e\xe3\x1a\x83\xd8\x6a\x78\x02\x58\x2f\x66\x7c\xef\x5b\xff\x9a\
\x9f\xfb\x85\x5f\xe4\xe2\xe2\x15\x6e\xbd\xe2\xf9\x93\x1f\xf3\xe6\
\xc3\x7b\x5c\xcf\x17\xd8\xba\xa2\x59\xcc\x28\xfa\x05\x7b\x87\x77\
\x59\xac\x2a\x9c\xad\x39\x3e\x39\x21\xf8\x28\x13\xb9\x38\x3b\xe5\
\xf9\x93\x47\x14\xb2\xa4\xd7\xcf\xb1\x48\x5e\x7f\xe7\x4b\x0c\x06\
\x7d\x5e\xbe\x7c\xc1\xfc\xfa\x1a\x92\xb4\xe1\xe4\xce\x3d\x16\xd3\
\x29\x8e\xc0\xf4\xf2\x92\xc9\xee\x84\xf9\x62\xc9\xc3\x87\x0f\x99\
\x5e\x5d\x52\x55\x0d\x3f\xfa\xe1\xfb\x2c\xce\x5f\xe0\x83\xa0\xdf\
\xcb\xc8\x25\x3c\x7c\xf7\x5d\x0e\x4f\x6e\x71\xfc\xda\x9b\xbc\xff\
\xe3\xf7\x31\x5e\x70\x7a\x7e\xca\xd9\xf9\x25\x9f\x7e\xfc\x04\x9d\
\xf5\xf8\xe2\xd7\x7e\x9e\xf7\xbe\xf2\x35\xf6\x0e\x0e\x23\x64\x2e\
\x24\x4d\xb5\xec\xea\x01\x97\x40\x8f\xba\xae\x3b\x16\x7f\xb9\x8c\
\xa9\x5e\x27\x51\xef\x18\x71\xff\x57\x0e\x52\x04\x27\x62\x0d\xe0\
\x12\x13\xbd\xc9\x3c\x12\x8f\x95\xd2\x5f\xb6\xf4\x7c\xed\x67\x5b\
\x67\xb1\xc6\x33\x18\x0c\xb6\x9c\x6f\x3c\xe8\x9e\x80\xd2\x19\x5a\
\xe5\x49\x29\x1d\xdb\x0a\x84\x50\x94\x49\xe9\x1b\xf9\x24\xa2\x24\
\x2a\xed\x6b\x9b\xd9\x78\xef\xb1\xb6\xc1\x99\xa6\x43\x55\xab\xba\
\xba\xa1\xf8\x68\xef\x69\x23\xaa\x8d\x86\x2e\x2e\x16\x3e\x58\x1f\
\x78\xfa\xe4\x31\x17\x97\x17\xa9\x99\x25\x35\xda\x6c\x45\x8f\x56\
\x2c\xb8\xcd\x45\xc4\x28\xd0\x0a\x40\x37\x91\xc2\x6e\x85\xb8\xd8\
\xa4\x12\xb1\xf6\xf8\x3a\x9f\x64\x10\x74\x82\x35\xef\x23\x07\x62\
\x9a\x24\xe5\xd0\x0a\x41\xcb\x4d\x24\x32\xcb\xdb\x4e\x5a\xde\x34\
\x15\x45\x11\xbb\xd3\x4c\x0a\xcf\xdd\x3f\x86\x80\xb5\x11\x52\x6e\
\x37\x27\x72\x1b\xb1\xe8\x6a\xbd\x44\xdd\x44\x63\xb4\xcd\x9a\x6a\
\x3e\xe5\x93\xf7\x7f\xc0\xc1\xbd\xd7\xb9\xff\xfa\xdb\x9c\x3e\x7f\
\xcc\xf5\xd5\x15\xdf\xfd\xc3\x7f\xc1\x9b\x6f\xdc\xa3\x57\x28\x46\
\xa3\x1e\x0f\x1f\xde\x45\x2a\xc5\xc5\xd5\x8c\xeb\xcb\x2b\x96\xf3\
\x6b\x7a\xe5\x80\xf1\x64\x87\xc9\xee\x1e\xab\xe5\x8a\x8b\xcb\x4b\
\x46\x3b\x7b\x3c\xfd\xec\x13\x86\xe3\x5d\x46\xe3\x1d\xaa\x7a\x4d\
\xf0\x02\x53\xad\x28\xcb\x82\xc5\x7c\xc6\x78\xef\x90\xa6\x5e\x91\
\x17\x25\x4d\x13\x15\xc3\x93\xfd\x23\xb2\x4c\x53\x57\x35\xc6\xd4\
\x5c\x5f\x5e\x90\x25\x85\xc1\x62\x36\xe5\xec\xd5\x29\xe7\x17\x73\
\xee\xbd\xf1\x3a\x27\x47\x13\x96\xd7\xe7\x3c\x79\xff\x87\xf4\x47\
\x3b\x1c\xdd\xbe\xc5\xfe\xc9\x1d\x96\x4e\xf3\xf8\xb3\x4f\x39\x3e\
\x3e\x64\x38\x99\xb0\x5e\x2e\x71\xc6\xb0\x5a\xae\x50\x4a\x60\xad\
\x60\xef\xe4\x3e\xc3\xc3\xbb\xac\x17\x0b\xfa\xe3\x83\x14\x55\xb7\
\x18\x6e\x1f\xba\xfe\x0b\xad\x55\x07\x2b\x0b\x36\xcd\x50\x2e\xf5\
\x6e\x34\x4d\xdd\x81\x01\xce\x19\x94\x54\x34\x75\x8d\xb1\x35\x65\
\xd9\x27\xf8\x9b\xfd\x39\x52\x6d\x1c\xe0\xe7\x21\xeb\x4d\xef\xcb\
\x86\xfb\x90\x4a\xd1\x42\x9a\x42\xb4\xe9\x56\xe4\xd6\xbc\x87\x6c\
\xab\xb3\x72\x1b\xf2\xef\x38\x10\xef\x52\xfd\x11\x58\x2d\x67\x51\
\x80\xab\x36\xe9\x78\x53\xaf\x3b\xa4\x4e\xca\x8d\xd0\xb1\x55\x01\
\x47\x03\x71\x70\x7a\xfa\x82\x97\xaf\x5e\x26\xcf\x00\x65\x91\x47\
\x6b\x4f\x32\x84\xc8\x7b\x64\x9f\x23\xc8\x3c\x5d\x5a\x97\x8a\x6c\
\x9f\x16\xbb\x69\x2c\xce\x5b\xf2\x2d\x65\x65\x0c\x73\x21\xb1\xce\
\x02\x64\x44\x64\xea\xba\xbe\x91\x62\xb5\xfd\x01\x6d\xca\xd4\x46\
\x93\x98\x1f\x26\xd4\x22\x2d\x88\x69\xbd\x56\x6a\x0b\xf5\xde\x53\
\xe4\x45\xfa\x9e\x4d\x67\xa1\xb5\x96\x4c\xe9\xae\x3b\xd0\x79\xc7\
\xe3\x1f\x7f\x8f\x0f\x7f\xfc\x7d\xfe\xec\x5b\x7f\x8c\x33\x51\x16\
\xbe\x77\xb4\xc7\x97\xbf\xf4\x16\x83\x41\xc1\xf1\xc1\x98\x9d\xdd\
\x7d\xce\x2e\x2e\xd9\xdd\x19\xb3\x5e\x2d\x98\x4d\xa7\xf4\x06\x13\
\x76\x76\xc6\x28\x29\x59\xcd\xaf\x31\xcd\x82\xf1\x78\x42\xd9\x1f\
\xf2\xe2\xd5\x39\x38\x8f\x50\x1a\x99\x15\xac\x16\x4b\x46\xbb\x13\
\x56\xab\x35\x93\xc9\x04\x25\x3d\xfd\xc1\x90\xa7\x9f\x3c\xe2\xfc\
\xf4\x92\x2f\xfc\xec\xd7\x59\x2e\x66\xd4\x75\xcd\xd1\xf1\x09\xab\
\xe5\x92\x2c\xd7\x3c\x7f\xfc\x18\x2d\x61\xbd\xae\x39\x3f\xbd\x60\
\x32\x19\xd1\x1f\x4f\x28\xfa\x7d\x6c\x53\x51\x16\x19\xae\x9e\x77\
\x68\x8d\xa9\x6a\xae\xaf\xa7\x1c\xdf\x7f\x9b\xcb\x8b\x0b\x76\x26\
\x3b\xcc\x57\x73\x0e\xf6\x8f\x98\x5e\x5f\x32\x1a\xf6\x31\x66\x4d\
\xa6\x7b\x9c\xbd\xba\xe2\xec\xf2\x9a\x93\x3b\xf7\xb9\xff\xc5\x9f\
\xc7\x07\x19\x65\xde\xd6\x76\x12\xfb\xe8\x50\x5c\xd4\x27\x35\x06\
\x99\xf8\x86\x2c\x21\x47\x75\xb5\xda\xc8\x92\x42\x92\x90\xb8\x28\
\x4b\x69\xa1\xe5\x4d\xe7\xa2\xbf\xd1\x47\x13\xa3\x3a\x9d\x92\xb7\
\xcb\x4a\x42\xcc\x3a\xa4\x8c\x70\x7f\x5d\xd7\x51\x9d\x5b\x94\x7f\
\xb5\x89\xad\x55\x72\x24\x54\x6e\x73\xb6\xb2\xae\x5e\x6e\x7b\x79\
\x4c\x53\x6f\x69\x02\x1d\xd6\xd8\xc4\xe1\x10\x9b\xc6\x00\x97\xde\
\xa0\x3b\x0a\x23\xa9\x36\x62\x3e\x1f\xba\x4e\xb7\x00\x14\x45\xbc\
\xe9\xaa\x6e\x28\xf3\x1c\x25\x15\x55\x5d\x23\xc5\x16\xeb\x9b\x48\
\xac\xd6\x30\x42\x22\xd3\x7c\x22\xc5\xb2\x4c\xe1\x6a\x87\x73\xa1\
\x0b\xa3\x6d\x18\x8b\x0b\x1b\xb1\xf0\x20\x05\x45\x41\xe2\x35\x14\
\xde\x05\x40\x22\xa4\xa2\x28\x74\x47\x9a\x75\xf8\xb0\x8c\x11\x49\
\x4b\x95\x7a\x0d\x22\x6a\xa2\x84\xc2\xbb\xc8\xd1\x44\x18\x17\x40\
\xa6\xee\xb1\x8d\x64\xde\x39\x8b\x6d\x2a\xde\xff\xce\xb7\xf8\xe6\
\x6f\xfe\x06\xeb\xeb\x0b\xbc\x0f\x14\x79\x41\x35\x5f\x32\x7e\x78\
\x44\x96\x49\x26\x93\x31\xc3\xc9\x2e\x83\x41\x8f\x10\x0e\x58\xaf\
\x97\x8c\x27\xfb\xec\x1e\xbd\xc6\xf5\xe5\x75\xd7\x60\x93\x67\x19\
\xcb\x6b\x4b\x7f\x52\x32\x5d\x36\x94\xbd\x01\xf5\xba\x22\x10\x98\
\x5e\x4f\xe9\x0d\x07\xf4\xfb\x03\xa4\x50\x3c\xfd\xec\x33\xee\xde\
\xbf\xc7\xf5\xf5\x94\xe9\xd5\x25\xb7\xef\x1c\x47\x05\xae\x94\x54\
\xab\x35\xce\x05\x1a\x63\x30\x4d\xc3\xc3\xb7\xde\xe2\xfa\xfc\x14\
\x29\xe7\x14\xaf\xdd\xa1\x36\x35\x65\xaf\x40\x0a\x30\x3e\x0a\x2c\
\x33\xbd\xcb\x74\x7a\xcd\xfe\xfe\x1e\xf3\xc5\x92\x61\x36\xe0\xc9\
\xe3\xc7\xdc\xb9\xff\x00\x29\x15\x07\x83\x01\x9f\xfe\xe4\x47\xdc\
\x7b\xfd\x1d\xaa\xaa\xa2\x5e\x09\xbe\xfd\x17\xdf\xe5\xc1\x9e\x41\
\x2c\x2b\xea\xe6\x9c\x97\x76\x49\xb1\x7f\x97\xc1\xc1\x6d\x10\xaa\
\xe3\xaa\x7c\x6a\x69\x0e\x42\xa0\x52\x80\xce\xf3\x58\x93\xb8\x2d\
\x0d\x96\x31\x4d\x34\xd2\x64\x2c\x6d\x0a\x14\x79\x28\xbf\xe9\xbf\
\x17\xb2\x4b\xcf\xac\x8b\x51\x3f\xe0\x70\xde\x26\xb4\x20\x74\xb0\
\x73\x5b\x7f\x76\xda\x3c\xef\x23\xf1\x7b\x43\xe0\xba\xd5\xe2\x90\
\x80\x9c\x4d\xbb\xb2\x4b\x8a\x06\xdf\x35\x7a\xb5\x86\xdb\x34\x06\
\xdb\x98\x14\x0d\x53\xed\xe3\x3c\x12\x90\x7a\x03\x4a\x09\x24\xd6\
\x19\x34\xa9\x7e\xa8\x9a\x86\xd9\x7c\xc6\x78\x3c\x89\x39\x60\xf2\
\x02\x2e\xe1\xd0\xfd\x5e\x7f\x63\x1c\x4a\x47\xbe\x43\x6b\x02\x09\
\xa7\x56\x1b\xd9\xc3\xf6\x84\x89\x16\xd6\xf5\x3e\x31\xb9\x45\xde\
\x89\xd8\xa4\x12\x34\x29\xd5\x91\x52\x45\x03\x95\x9e\x10\x44\x17\
\x11\x94\x4a\xea\xd4\x54\xc3\xac\x57\x2b\xb2\xa2\x24\x13\x5b\xec\
\xbe\xc8\x22\xb4\xa8\x45\xd7\x8e\x2b\x93\x64\x20\xa4\xba\xa4\x8d\
\x24\x99\x52\xfc\xc6\x3f\xfb\xbf\xf8\xce\xef\xfd\x36\x59\x51\xc4\
\xee\x32\x61\xd9\x3f\x3e\xe0\xed\x2f\xbc\xc9\xcf\x7e\xfd\xeb\x54\
\xd5\x82\xa2\xec\x53\xaf\x2b\xe6\x42\x31\x9b\xce\x52\x0b\x40\x2c\
\x2c\xb3\x4c\x50\xaf\x0d\x55\x55\x53\xad\x1d\xa3\xc9\x1e\xc6\xc1\
\xe5\xd9\x05\xbd\x32\xa7\x2c\x7b\x2c\x57\x2b\x8e\x4f\x8e\x68\x8c\
\x25\x04\x58\xaf\x96\xcc\xaf\xa7\x2c\xf6\x96\x64\x99\xe2\xf5\x2f\
\x7c\x95\xe5\x62\xc1\x6a\xb5\x62\x31\x9b\x33\x18\x0e\x78\xf6\xf8\
\x13\xb4\x56\x98\xa6\x61\x3c\x1e\x70\x70\x78\xcc\xed\x7b\x0f\xf8\
\xe0\x07\x3f\x60\x67\x67\x42\x96\x97\x2c\xd7\x0d\x2a\xcf\xc8\xfa\
\x03\x94\x00\xa9\x33\x6c\xf0\x1c\xde\xba\xc7\x7c\x3e\x65\x34\x39\
\xc4\xd6\x2b\x9c\x59\x70\xe7\xce\x5b\xbc\x7a\x31\x61\x39\xbd\xe0\
\xf6\x6b\xaf\xf3\xff\xfd\xf3\x6f\x32\x96\x53\xee\xde\xbd\xc3\xea\
\xfa\x02\x57\xd7\x70\xfe\x63\x5e\x3d\xf9\x80\x95\xc9\xd8\xbb\xf7\
\x26\xd6\xc3\xf1\xdb\x5f\x49\x6d\xd5\x22\x79\xf4\x08\x88\xc4\x54\
\x2c\xfe\xb4\xa9\x51\x54\x08\xc7\xe8\x11\x7f\x97\xdf\xa8\x45\x09\
\x01\x21\xd9\xc8\xd4\x13\x6a\x14\x42\x44\xf2\x64\x00\xd9\xca\xfb\
\x8d\xc1\x07\x07\x5a\x7c\x6e\x1a\x8c\xed\x58\xfd\x96\xd7\xd8\x20\
\x52\x11\x84\x69\xf9\x30\xd7\x1a\x61\xd2\x7e\xb5\xa0\x4c\x8b\xa4\
\xc6\x62\x9e\x24\x90\xd5\x9d\xfc\x48\x84\x80\x35\x36\xca\x5f\xca\
\x02\x91\xba\x3b\x75\x8b\x50\x14\x45\xc9\x60\x30\x8a\xf4\xbe\x52\
\x11\xb1\xca\xb3\x9b\x8a\xd2\x4e\xba\x91\xc6\xd6\x24\x84\xa0\x49\
\x1e\x25\x36\xe4\x8b\x1b\x1c\x8a\x48\x23\x66\x36\xe3\x5e\x6e\xa2\
\x0a\x71\xd1\x42\x87\x6c\x78\x17\xc3\x60\x94\xa7\xb4\x3d\x27\x32\
\xca\x17\xbc\x67\xd0\x1f\x26\x11\x1a\xa9\x98\xd3\x37\x8c\xb2\xeb\
\x2b\x57\x32\x16\xf2\x3e\xf2\x33\x5a\x6a\x4c\x53\xf3\xbb\xbf\xf5\
\x7f\xf3\xaf\x7e\xeb\x9f\xd3\xcb\x04\x65\xd0\xec\x1d\x4d\xf8\xfa\
\x2f\x7c\x8d\xbb\x0f\xde\x62\x30\x18\x70\x72\xeb\x98\x0f\x7f\x7c\
\x45\xa6\x1a\xac\x35\x2c\x67\x0b\x86\xa3\x1d\xae\xaf\xa7\xd4\xf5\
\x15\x52\x2f\x10\xc1\xf1\xec\xf1\x33\x32\x2d\xd9\xd9\x9d\xb0\xbb\
\xbb\x47\x6d\x2c\xe3\xd1\x88\xeb\xb3\x97\xb8\x62\xc5\xee\xf1\x31\
\x2a\x2f\x79\xf2\xf8\x11\xa3\x71\xc5\x78\xd4\xe3\xcd\xb7\xdf\xe0\
\x7a\xba\x20\xf4\x0a\xf6\x8f\x87\x2c\xa7\x57\x08\x21\x31\x4d\xc3\
\xa7\x1f\x3d\x23\x93\x8e\xa3\xd7\x1e\x12\xbc\xa5\x69\x2c\xd3\xd9\
\x1c\x6b\x3d\xc7\xb7\xef\xa0\xb3\x8c\xe5\x62\x45\x2f\xc0\x68\xd4\
\x67\xb2\xb7\xc7\xf3\xa7\x4f\xb8\x3c\x3f\xa3\xdf\x1f\xb0\x7b\x74\
\x8b\xb1\xde\xe3\xe3\x0f\xde\xc7\x35\x15\x83\x61\x86\x10\x9e\x5f\
\x48\xf7\x54\x52\x00\x00\x20\x00\x49\x44\x41\x54\xfa\x6b\xbf\xc0\
\xe9\x65\xc5\x0f\xfe\xec\x2f\xa8\x5f\x3d\xe6\x6f\xfd\xe7\xff\x19\
\xeb\xe9\x13\xf6\x27\x19\x79\x3e\xe4\xea\xf9\x73\xcc\xea\x8a\xe0\
\xd6\x3c\xfd\xcb\xdf\x67\x66\x24\x9f\xbc\xff\x43\x4e\xde\xf9\x32\
\x7b\xa3\x3e\xcb\xb5\xe5\x6a\x76\xcd\x17\x7f\xf6\xeb\x08\x22\x04\
\xaa\x95\x4e\x83\x2b\x22\xcc\x5b\xd7\x2b\xb4\xce\x31\xa6\x4e\x43\
\x1a\x22\x02\x16\xcf\xc1\x06\x90\xe9\x24\x36\x24\x81\xa0\x90\x9d\
\x13\x35\x4d\xd3\xe5\xfd\x91\xf3\xb0\xa9\xff\x3c\x74\xd1\x87\xad\
\x4e\xd3\x6e\xc2\x8d\xf7\xac\xd7\x6b\xb4\xca\x36\xe9\xb3\x6b\x50\
\xb2\x48\xaa\x6c\x4f\x63\x9a\x2e\xb3\xe9\x7e\xbc\xa7\x6e\x9a\xd8\
\x03\xa3\x74\x57\xe0\xf7\xcb\x12\x10\x29\x9d\xcc\x62\xcb\xad\x4c\
\x85\x6b\x3c\x84\xb1\x57\x21\xcf\x73\xa4\x52\x34\x75\x73\x03\x4d\
\x52\x4a\xc5\x37\xcb\x08\xab\x46\xdd\x54\x64\x58\x73\x1d\x53\xa2\
\x36\x74\xa9\xd4\x43\x12\x52\x94\xb2\xd6\x44\x02\x30\xd3\x5d\xf8\
\xac\xeb\x0a\xdd\xe2\xd8\x51\x5e\x8c\x31\x69\x88\x43\x2a\xd0\x62\
\xe1\xef\xbb\x89\x26\x6d\x97\x99\x10\x80\x54\xb1\xe3\xd1\x36\x34\
\x75\x44\x20\x74\x1e\x17\xeb\xf4\xd1\x8f\xf9\xfd\xdf\xfe\x67\xf4\
\x0f\x8f\x99\xec\xed\xe1\x82\xe0\xf7\x7f\xe7\xff\x65\xd8\x2f\x38\
\x39\xdc\xe5\x8b\x5f\x7a\xc8\x3b\x6f\x3f\x20\xeb\x8d\x40\x42\xde\
\x2b\x79\xfe\xfc\x29\xf5\xe2\x1a\xe9\x63\x4e\xef\xad\x65\xef\xf0\
\x88\xac\x18\xe1\x6c\x4d\xb3\x5e\xb2\xbb\xb7\xcf\xd1\xad\x93\xb4\
\xe8\x8e\xf9\x6c\x16\x61\x53\x40\x04\xc7\xec\xfa\x0a\x2f\x40\x15\
\x7d\x04\x82\xc5\x6c\xc6\x72\x7a\x1d\xe5\x29\x75\x0d\x75\xce\x67\
\xcb\x6b\x9c\x75\x3c\xfa\xd1\x07\xf4\xc7\x3b\xbc\xf9\xa5\xf7\x08\
\xa6\x61\xb9\x58\x12\x02\xbc\x78\xfe\x9c\xb2\x3f\x40\x89\xc0\xe9\
\xcb\xe7\xa8\xac\xe0\xf6\x6b\xaf\x71\xfe\xfc\x29\x2f\x9f\x9c\x72\
\x75\xfa\x82\x9d\xfd\x23\xca\xb2\x47\xaf\x3f\xe0\xe2\xec\x8c\x41\
\xaf\x4f\x91\x17\x88\x5c\xd3\x1f\x0e\x59\x57\x8e\xd9\xec\x94\x97\
\xcf\xa7\xbc\xff\x67\xdf\xe3\xce\xf1\x21\xcf\x1f\x3d\x66\xb5\x3c\
\x65\xa4\x2b\x26\x27\x7b\xd8\xfc\x08\x3d\xea\x33\x28\x05\x36\x97\
\xc8\x8b\x17\xa0\x0a\x2e\x1e\x3d\xe5\x93\xca\x70\x70\x7b\x9f\xbd\
\xe3\x1d\x66\x97\x2f\xe9\x0f\x86\x78\x07\x4a\x65\x64\x59\x46\x55\
\xad\x91\x44\xe8\x5d\x2b\x0d\x59\x6c\x7a\xd6\x72\x33\x77\x6b\x1b\
\x56\x6f\x1d\x59\x9e\x95\xf1\xe0\x93\xc6\x3c\x39\xd7\x29\x70\xf3\
\x3c\xef\x0e\xb3\xd4\x2a\x8d\xf9\xd9\x6e\xb0\x12\xdd\xcc\xac\xb6\
\x05\x23\x24\x88\xd8\x59\x83\xf5\x06\x25\x75\x6a\x1e\x6b\xd5\x08\
\x9b\xd9\x02\x79\x96\x77\x04\xb5\x4e\xa4\xb1\xb3\x66\xd3\x33\xe4\
\xd3\x20\x8c\xc4\xa7\xe8\x10\xc0\xa6\x6e\x36\x02\x49\x88\x96\x78\
\x84\xaa\xa6\xdf\xef\x6d\x9a\xe9\xb7\xc6\xe1\x6c\xf7\xa0\x8b\xb6\
\xf5\xb6\xed\xa3\xd8\xca\x13\xb7\xfb\x2c\x5a\x92\xd1\xb7\xa2\x47\
\xef\xc9\x8b\x32\x49\x4b\x6c\x6c\x2f\x4d\x8c\xa8\x48\x11\x65\xbb\
\x95\xb4\x1d\x1a\xd7\x7e\x9e\x09\x1e\xbc\x40\x15\x3a\xf5\x8c\xeb\
\x6e\x2c\x91\xb5\x16\x63\x3d\x3f\xfd\xe0\x03\xae\xbe\xf3\x3d\x9a\
\xa6\x46\x67\x0a\xeb\x3c\xef\xbe\x7d\x9f\x9f\xff\xfa\x3b\x1c\xed\
\xef\x21\x95\x20\x2b\x0b\x46\x93\x11\x8b\xf5\x8a\x17\x8f\x9f\xd1\
\xef\xf7\xb0\xd6\x70\x70\x72\x80\xf7\xad\x32\x36\x63\x5e\xad\xd9\
\xd9\xdd\xc3\x79\xc7\xfc\xea\x2a\x86\x6c\xa5\xa2\xde\x48\x68\x2c\
\x9a\xd9\x62\x89\xaf\x0c\x45\x9e\x51\x57\x0d\xce\x44\x16\xdb\x1a\
\x4b\x53\x57\x8c\x06\x7d\xb2\x3c\x27\x1f\x4d\xc8\xb4\xe4\x97\xee\
\x3d\xc0\xd4\x6b\x5e\x3e\x7f\x19\x49\xc4\x6a\x41\x53\x57\x8c\x7b\
\x45\x04\xe6\x84\xe4\xd6\xbd\xfb\x51\xfd\xba\xae\x68\x8c\x63\xb5\
\xaa\xd9\xd9\x8f\x11\x6a\xb4\x7b\x40\x53\xaf\x59\x2f\x16\xf4\x8a\
\x9c\xf1\xee\x2e\x42\x66\x9c\xbd\x7c\x46\xd1\x1b\xe0\x1c\x7c\xff\
\x4f\xfe\x08\xe1\x1a\x4e\x5f\x5d\xf0\xf4\x77\xbf\xc9\x72\xb9\xe4\
\x8d\xd7\xef\xd0\xff\xc9\x2b\x64\x50\x8c\x0e\x0e\x71\x0e\x06\x45\
\x9f\x79\xc8\xd8\xe9\xf7\xa9\x8d\x67\x38\xc9\x59\x9c\x9e\x32\xad\
\xe7\x54\xaf\xce\x19\x9f\x1c\x91\xef\xec\x22\x71\xa8\xac\x8c\xca\
\x5e\xb1\x19\xdc\x80\x50\xc4\x19\x3a\xe2\x46\x3f\xcb\x36\xbf\xb0\
\x89\xf4\x91\xbb\x6a\x11\xad\x56\x81\xb0\x5a\xaf\x91\x4a\x92\xeb\
\xac\x53\x10\x3b\xef\x90\x4a\x76\x08\x6a\x5b\x57\x8a\xd4\x35\xda\
\x36\xab\x99\x10\x90\xe1\xa6\xca\x38\xd6\x1e\x8a\xba\xaa\xf0\xce\
\x51\xfb\xf5\x56\x4d\xea\x37\x6a\xed\xe4\xb8\xbb\xbe\x7e\xe7\x59\
\x55\x2b\xb4\x90\x02\x9d\x8a\x9f\xc6\x3a\x32\x0d\x4a\x80\x20\xf6\
\x01\x07\x44\xa7\xc3\x0f\x01\x54\xca\x21\xa3\x86\xdf\xa3\xb3\xac\
\xeb\x8e\x0b\xb4\xa4\xdc\x46\x8c\x27\xdb\xa9\x27\xb4\xfd\x09\x02\
\x67\x02\x26\x29\x4c\x5b\xf4\x62\xd3\x32\x29\x36\x90\x9f\x14\xdd\
\xfc\xa4\x36\x75\xf2\xde\x93\x6b\x1d\x19\x56\xa9\x3a\x79\x79\x9c\
\x74\x12\x0d\x26\xd3\x8a\xc6\xac\xd1\xc2\x72\x7c\x38\xe1\xf4\xd1\
\x33\x26\x93\x11\xd6\x79\xfa\x25\xfc\x5b\x3f\xfb\x0e\x45\x9e\x73\
\x35\x9d\xd3\x2f\x73\x96\x8b\x15\x8b\xd9\x15\x55\x03\xfd\x7e\x89\
\x59\xaf\x58\x2d\x67\x58\xd3\x50\x96\x39\xe7\x67\x2f\xf1\xb2\xc4\
\xf9\xc0\x60\x67\x8c\xb7\x01\xa4\xe6\xee\x9b\x0f\xc8\xb2\x82\xe7\
\x8f\x1f\x33\x1a\xf6\xb1\xd6\xd3\x7f\xed\x75\xa6\xe7\xcf\x59\xcc\
\xa6\xbc\xf1\xc5\x9f\xa1\x09\x92\xe9\xf5\x35\x79\x9e\xb1\x7b\xef\
\x5e\x8a\xba\x82\xba\x69\x38\x38\xb9\xc3\xcb\xa7\x8f\xc9\xb3\x9c\
\xbd\x83\x43\xae\x2f\x2e\xb0\x0e\x56\x8b\x25\x83\xe1\x88\x3c\xf3\
\x0c\x86\xe3\x38\xf4\x01\xc9\xe5\xd5\x25\xeb\xaa\xa1\x9c\x1c\xf2\
\xe2\xd5\x19\xfd\x79\xac\x5f\xca\x5e\x86\x96\x81\xe5\x72\x8d\xf1\
\x82\x9d\xbd\x21\xc7\xaf\x3d\xc4\x35\x15\xff\xf2\x37\xbf\x49\x7d\
\x75\xc5\x62\x31\x47\x00\xb5\xf7\x58\x1f\xf8\xc9\x67\x67\xec\x4c\
\x46\x34\x75\xc5\x97\x77\xc7\x98\xb5\xe1\xf8\xa8\xc7\x83\x7b\x03\
\xca\x7e\xc6\xe3\x47\xcf\xb8\x7d\xf7\x4d\x5e\x3d\xad\x98\x9d\x5d\
\x31\x3c\xd8\x45\x2e\x2e\xb8\x58\x54\xbc\xf5\xe5\x2f\x13\x82\x25\
\x53\x03\x66\x8b\xe5\x06\x5a\x15\xe0\xd2\x4c\x81\xa2\x28\x62\x8d\
\x98\x00\x9d\x38\x89\x44\x76\x3a\x3c\xc9\xa6\x7f\x9e\x10\x55\x14\
\xd6\x27\xc5\x37\x20\x52\x54\x68\x91\xca\xe0\x40\xaa\xac\x6b\xa6\
\x6a\xd2\xf0\x3f\x90\x20\x36\x52\x21\x8b\xec\x26\x28\x42\x48\x02\
\xd0\x48\x52\x2a\xad\x63\xeb\x84\xce\xf0\xce\x26\x80\x29\x7e\x5f\
\xdb\xef\xd2\xce\x16\x6b\xc7\x55\xa9\xff\xea\x57\x7f\xed\x1b\xde\
\x43\x55\x57\x54\xeb\xaa\x6b\xdb\xdc\x8c\xcf\x14\x29\x5d\x92\x68\
\xad\x3a\xa9\x80\x6c\x87\x7f\xa5\xa2\xbd\x15\x02\xfa\xe0\x23\xae\
\x8f\x60\xb5\x5e\x20\x84\xea\xe4\x03\x5d\x87\x9b\x90\x5d\xdf\x88\
\x4f\x24\x9f\x4e\xf3\xb4\x62\x7e\xe8\x22\x3f\x92\xf4\x38\x1b\xe4\
\x4b\xc5\x29\x18\x4a\xe1\xbc\x4b\x43\xdf\xdc\x56\x2f\xb6\x40\x2b\
\xc9\xd5\xcb\xe7\xfc\xe5\xbf\xfa\x2d\x3e\xf8\xfe\x0f\xf9\xf8\xd1\
\x4f\x59\xac\x2b\x16\x8b\x05\xab\xc5\x82\x77\xdf\xbc\xcd\xeb\x6f\
\xbc\x46\xdd\x58\x6e\x1f\x1f\x70\x75\x3d\x23\xcb\x32\x16\xf3\x75\
\x34\x58\x1c\xaf\x5e\x9d\xb3\x33\x9e\x90\xe7\x92\x65\xe5\x50\x59\
\x9f\xe1\x70\x88\x10\x8a\xfe\x68\x98\xd2\xcc\x86\xe0\x2d\xa3\xf1\
\x24\x0e\x14\xc8\x0b\xb4\x96\x2c\xe6\x57\x28\x3c\x77\xef\xdf\xe7\
\xf4\xe5\x29\xd3\xe9\x02\x9c\x65\x7e\x75\xc9\xce\xfe\x3e\xb3\xe9\
\x15\xfd\x7e\x9f\x83\xa3\x03\xd6\x8b\x05\x07\xc7\xc7\x10\x02\x8f\
\x1f\x3d\xa2\x59\xcd\xd0\x0a\x46\x7b\x07\x2c\xe6\x0b\xce\x5f\x3c\
\x41\xe9\x8c\xd1\xee\x3e\xfd\xc1\x0e\x99\xce\x62\x1a\x6c\x1c\xa7\
\xcf\x5f\x20\x83\xe7\xec\xd9\xa7\x2c\x2f\x4e\xb9\xf3\xe6\x7b\x64\
\x45\x0f\x6b\x3d\xd3\x8b\x0b\x66\xd3\x6b\x32\x9d\xf1\xc1\xb7\xbf\
\xcf\xc5\xab\xe7\x20\x04\xab\xba\xa1\x1c\xf4\x98\x57\x0d\x4b\x63\
\xd9\x1d\x69\x5e\xbf\x77\xc0\xfc\xfc\x05\x7b\xbb\x23\x74\x06\xaf\
\xbf\xf7\x06\xcd\xfa\x0a\xcd\x92\x93\xfb\xf7\x28\x74\x84\x67\xa7\
\xaf\x9e\x62\x9b\x35\xd2\x59\xc2\xe8\x80\xe3\x5b\x47\xe4\xc1\x81\
\xca\x68\xea\x66\xc3\x69\xb4\x64\x6b\x88\xed\xb4\x71\x06\x41\x64\
\x96\xfd\xd6\xe4\xc6\xb6\x5e\x68\x15\x1a\x71\x0e\x80\xa0\xc8\xb2\
\xd4\xb0\x45\x37\x2a\x4a\x48\x99\x06\x7d\xa8\x6e\x84\xa8\x4c\x24\
\x75\x14\x9c\x46\xe8\xb8\x9d\xa3\x15\xeb\x63\xd1\x11\xca\x91\xb0\
\x8c\x33\x04\x48\x5d\x8c\x61\xbb\x57\xbf\x1d\x44\x27\x64\xa7\xba\
\xf0\x3e\x3a\x70\x2d\x44\x6c\x82\xdc\x8c\x8c\x09\x9f\x9b\xbd\x1a\
\x7b\x18\x7c\x68\x9b\x9f\x36\x18\x74\xd8\x6a\x3d\x6f\x61\xb4\x4e\
\x8e\x0d\x0c\x87\x3b\x18\xbb\x91\x82\x74\xe1\x36\xf5\x37\x0b\xe2\
\x80\x06\x9f\x16\x4f\xcb\xa8\xbd\x69\x19\x7a\xd9\x4d\x4b\xf1\x5b\
\x7d\x26\xa2\xeb\x45\x91\xa9\x51\x46\xa6\x89\x20\xc1\x3b\x5e\x3c\
\xfa\x80\xdf\xfb\xf5\x7f\xc8\x48\x2d\xf9\xc1\xe3\x39\x17\xd3\x39\
\x02\xcf\xad\xc9\x80\x8b\x95\xe1\xce\x9d\x23\xa8\x97\x1c\x1d\x1e\
\x32\x3d\x7b\x85\x5f\xad\x39\x5f\x58\xf6\x26\x43\x66\xf3\x05\x79\
\x19\x87\xd7\x05\x21\x98\x4e\x17\x1c\xdc\x79\x80\x92\x9a\xe7\xcf\
\x5e\xa2\x94\xe4\xe2\xd5\x2b\x0e\x0e\x8f\x28\xfb\x43\x3e\xfd\xf0\
\x23\x8a\xde\x88\xe7\x4f\x9e\x76\x73\x64\xf3\x7c\xc8\x6c\x65\x29\
\x77\x6f\x93\xaf\x1c\x7b\xc3\x21\xb3\xab\x4b\x8e\xee\xdc\x21\xcb\
\x73\x26\xbb\x63\x86\xc3\x1e\xfd\x7e\x49\x53\x35\x5c\x5d\x4e\xe9\
\x95\x05\x0f\xdf\xfb\x22\x79\x51\xb2\x5e\x2c\xb8\xba\x38\xe7\xde\
\xfd\xd7\x78\xf1\x3c\xe3\xfa\xfc\x94\xd3\x27\x9f\xf2\xce\x57\xff\
\x9d\x84\x20\x79\xf6\x6f\xdd\x66\x5d\xc7\x9e\x85\xc3\x7b\x5f\xa0\
\x57\x6a\x66\xb3\x25\x21\x2c\xa9\xab\x35\xcf\x3f\xfb\x84\x9d\xdd\
\x3d\xa6\x2f\xaf\x59\xcf\xae\x50\x99\x66\x5d\x55\xd4\x1e\xae\x5e\
\x9e\x62\x89\xad\xab\x5f\x7d\x63\x8f\xc9\x30\xc7\xcd\x14\x79\xa1\
\xb9\x73\xef\x21\x57\x2f\x5e\xb2\x7b\xfc\x80\xc1\xce\x1e\xb6\xa9\
\x99\x9c\xec\x91\xf5\x6a\xaa\xd5\x0c\xd3\x54\xf8\xfa\x8a\xfa\xd9\
\x0b\xbe\x7b\xfe\x8a\x2f\x7e\xe5\x2b\xdc\x3e\x18\x01\x8a\xcb\xcb\
\x73\x84\x04\x17\xc4\x0d\xd2\xae\xae\xeb\x38\x14\x24\xed\x65\x55\
\x47\xb1\xa6\x92\x9b\xae\xc5\x3c\xcf\xa8\x2b\x13\x21\x64\x25\x22\
\xf2\x48\x12\x25\xca\xe8\x48\x5b\x02\xdb\x87\x98\xa2\x3b\x1b\x35\
\x7b\x79\x51\x20\xa5\xfe\xdc\x9c\x02\x81\x94\x20\xa4\xee\xe6\x34\
\x37\x4d\x15\x6b\x63\x19\x47\xbe\xb6\xa3\x64\xdb\x2e\xd6\xb6\x7d\
\xc3\x79\x8f\xca\x32\x70\x11\x5e\x56\xff\xe5\xdf\xf9\xc6\x37\xa4\
\x80\xda\x18\x66\xb3\x45\x94\x51\xb7\x4d\x49\x37\xe4\x1e\xdc\x18\
\x02\x10\x65\x24\xba\x9b\x66\x78\x43\x32\x4d\xc0\xda\xd8\xfc\xd4\
\x4a\x3c\xb6\x99\x53\x9b\x06\x74\xa9\x56\xb3\xd2\xf6\x34\x77\xca\
\x5f\x6e\x30\xa2\xdd\xdf\x44\x9c\xbc\xe2\x7c\x84\x6b\x5d\x9a\x99\
\x9b\x69\xc5\xf9\xcb\xa7\xfc\xe9\xef\xfe\x3f\x7c\xf0\x7b\xff\x84\
\x5b\xfb\x03\x1e\xbf\x9c\xf1\xec\x74\xca\xc1\x64\x82\x6d\x2a\xf0\
\x8e\x41\x3f\x67\x32\xea\xf3\xda\xeb\x0f\x59\xac\x0d\xf4\xf6\xd1\
\xe3\x43\xca\x5e\xc6\xa0\x27\x29\x72\x45\xaf\x57\x72\x79\x76\xb1\
\x49\x0f\x42\x43\x7f\xd8\xe3\xd6\xfd\x07\x0c\x06\x7d\xfa\xc3\x3e\
\x41\x48\xf6\x0f\x8f\xf1\xde\xd2\x1f\x0c\xd8\x3b\x3a\xa4\xa9\x6b\
\x72\xad\x19\x8e\x47\xac\x17\x73\x5c\xf0\x54\xab\x05\xce\x59\x8a\
\x5c\x32\x1c\xe6\x3c\xfe\xf8\x13\x02\x51\xfe\xb2\x5e\x55\x48\x25\
\x29\x7b\x7d\xc6\x93\x9d\x28\xe2\x74\x9e\xc5\x7c\x8e\xb5\x8e\xba\
\x36\x0c\x87\x23\xa6\x57\xd7\xec\xed\xef\x71\x71\xfa\x8a\xef\x7f\
\xfb\x3b\x64\x65\x8f\x17\x4f\x9f\x33\x18\xef\x72\xf2\xe0\x6d\xea\
\x6a\xc5\x62\x76\x89\xd6\x9a\xb3\x67\x4f\x79\xf6\xf1\x47\x7c\xfd\
\x97\xff\x1a\x93\xbd\x63\x2e\x4e\x4f\x59\x2f\xae\x39\x3f\xbf\xe4\
\xd6\xed\x23\xb4\xf6\x5c\x4d\xd7\x2c\xaa\x8a\xfd\xdd\x01\xbf\xf8\
\xd5\x37\xd8\x1b\x95\x0c\x77\x72\xee\xbd\xfd\x36\x4a\xc1\xc9\xfd\
\xb7\xf0\xce\x90\x15\x23\xae\x5e\x7c\xc6\xe2\x6a\xca\x4f\xbf\xfb\
\x6d\x82\x5f\x71\xe7\xad\xf7\x98\xec\x8d\xb1\xab\x33\xd6\x0b\xc3\
\x27\x1f\x7f\xca\xce\xee\x80\x77\x7e\xe6\x6b\x68\x5d\x70\x7d\x75\
\x75\x63\xbe\x6f\x2b\xdd\x90\x49\x27\x15\xda\xb1\xa5\xb4\xb3\x73\
\xe3\x18\x50\xd9\x4e\x6e\xcc\xb2\x8e\x53\x0b\x21\xb6\x33\x84\xee\
\x5d\x5b\x11\x28\xc4\xdf\x29\xa9\x12\x9a\x16\x6e\x0c\xde\x6e\x67\
\x18\xc4\x9e\x18\x9f\x8e\x57\x1c\x9e\x6d\x9b\x26\xcd\x13\xdb\xd4\
\x47\xc6\xb8\x4e\xa3\x26\xd3\xb8\x4a\x6f\xe3\xfb\xb4\x94\xe0\x5c\
\xa2\xe5\x89\xf8\xb1\xb3\x8e\xd1\x68\xd8\x19\x45\x6b\x34\x04\x8f\
\xf3\x31\x5f\xcc\x73\xb5\x51\x49\xa6\x50\xd5\x0d\x38\x16\x02\xa5\
\x33\x9a\xad\x91\x8f\xad\x24\x5e\x49\x19\xd5\xa5\x6d\x8d\xa2\xe4\
\x0d\xe2\xa9\x4d\xa5\xba\x09\xe3\xc6\x44\x6d\x55\xfa\x5d\x91\x6a\
\x8e\x56\xe7\xe3\x9d\xe3\xea\xec\x25\xff\xe6\xd7\xff\x7b\x98\xbf\
\x44\x4a\xcd\xbc\xb6\xfc\xf0\xb3\x33\x5c\x08\xac\x56\x33\x32\x25\
\x51\x59\x81\xad\x1d\x1f\xfd\xe8\x43\x9e\x7c\xf6\x9c\x46\x0a\x7a\
\x83\x01\x45\xd9\x63\x90\x05\x26\x07\xfb\xd4\xab\x35\x27\x47\x7b\
\xec\xee\xf6\xa9\x1a\xc3\x70\x34\x64\x3e\x9d\x62\x03\x64\xb3\x25\
\xc6\xc2\x6a\xb9\x24\x2f\x4a\xce\xcf\xae\xa8\x96\x4b\x96\x55\x8d\
\x92\x92\x5c\x07\x74\x31\x62\x3a\xbd\xe6\xf8\xce\x1d\x8a\x72\xc0\
\x68\xb4\xc3\x6c\x76\xc5\xf5\xf4\x0a\x17\x04\x6f\x7f\xe1\x4b\x3c\
\x7f\xf1\x8a\xe1\xee\x09\xeb\xe5\x0c\xa9\x15\x48\x12\xd3\x2b\xb8\
\x3a\x3b\x47\x8b\xc0\xde\xce\x88\x8b\x8b\x4b\x96\x55\x45\xae\x35\
\xeb\xca\x60\x6a\xc3\xdb\x5f\xf9\x39\x66\x17\x97\xec\x9f\x1c\x61\
\xea\x8a\x6a\x79\x4d\x9e\x49\x76\x77\x77\xc9\xca\x21\x57\x97\x73\
\xee\xbe\xf1\x16\x75\x55\x11\xf0\x9c\xbf\x3a\x23\x97\x9e\x32\xd7\
\x3c\x7a\xf4\x09\xb5\xf5\x04\xa9\x29\x10\x7c\xe5\xdd\x87\x1c\xee\
\xf6\x39\x3a\x39\xe6\xe2\xfa\x92\xb3\xe7\x9f\xe2\xeb\x6b\xa6\x9f\
\xfd\x31\xd2\x69\x56\x76\xc2\xfc\xea\x8c\xe5\xec\x9a\xe5\xf9\x2b\
\x9a\x6a\xcd\x6a\xbe\x62\x74\x7c\xc8\xd5\xab\x53\xde\xfc\xb9\x5f\
\xe1\xa3\x27\x53\x7e\xef\x37\x7e\x93\x5b\xaf\x3d\xe0\xe1\x1b\x0f\
\xb1\xce\xf1\xc9\x47\x1f\x92\xe5\x59\x97\x51\x68\x1d\x01\x94\xd6\
\xa9\x4a\xbd\x69\x78\x93\x22\x1a\x4d\x9d\xd0\xc7\x40\x52\x4a\x64\
\x1a\x2d\x0b\x68\x9f\x18\xd0\x18\xb2\x3c\x8e\xa2\xed\xa6\x3a\xea\
\x9b\x53\xf8\xdb\x96\x87\xed\x99\x06\x51\x62\xe2\xe3\x2c\xb6\x34\
\x37\xc0\xfa\x78\xc6\xad\x75\xdd\x1c\xb5\x96\x3d\xdf\xce\x70\x94\
\x52\x34\xd6\x44\x98\x57\x24\x4f\x2e\x02\x1d\x7e\x2d\x3b\x1d\xbe\
\xda\x0a\x41\xa0\xd2\x88\xcd\x76\x30\xb4\x6a\x79\x92\x94\x7f\x76\
\x38\x73\x32\x9e\xb6\xb1\xbf\x25\x69\xda\x34\x6d\x5b\x42\x72\x73\
\xc6\x52\xe8\x16\xb7\xaa\x2b\x06\x83\x61\xd7\xf7\x1d\x12\xda\x55\
\xe6\xba\x93\x28\xd7\xb3\x6b\xbe\xf9\xbf\xfe\x77\x94\x76\xca\xc2\
\x1a\x96\x8b\x15\x2f\x9e\x4f\x29\xcb\x0c\x67\x0c\xb7\x8e\xf6\xe8\
\x2b\xc1\xe5\x6a\x8d\x35\x9a\xab\xe5\x92\x30\xbf\x8e\xad\xbf\xe1\
\x1a\xad\x05\xd2\x59\x6a\x13\x98\x8c\xfa\xfc\xc0\x1a\xaa\xda\x10\
\x10\xec\xef\x0e\x59\xac\x1a\xc6\xc3\x9c\xd7\xee\xdf\xe3\x27\x1f\
\x7e\x8a\xf1\x11\xc4\xc8\xb5\x20\xcf\xb3\x38\x54\x5a\x67\x54\xd6\
\x62\x9a\xc8\x32\xf7\x47\x3d\x0e\x6f\xdd\xa6\x3f\x1e\x33\x1e\x8f\
\xb9\x3a\x3f\xe5\xf6\x6b\x47\x5c\x5f\x5d\xd3\xac\x97\xa8\x50\x93\
\xe5\x05\x56\x4b\x82\x17\xac\x8c\x65\xb9\x58\xb1\x5e\xce\x59\x9e\
\xbd\xe0\xc1\x1b\x6f\x72\x72\xfb\x0e\xb3\xe9\x94\xc1\xce\x1e\x45\
\xd9\xa3\x5a\x2e\x99\x5d\x9e\x13\x9c\xa1\xaf\x1c\x3b\x07\x3b\x5c\
\xce\x2f\x69\xd6\x0d\x79\x51\xb0\x9c\x5d\xd3\xac\x17\x9c\xbc\xf3\
\x06\x45\x5e\xf2\xd1\x0f\x7e\xcc\xfa\xf4\x31\xaf\xbf\x79\x1f\x73\
\x75\xc1\xb0\x7f\xc0\xab\x57\x57\xac\xac\xa3\x09\x96\x51\x16\xef\
\x5b\xe5\x05\xc7\x77\xee\xf0\xd1\x4f\x3f\xa5\x28\xf6\xa8\xab\x33\
\x7c\x35\x45\xfb\x2b\x7a\xfd\x21\x4d\x5d\xf2\xee\xbf\xfb\x37\x78\
\xfe\xf1\x29\xcf\x7f\xfc\xfb\x7c\xfc\x93\x47\x2c\x4c\xe0\xb2\xca\
\xf8\x85\xff\xf0\x6f\xf1\xed\x3f\x59\xf0\xa7\x7f\xf0\x87\xfc\xca\
\x7f\xfc\x37\x79\xeb\x9d\xf7\x18\x8f\x77\xb8\x78\xf5\x9c\xb3\xf3\
\xb3\xbf\xc2\x78\x6f\x4f\xb7\x6c\xd9\x6d\x63\x2c\x59\x9a\xb4\x12\
\x70\x49\x6f\x45\xd7\x18\x25\xa4\x8e\xa8\x55\xca\x5e\xc2\x8d\xd9\
\xc9\x8a\xa2\xec\xc5\x89\x2e\x4a\x75\x6d\x0d\x9d\xac\xc4\x6f\x1e\
\x69\x61\x4c\xe4\x3c\xa4\xd6\xa8\xe0\x6f\x0c\xee\x8e\xc3\x00\x33\
\xb2\x34\xab\xb7\x95\xb2\x18\x6b\x63\x0d\xd2\x76\xdd\x49\x29\xc8\
\x95\x4e\x18\x73\x9c\x04\xb9\x3d\x88\xa1\x1d\xc9\xd9\x0e\x16\x88\
\x43\x84\x23\x5f\xa1\xda\xae\x3f\x29\x59\x57\xd5\x66\xc6\x11\x32\
\x75\x9f\x65\x37\xb4\xf9\xdb\xd0\x5f\x9b\xb3\x76\x73\xb0\x92\x77\
\xc8\x8b\x1e\x21\x29\x79\x45\x9a\x05\x6c\x8c\x89\xe3\x39\x4d\xc5\
\x0f\xfe\xf4\x8f\xf9\xe1\xbf\xf9\x1d\xae\x9e\xfc\x94\x7e\x09\xcf\
\xa6\x6b\x84\xd0\xd4\x0e\xee\x1d\x8e\x98\x2f\xd6\xbc\x78\xf5\x8a\
\x50\xd7\xe8\xde\x90\xeb\xc5\x8a\xc9\xee\x84\x51\xae\x58\xad\x2a\
\x9c\x0b\x18\x13\xd8\x1f\xe6\x84\x65\x0c\xbf\xc6\x85\xf4\xec\x88\
\x88\x0a\x1d\x1f\x4e\x38\xbf\x98\xf1\xd1\x07\x8f\x28\xf2\x9c\x71\
\xbf\x17\x75\x66\x75\xc5\x6a\x76\x8d\xf3\x70\x70\xf7\x98\x7c\x5e\
\x61\x74\xc6\x68\x38\xa2\x1c\xf6\x39\x7d\x71\x4a\x75\x71\xc1\x7a\
\x58\xe2\xad\xe7\xa3\x17\xa7\x54\x4d\x1d\xf3\x78\x67\xf1\x41\xb0\
\x77\x72\xc8\x7a\xb5\xc6\xa9\x9c\x9d\xbd\x03\x06\xe3\x21\x65\x3f\
\xc7\xc9\xcf\x38\xba\x75\x9b\xd5\xda\x20\xb3\x3e\xbb\x27\x87\x0c\
\x76\x76\x39\xba\xf7\x80\x17\x8f\x1f\x51\xd7\xab\x08\x32\xdc\xb9\
\xc3\xb3\xc7\x4f\x22\xfc\xae\x73\xca\xc1\x0e\xf3\x8b\x25\x73\xbf\
\xe4\xfd\x6f\xfd\x11\xa5\xf4\x7c\xf7\x5b\x7f\x4e\xae\x25\x57\xd3\
\x25\x22\xcd\xd3\xda\xd1\x92\x93\x9d\x1e\x7b\xf7\x1f\xe0\x70\xb8\
\xb3\xc7\x4c\x7a\x25\xaf\x4e\xcf\x71\xc6\xb2\x7f\xf4\x2e\xf5\xf2\
\x1a\x25\xa0\x70\x39\xab\x70\xc8\xd1\xd7\x7f\x19\x39\xd8\xc1\x7e\
\xfb\x77\xa8\xaf\xd6\xb8\xe5\x9c\xf5\x6a\xc9\x7b\x5f\xfa\x19\xde\
\xff\xde\x8f\x78\xf3\x0b\x8f\x78\xfb\x4b\x5f\xe3\xe8\xf8\x88\xbb\
\xf7\xee\x71\xf6\xfc\x29\x1f\xbe\xff\x7d\x1a\x1b\x3a\x4d\xd5\x66\
\x96\x96\xed\x9c\xe5\x86\xcd\xf6\x1b\x32\x99\x90\xc0\x17\x47\x5e\
\xe8\xae\xd0\x6e\x9b\xbb\x08\x01\x17\x1c\x42\xf8\xae\x6f\xbf\xad\
\x7d\xb7\xe7\xb2\xc9\x94\xf5\xc4\x51\xb7\x89\x66\x70\x80\x61\xf3\
\xe8\x0a\xa5\xc8\xd2\x40\x44\x97\x7a\x99\x5a\x5e\x70\x50\xf6\x50\
\x7f\xfb\xef\x7d\xe3\x1b\x04\xa8\x6a\xc3\xba\x5a\x47\x48\x2e\x75\
\xdc\xb5\x53\xb4\xb5\x8a\x85\x4d\xfb\xc5\x4d\x3b\xba\x47\xca\x76\
\x9c\x2a\x12\xb0\xde\xdc\xe8\xbd\x88\xc3\xb8\xe8\x58\xf6\xed\xde\
\x90\x16\x03\xb7\xc6\xe1\x83\xc7\x38\xdf\x21\x20\xdb\xb2\x82\x16\
\x55\x6b\x17\x52\x2b\xc9\xd3\x9f\xfe\x98\xff\xe9\xbf\xf9\x2f\x78\
\xf1\xdd\x7f\x4d\x5f\x1b\x76\xc6\x05\x99\x82\xe9\xda\x70\x71\xb5\
\xe0\x7a\xb6\x64\xb6\xa8\xd8\xe9\x69\xae\xa6\x73\x64\x08\xec\xf4\
\x35\xe3\x7e\xc9\xd9\xd9\x25\xae\x5a\xf2\x95\xb7\xef\x33\x9d\x57\
\x08\x53\xa1\x33\xc9\x6c\x69\xb0\x49\xa2\x1f\x52\x8b\xe6\xb0\x57\
\xe0\xbc\xa3\xcc\x33\xae\xa7\x33\x7c\xb3\xe2\xfe\xf1\x80\xd1\xa0\
\x60\x3d\x9b\xb3\x5c\x2c\xc9\xb4\x40\x07\x47\x55\xd7\x34\xeb\x39\
\x76\xb9\x64\x39\x5f\x72\xe7\xe4\x80\x71\x2f\xe3\xf2\xfc\x82\x7e\
\xa1\x18\xed\xee\x10\x9c\xa5\xc8\x32\xfa\x83\x58\xa4\xd7\x55\x03\
\xc6\x11\x9a\x06\xb3\x5c\x50\x2f\xae\x71\x55\xcd\xec\xf4\x94\x67\
\x1f\xfd\x94\x4f\xbf\xff\x5d\xbe\xf3\xad\x3f\xe4\xfa\xd5\x33\x1e\
\x7f\xf2\x31\x81\xc0\xee\xfe\x1e\xb7\xdf\x78\x9b\xfe\x60\x87\x6f\
\x7f\xeb\x0f\xb8\xba\xbc\xc4\x7b\xcb\x70\x67\x8f\xe3\xd7\x1e\x32\
\xbb\x38\xc7\x35\x4b\xca\xac\xe0\xc9\xa7\x8f\x99\xec\xef\x52\x8e\
\x77\x18\x4e\x46\x9c\x9d\x5e\xd0\xcf\x24\xc7\x7b\x63\xfe\xfa\x7f\
\xf2\x1f\xd1\xdb\x99\x50\xbb\x80\xaf\x67\x11\x85\xeb\x8f\x41\x66\
\xcc\x2e\x5f\xe2\xea\x35\xcd\xba\xe1\xd5\xd3\x28\x7c\x5c\x84\x09\
\x42\xf7\x38\x38\xdc\x45\x99\x6b\xae\xce\xce\x78\xf2\xf8\x09\x5f\
\xfa\xa5\xbf\x49\x59\x96\x9c\x9f\x3e\xa5\xd7\x13\x1c\x1c\x9f\x50\
\x9b\xc0\xce\xce\x10\x37\x7d\x89\x59\xcf\xa9\xfd\xe7\x86\xf6\x25\
\x19\xbb\xd8\x02\x5d\xda\x0c\x05\x88\x50\x6c\x5e\x90\x65\xf9\x0d\
\x4e\xcd\xb5\x84\xe2\xd6\x60\xbd\xb6\x2e\x6e\xeb\x90\xa8\xee\xce\
\x36\x8d\x7f\x21\x50\xd7\xab\x44\x08\x3a\xac\x69\x52\x83\xd6\x06\
\x34\x6a\x47\x54\x91\xea\xe5\x76\x68\x9e\x73\x0e\xf5\xb7\xff\xee\
\x37\xbe\x81\x88\x73\x50\xe7\x8b\x45\x1c\xb2\x90\x66\x2c\xa9\x34\
\x5c\xda\x6d\x0d\x5f\x6e\xe1\xd4\x0e\x7e\x25\x74\x02\x35\x52\x13\
\xbc\x4c\x93\x4e\xac\xf5\xdd\xd0\x2e\x91\xa0\xdd\xf8\x1c\x06\xdd\
\x85\x4a\xad\x55\x7a\xc6\x46\x64\x3c\x9b\xc4\x80\xb6\x8f\x1c\xe8\
\x66\xaf\x4a\x89\xa9\xd7\xfc\xfe\x6f\xfc\x9f\xfc\xcb\xff\xe1\x1f\
\x30\xce\x1d\x7b\x93\x12\xe1\x1d\x22\x18\xa4\xf0\xdc\x39\x9e\xc4\
\x74\x69\xb9\x60\x90\x0b\x5e\xbf\x35\x61\xb7\xaf\xd9\xdf\xc9\x19\
\xf6\x34\xbe\xa9\xb8\x73\xb8\x8b\x94\x92\xab\x97\x2f\xb9\x7b\x34\
\xc1\x7a\xcf\x62\x19\x73\xd4\x5e\x99\x31\x28\x73\x84\x8f\x4f\x1a\
\xba\x7f\x7b\x97\xfb\x77\x0f\x58\x4e\xa7\x68\x57\xb1\x3b\xee\xf1\
\xda\xfd\x23\x16\x8b\x35\x45\x26\xe8\x17\x19\xb7\x6e\xed\xb1\xb3\
\xd3\xa7\x59\x47\x75\x6b\xa9\x25\x59\x70\x8c\x77\xfa\x0c\x77\x77\
\x39\xba\x75\x42\xbd\x58\x70\x78\x6b\x8f\x50\x57\x7c\xfa\xec\x15\
\x10\x98\x5d\x5d\xb3\x7f\xb8\xc7\x72\xb5\xc2\x5a\xc7\x68\x5c\xe0\
\x9d\xe5\xf6\xdd\x23\x3e\x7b\xfc\x1c\x81\xc3\xaf\xe7\x94\x65\x8e\
\xb1\x8e\x6a\x3a\xe5\xe9\xc7\x9f\xf0\xc3\xbf\xf8\x01\x9f\x7d\xef\
\xdb\x7c\xfc\xd3\x47\xf8\x00\xf7\xdf\x7c\x83\xdd\xc3\x23\xac\xf1\
\xc8\xac\xcf\x68\xef\x90\xc9\xde\x3e\x4f\x7f\xfa\x29\xa7\x9f\x7d\
\x12\x27\x0a\x9a\x86\xd5\x74\xc5\x68\xbc\x43\x16\x2c\xbb\x45\xce\
\x9d\x93\x21\xfd\x61\x9f\xa6\x5a\xb1\xb3\x7b\xc8\x7a\x31\x23\x2f\
\x0b\x7c\x10\x94\xe5\x00\x5f\x3b\x26\xfb\x77\x79\xfd\x8b\xef\xd1\
\x58\x89\x99\xcd\x19\xed\xdf\x26\xc8\x3e\xb7\xef\xdf\x45\xbb\x05\
\xc2\xd4\xec\xbd\xfe\x6f\x53\x14\x23\xb4\xab\x78\xfa\xf4\x53\x8e\
\xef\xbe\x86\x92\x82\xc5\x6c\xce\xe1\xad\x07\x3c\xfe\xf6\x9f\x51\
\xaa\x06\x35\xdc\xc3\xa6\x06\xad\x76\xe2\xff\x56\x37\x46\x1c\x52\
\xa8\xe2\x53\x05\x54\x1a\xe2\xb6\x3d\x47\x2b\x72\x19\x6d\x4d\xa3\
\xba\xb4\x3d\x4b\x7d\xf9\x6d\x46\xb2\xfd\x48\x8b\xa8\x21\xdb\xa4\
\xf3\x6d\x43\xd5\x66\x76\x81\xeb\xc4\x94\xe1\xe6\x30\xd0\x54\x27\
\xa5\x1a\xa4\x1d\x57\xd4\xa2\x04\x4a\xb2\x79\xb6\x84\xb3\x14\x79\
\xbe\x05\x9f\x09\x10\x11\x53\x0e\x40\xb0\x11\x2f\x36\x3e\x72\x23\
\x8d\x69\x3a\x38\x56\x69\xd5\xc9\x4e\x62\x21\xb4\x6d\xed\x4d\x9c\
\x80\x48\x92\xb7\xcb\x38\x34\x38\x7a\x90\x9a\xac\xe8\x91\x65\x1b\
\xf5\xb0\xa9\x2b\x7e\xeb\x7f\xfb\x1f\x79\xf2\x47\xbf\xcd\xee\xb8\
\x40\xd9\x9a\x6a\xb6\x46\x49\xc8\xca\x02\xa5\x73\xea\x55\x85\xad\
\x16\xbc\xf7\xd6\x6d\x9a\xc6\x73\x72\xe7\x88\x17\x9f\x7d\x46\xa6\
\x14\xe3\xdd\x09\xb3\x4c\xa0\x32\xc9\xfd\xdb\x87\x94\xa3\xb7\x68\
\xa6\x57\xe4\xca\x50\x0d\x14\x8b\xf9\x94\x9d\xa3\x03\xe6\xd7\x4b\
\xde\x78\x78\xc0\x78\x3c\xc0\x09\xc1\xa0\x27\xd9\x1f\x6b\x5e\xbb\
\x73\x9f\xbd\x5b\xc7\x68\x19\xb0\x21\x0e\xb7\x96\x2a\x63\x30\xe8\
\x33\x9b\x5e\x31\x3e\xd8\x63\xe4\x3c\x93\x41\x86\x04\xf6\x8e\x8e\
\x62\x7a\x28\x40\x98\x8a\x1f\xff\xc1\x1f\xa1\xb3\x82\xa3\x61\xc9\
\x74\xb9\xc0\x9b\x8a\x5e\x19\xd8\xdb\x2d\x79\xfe\xf4\x15\x99\xd0\
\xf4\x07\x19\x57\xa7\x97\xcc\x2e\xa7\x50\x6b\x5e\x9c\xcf\xc8\x87\
\x03\x06\x8b\x8a\xc9\xee\x1e\xbb\x87\x47\x2c\xae\x97\x5c\x5f\x2d\
\x51\xd7\x73\x44\x96\xf1\xe8\x3b\x7f\xc9\xf0\xe4\x16\xc7\x0f\x1f\
\xf2\xe0\xc1\x5b\x0c\x77\x0f\x62\x3b\xb0\x82\x9d\x61\x9f\x42\xc5\
\x07\xed\xf4\x8b\x22\x8a\xfa\xca\x1d\x46\x59\xc3\xc1\x9d\x3b\xf4\
\x06\x63\x84\x37\xcc\xcf\x5e\x51\x0e\x77\x20\x2f\xe3\xec\xa8\xe5\
\x35\xcb\xf9\x92\x30\xca\xb9\x78\xf1\x8c\xf5\xac\xe2\xf6\x1b\xbf\
\xc2\x93\x17\x53\xca\xf1\x01\xb6\x91\xbc\xf7\x8b\xff\x1e\xbd\xb2\
\x64\x8d\x87\xf2\x80\x69\xb5\x64\x79\xb9\xe0\xe5\xd3\x17\xbc\xf9\
\xce\x5b\x88\x5e\x8f\x75\x63\xf8\xda\xdf\xf8\x4f\xf9\xf4\x3b\x7f\
\xc8\xda\x2d\x58\x07\xd5\xb5\x1a\xb4\xf5\x44\x3b\xd8\xad\xc8\xe3\
\x60\xea\x8e\x71\x0c\x89\x0c\xdc\xea\x15\xc9\xf3\x6c\x33\x64\x22\
\x0d\x02\xdc\x7e\x00\xd0\xf6\xa3\xe8\xda\x3f\x4a\x2b\x0a\x7a\xac\
\x56\xf3\x2e\x83\x51\x4a\xc5\x59\x09\x22\xf6\xbc\x6f\xd7\xc4\xdb\
\x33\xd2\x94\xd2\xa8\x5f\xfd\xbb\xbf\xf6\x8d\x00\x54\x55\xc3\xba\
\x5a\x77\x73\x69\xc5\xd6\xe8\x47\x29\x64\x9c\xcb\xab\x55\x37\xb3\
\xc8\x77\x8f\x5b\x13\x69\x7a\x45\x7a\x86\x48\x1b\xba\x20\xa5\x49\
\xa2\x23\x1c\xd9\x1a\x4d\x2a\x65\x9a\x9e\xad\xb3\xa8\xba\x4d\x72\
\x5d\x21\x24\x3a\xcf\xba\x91\x92\x52\x0a\x9c\x6d\xf8\x17\xff\xc7\
\x3f\xe2\xc9\xb7\x7e\x83\x61\x1e\xb0\x75\xc3\x72\x3e\x8f\xcd\x44\
\x85\xc6\x7b\x28\x86\x43\x94\x96\x94\x65\x8e\x27\xa2\x26\x7b\xfb\
\x23\x8c\x75\x8c\xf6\x26\xf4\x77\xf7\xd8\x3d\xd8\xa1\x57\x68\x6c\
\x1d\x0d\xab\x69\x2a\x16\x2b\xc3\x78\xdc\x63\x3c\x1e\x90\x29\x49\
\xaf\xd4\xdc\x39\x1e\x82\x08\x8c\xf7\xc6\x04\x29\xd8\x39\xdc\x63\
\x38\xe8\x71\x75\x7e\xcd\x70\x67\x88\x0f\x82\x75\xed\x98\x4e\x57\
\xd4\xc6\xf3\xce\xbb\x6f\x92\x85\x0a\x29\xe2\x84\x92\x6c\x30\xe6\
\xf6\xdb\x5f\x62\xb0\x37\xc1\x38\xc9\xec\xfa\x1a\xa5\x05\xbd\x71\
\x8f\xdb\x0f\x6e\x53\x0e\x32\x6e\xdd\xda\x65\x34\x28\x18\x8d\x7b\
\x28\x01\x3b\xbb\x03\x4e\xee\x9e\x10\xea\x8a\x5b\x77\x4e\xb8\x3a\
\x3b\xe5\xce\x9d\x63\xc6\x1a\x0e\x26\x05\xc5\x60\xc4\x47\xef\x7f\
\x48\xb3\xbc\xe2\xf8\xce\x6b\xcc\xe6\x16\x53\xd7\x94\xe5\x00\xb3\
\x5a\xf3\xe2\xa7\x9f\xf1\xf1\x5f\xfe\x39\xce\xd5\x7c\xf2\x83\x1f\
\x51\x5d\x9d\x23\x8d\xa1\x5f\xf6\x08\xd6\xa0\xbc\x61\x77\x18\xb8\
\xf7\xf6\x9b\x1c\xdf\xde\x61\xe7\x70\x12\xe7\x9b\xf9\x40\xd9\xef\
\x61\x96\x53\xaa\xe9\x05\xbe\x5a\xb3\x38\x7d\x4a\xd1\xef\x03\x86\
\xe1\xce\x01\xeb\xd9\x35\xb3\x6a\xc0\x78\x3c\x46\xb9\x29\xc3\x41\
\x1f\x2d\x0d\x57\xcf\x3f\xe2\xe8\xd6\x7d\xe6\x57\x53\xfa\xfd\x31\
\xb3\xab\x0b\xca\x71\xc1\xde\xe1\x01\xc3\xf1\x84\xf9\xf5\x14\x29\
\x25\xe3\xe3\x7b\x94\x5a\x71\x31\x5f\x74\x0f\xd5\x51\xa9\x37\x47\
\xa6\x27\x06\x90\x10\xd4\xd8\x28\xd7\x2a\xc0\x43\x17\x19\xf2\xbc\
\xe8\xa0\xdb\xf6\xb1\x1b\x59\x5e\x74\xfd\x28\xdb\xb0\xed\x76\x3b\
\x70\x4c\xe9\x2c\xa6\x89\x7c\x8c\x77\x3e\x75\xc6\xea\xad\x87\x3d\
\xb9\xad\x14\x50\x22\x50\x69\x10\x22\xa9\x48\x0f\xb1\x08\x5f\x2e\
\xe7\x0c\x86\x3b\xe9\x49\x50\xb2\x93\x2d\x47\x55\x6c\xe8\xa4\xcf\
\xad\x85\x0a\x21\xd0\x32\x12\x79\x5a\x24\xb9\xbb\x52\xb0\x35\x25\
\x25\x16\xd6\xb6\x93\xa1\x6c\x06\x5e\x47\x74\x21\xea\x73\x92\x6e\
\x47\xca\x6e\x02\x5f\x0b\xd3\xcd\xaf\x2f\xf8\xed\x7f\xfc\x0f\x79\
\xf5\xed\x6f\xd2\xac\xe6\x58\x29\x18\x8f\x0a\xf2\xc9\x90\xd5\x72\
\x01\x5a\xb0\xb3\xb7\x87\x40\x30\x18\xf4\x99\xcf\x17\x94\x99\xe6\
\xf6\xc3\x3b\x54\x8d\x65\x55\xc7\x99\x58\x45\x59\x50\x79\xcb\x60\
\x38\x62\xb5\x58\xd2\xeb\xf7\xb9\x3a\x3b\xe3\xee\xdd\x3d\x42\xf0\
\xd4\x8d\xe5\xec\x7c\xc9\x64\x3c\x64\xb1\x58\xb2\xb3\xb7\x43\x35\
\x9d\x81\xd4\xac\x5c\xe0\xec\x62\xcd\xa3\x9f\x3c\xa3\x28\x3e\xc3\
\x78\x89\xc4\x73\xeb\xd6\x3e\x8b\x17\xe7\x2c\x8e\x86\xec\x1f\xec\
\x71\xeb\xc1\x03\x9e\x3e\x7d\xc5\xde\xdd\xb7\x58\x1b\x8f\x92\x8e\
\x20\x25\xcb\x6a\xc5\xde\xeb\x5f\xa4\x5e\x4c\xc9\x77\x26\xdc\x3f\
\xb9\xc5\x8b\x4f\x7e\x42\xd9\x53\x8c\x77\x77\xa8\xea\x15\x93\xc9\
\x88\xde\x20\x67\xf7\xcb\xf7\x59\xac\x05\x57\xd7\x57\x18\xd3\xb0\
\x7b\x3c\x61\x6f\x6f\xc2\xec\xf4\x8c\xf7\xee\xf5\x29\x74\xc9\xfe\
\x51\x0f\xb9\x98\xb3\xf6\x65\x1c\xe9\x29\x04\xbd\x4c\xe3\x9b\x9a\
\xea\xc5\x29\xcd\x72\x4e\x96\x95\x94\xc3\x09\xae\x5a\xb3\xbf\xbf\
\x8f\xab\xce\x78\xfb\x6b\xef\x52\xcd\x97\xec\xec\x0e\x09\xde\x61\
\xd7\x33\xa4\xb3\xac\xe6\xd7\x04\x60\x79\xfa\x8c\xd9\xc5\x39\xc5\
\x60\x82\x59\x37\x1c\x9c\xbc\x4e\xd0\x25\x32\x2b\x99\x1c\x1d\x33\
\x18\x8e\x91\xc2\xf3\xf6\x57\xbe\xc6\xd5\xcb\x27\x3c\x9a\xbf\x44\
\xf9\x19\xc1\x28\xd6\x36\x50\x28\xc9\xe5\xcb\x57\x54\xeb\x35\xa3\
\x5d\xc1\x60\x34\xc4\xd6\xb1\xaf\xff\xe0\xfe\xbb\xbc\xd7\xdf\xe3\
\x83\x0f\xbe\x9f\x1e\x8b\x90\x88\xe2\xd4\x9e\x10\x59\xf8\xf8\xfc\
\x10\xa9\x14\x4a\xc6\xa9\xf3\xc6\xc4\xe9\x9d\x5e\x6d\xd0\xa5\x38\
\x47\x2c\x47\x74\x92\x13\x95\xba\x4b\x4d\x9a\x50\x9f\x75\x53\x1e\
\x9b\xa6\xc1\xd9\x26\xce\x2d\xa6\x35\xb8\xad\x91\x56\xc1\xc7\x87\
\x0f\xc9\x56\xf2\x14\xe3\x93\x40\xc5\x19\x6f\x7f\xe7\xef\xfd\xda\
\x37\xe2\xc4\x88\x28\x1b\x6e\xe5\xe3\x51\xff\x15\x27\x7e\xa8\x34\
\x37\xb6\x45\x9c\xba\x4e\xbd\xd4\xb7\xbc\xe1\x41\xda\xc8\x90\xa6\
\x92\xb7\xed\xb9\x49\x7e\xde\x35\x2f\x25\x52\xb0\x9b\xa9\x9b\x72\
\x3c\x25\x55\x1b\x68\x90\x52\xf2\xe2\xd3\x0f\xf9\xc7\xff\xe0\xbf\
\xe6\xe2\xc3\xef\x80\x6d\x18\x94\x19\xc3\x51\x8f\xfd\x83\x11\x45\
\xbf\xc7\xce\xde\x1e\xfd\xd1\x18\x11\xe0\xe0\xf0\x80\xe5\x6c\x46\
\x56\x68\x5e\xbb\x73\x80\x56\x11\x2a\xec\x65\x92\x93\x5b\xc7\x38\
\x1f\x58\xce\x63\xc1\xde\x54\x0e\xbb\x5a\x50\x16\x71\x8a\xa3\xd0\
\x39\x83\xe1\x88\xb3\x57\x53\x3e\x7b\x3a\x65\xb6\x32\x3c\x7b\x3e\
\xe5\xd5\x59\xcd\x47\x8f\xaf\x78\xfa\x7c\xca\x72\xd1\xd0\x1f\xf4\
\x99\xec\x8e\xb1\x8d\xa1\xcc\x14\x4a\x41\xa1\x15\x67\x67\x73\xca\
\x42\xb3\x33\x54\x1c\x9e\x1c\x11\xb2\x82\x8b\xd3\x97\xc8\xe0\x19\
\x0f\x73\x6e\xdf\x3d\xe4\xf8\xb5\xdb\xbc\xf9\xd5\xaf\xe1\x6d\xcd\
\xe4\xd6\x2d\xb2\xde\x08\x91\xf7\xe8\xef\x9e\x60\x8d\xe1\xf2\xfc\
\x12\xa5\x35\xc5\x70\x80\x37\x35\x4e\x14\x58\xeb\xb1\x41\x70\xfb\
\xc1\x03\xa6\x67\xaf\xe8\x0f\xfb\xf4\x47\x23\x5e\x3e\x7b\x8e\xd0\
\x01\xad\x1c\x87\x87\x13\x0e\x87\x39\x99\x5b\x93\x2b\xcf\x62\x36\
\xc3\x3b\xc3\x62\xb6\xa4\xec\xf5\xc9\x7b\x23\x46\x7d\xc9\x5b\xef\
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
