jabezmcc/Prooferator/(commit log)

2022-01-17 crop arduino image
2022-01-18 added circuit
2022-03-12 version 0.1.2
    [proofingbox.xlsx]
